buglalis/degree/img/fabrication_ready.jpg

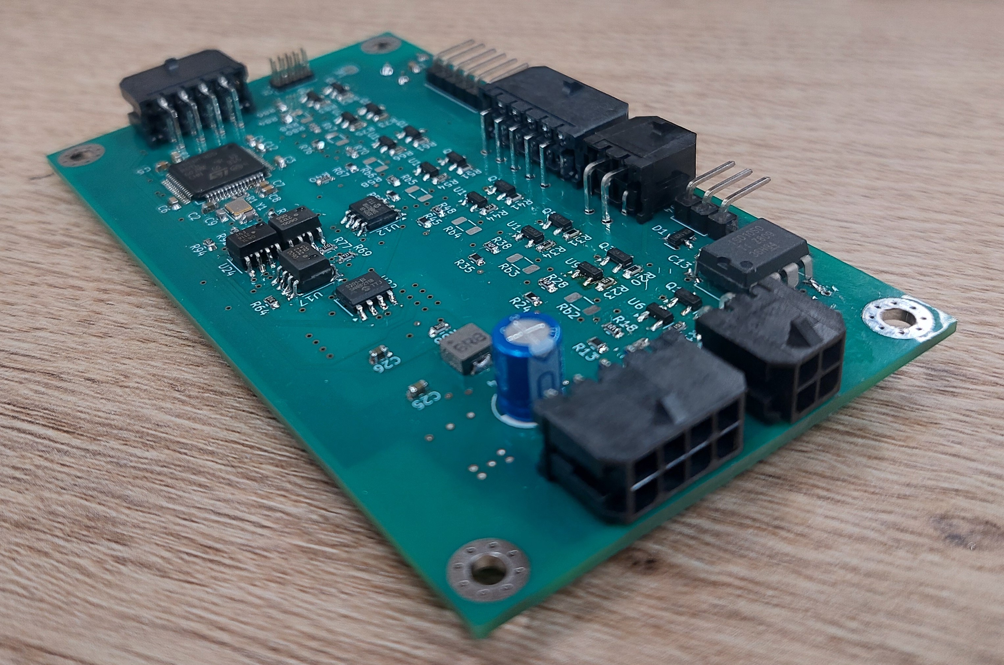
img/fabrication_ready.jpg
