buglalis/degree/img/ant_bms_1.jpg

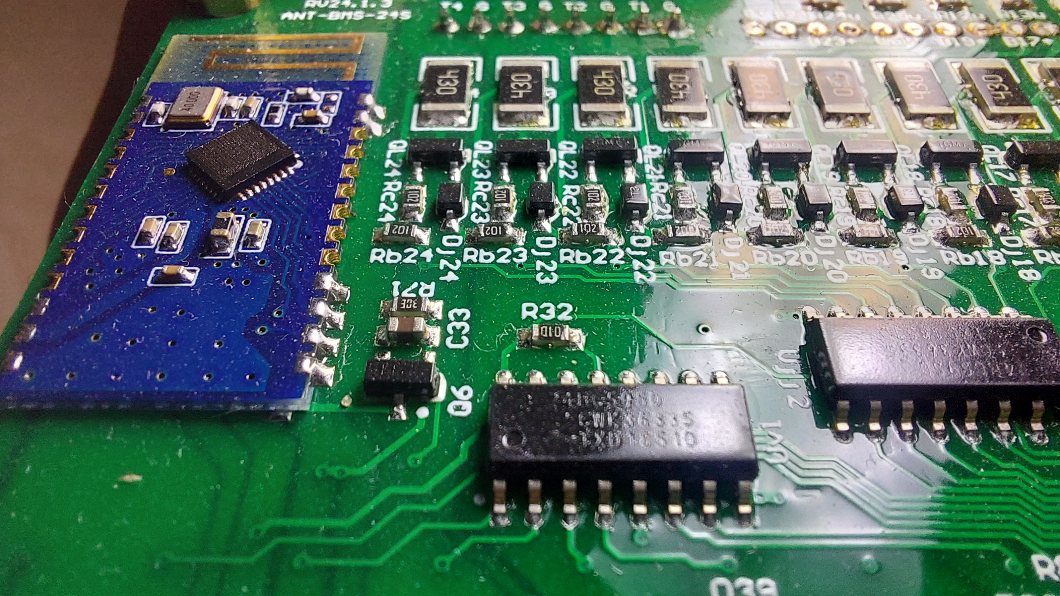
img/ant_bms_1.jpg
