buglalis/degree/notes/acronims.tex

\DeclareAcronym{bms}{
  short=BMS,
  long=Система контроля и управления аккумуляторной батареей (Battery Managment System),
}

\DeclareAcronym{soc}{
  short=SOC,
  long=State of Charge,
}

\DeclareAcronym{su}{
  short=СУ,
  long=cиловые установки,
}

\DeclareAcronym{la}{
  short=ЛА,
  long=летательный аппарат
}

\DeclareAcronym{ed}{
  short=ЭД,
  long=электродвигатель
}

\DeclareAcronym{bpla}{
  short=БПЛА,
  long=беспилотный летательный аппарат
}

\DeclareAcronym{trd}{
  short=ТРД,
  long=турбореактивный двигатель
}

% как использовать акронимы?
% 
%  \ac{name}
%  \acs{name} - короткое название
%  \acl{name} - длинное название
%
