buglalis/degree/notes/rewiew/modul.tex

\textbf{Монолитная BMS ---} разработаны для определенных конфигураций блоков. 
Например, \acs{bms} расчитана на 8-24s батарею.
Немодульные решения предполагается использовать там, 
где размер и конфигурация аккумуляторной батареи остаются постоянными. 
Они устраняют необходимость в дополнительной проводке.

\textbf{Модульная система управления ---} состоит из нескольких блоков, 
которые можно легко соединять или отключать для реализации различных конфигураций батарей. 
Это обеспечивает гибкость при создании батареи, масштабируемость, простоту обслуживания.
Однако подобные решения могут иметь большее кол-во проводки и усложнение элементов корпуса, 
что может отразится на цене и весе батареи.

Примером модульной системы является проект с отрытым исходным кодом --- Smart BMS (см. \figurename\ref{fig:smart_bms})
\begin{figure}[h]
	\centering
	\begin{minipage}{0.32\linewidth}
		
		\subcaption{Плата-slave(вид сбоку)}
	\end{minipage}
	\begin{minipage}{0.32\linewidth}
	    
	    \subcaption{Плата-slave(вид сверху)}
        \end{minipage} 	
	\begin{minipage}{0.32\linewidth}
	    
	    \subcaption{Плата-master}
    \end{minipage}
\caption{Составляющие Smart BMS}
\label{fig:smart_bms}
\end{figure}
