buglalis/degree/notes/review.tex

\section{Развитие электрических \acs{la}}
\input{notes/rewiew/la.tex}

\section{Литий-ионные батареи $-$ обзор}
\input{notes/rewiew/lion.tex}

\section{Методы баласировки}
\input{notes/rewiew/balance_sheet.tex}

\section{Способы компоновки батареи (модульность BMS)}
\input{notes/rewiew/modul.tex}

\section{Режимы работы системы \glqq батарея$-$нагрузка\grqq}
\input{notes/rewiew/mods.tex}

\section{Обзор методов активной балансировки}
\input{notes/rewiew/active_balacing.tex}

\section{Сравнение методов активной балансировки}
\input{notes/rewiew/comparison.tex}

\section{Решения сущевствующие на рынке}
\input{notes/rewiew/solutions.tex}

\section{Формализация задачи}
\input{notes/rewiew/form.tex}

% \section{Установка ограничений}
% \input{notes/rewiew/limits.tex}

% \section{Сравнение сущевствующих схем}

% \section{Поиск оптимальной конфигурации для решения конкретной задачи}
% \input{notes/rewiew/balancing_conclusion.tex}
