buglalis/degree/notes/body.tex

\section{Разработка}
\input{notes/body_notes/develop.tex}

\section{Производство}
\input{notes/body_notes/fabrication.tex}

\section{Испытания эксперементального изделия}
\section{Анализ результатов экспериментов}
