buglalis/degree/notes/comparison.tex

Для сравнения схем активной балансировки будем использовать следующие параметры
> 1) Стоимость
> 2) Габариты
> 3) Эффективность балансировки
> 4) Кол-во лап процессора на одну ячейку 
> 5) ЭМИ шум
