buglalis/degree/src/page_header.tex

\pagestyle{fancy}
\fancyhead[RE,LO]{\textsc{Физтех}}
\fancyhead[LE,RO]{\textsc{ФАЛТ}}
\fancyhead[CO,CE]{\leftmark}
