buglalis/degree/notes/body_notes/develop.tex

Как было сказано выше, для разработки была выбрана пассивная BMS.
В качестве микросхемы для определения порогового напряжения была выбрана TL-431. 
\subsubsection{Краткое описание микросхемы:}
Регулируемый источник опорного напряжения.
Используется для мониторинга напряжения на ячейке, сигнал выдаваемый схемой имеет нелинейную 
зависимость(см. \figurename  \ref{fig:tl431_curve_cathode_v_i}). 
На кривой видно, что при напряжении 2.5В и более на K-Ref, ток K-A максимален, 
источник опорного напряжения пропускает ток.

\begin{figure}[h]
	\centering
	\begin{minipage}{0.54\linewidth}
		
		\subcaption{Распиновка TL431A}
		\label{fig:tl431_pinout}
	\end{minipage}
	\begin{minipage}{0.45\linewidth}
        \centering
        
        \subcaption{Зависимость тока от напряжения на катоде}
        \label{fig:tl431_curve_cathode_v_i}
    \end{minipage}
\caption{TL431}
\label{fig:tl431_review}
\end{figure}

\subsubsection{Описание работы принципиальной схемы}
Балансировочная схема состоит из двух частей:
ключ с балансировояным резистром и триггер Шмитта, 
который настроен на разрядку ячейки в некотором диапазоне напряжений.
Ключом явлется полевой N-MOSFET транзистор $Q_2$, через него проходит ток балансировки. 
Значение тока балансировки настраивается номиналом балансировочного резистра $R_b$.
В триггер Шмитта входят все остальные элементы, а именно: резистры $R_1$ - $R_6$, 
биполярный pnp транзистор $Q_1$ и $TL431$.

Ниже представлена принципиальная балансировочная (см. \figurename  \ref{fig:principial})
\begin{figure}[h!]
    \centering
    
    \caption{Принципиальная схема балансровки}
    \label{fig:principial}
\end{figure}

Схема имеет выраженный гистерезис $-$ балансировка начинается при более высоком напряжении чем закачивается.

\subsubsection{Поэтапный алгоритм работы схемы}
Для описания алгоритма введём следующие величины: \\
$V_{\text{bat}}$ -- напряжение ячейки. \\
$(V_1, V_2)$ -- диапазон балансировки. \\
$V_{ref}$  -- опорное напряжение $TL431$ равное 2.5В
При достижении $V_2$ балансировка начинается, когда падает до $V_1$ балансировка выключается.

\begin{enumerate}
    \item \textbf{Состояние 0}: напряжение $V_{\text{bat}}$ значительно меньше $V_2$ (см. рис.~\ref{fig:algoritm_part_0}). \\
    Ток не идёт через $Q_1$, $Q_2$, $TL431$. \\
    Напряжение на съёмном плече делителя напряжения, обозначенного синей рамкой, меньше 2.5~В.

    \item \textbf{Состояние 1}: напряжение $V_{\text{bat}}$ увеличивается и подходит близко к $V_2$.
    $TL431$ начинает пропускать слабый ток, который в том числе проходит и через транзистор $Q_1$.
    Получаем лавинообразный процесс. Чем больше ток через $TL431$, тем больше ток через $Q_1$. 
    Тем выше напряжение на контакте REF $TL431$. И наконец, тем выше ток через $TL431$.

    \item \textbf{Состояние 2}: \\
    Ток базы на $Q_1$ становится достаточным для его открытия. Напряжение доходит до резистора $R_4$.
    Тем самым резисторы $R_3$, $R_4$, $R_5$ образуют новый делитель напряжения. 
    
\end{enumerate}

\begin{figure}[h!]
	\centering
	\begin{minipage}{0.5\linewidth}
		
		\subcaption{Напряжение ниже диапазона балансировки}
		\label{fig:algoritm_part_0}
	\end{minipage}
    \begin{minipage}{0.49\linewidth}
        \centering
        
        \subcaption{Инициация открытия $Q_1$}
        \label{fig:algoritm_part_1}
    \end{minipage}
	\begin{minipage}{0.49\linewidth}
        \centering
        
        \subcaption{ключ $Q_2$ открыт}
        \label{fig:algoritm_part_2}
    \end{minipage}
    \begin{minipage}{0.5\linewidth}
        \centering
        
        \subcaption{}
        \label{fig:algoritm_part_3}
    \end{minipage}
    \caption{состояния схемы}
    \label{fig:balance_algoritm}
\end{figure}

\subsubsection{Расчёт компонентов}
Резистор $R_6$ является подтягивающим, его номинал не влияет на остальную схему, 
номинал выбран стандартный -- 10k$\Omega$ \\
Номиналы резистров $R_3$, $R_4$, $R_5$ выбираются изходя из выбраного диапазона балансировки ($V_1 = 4.15$ В  $, V_2 = 4.21$ В).
Из пропорции для делителей напряжения получаем отношения для сопротивлений, 
которые необходимо брать порядка нескольких k$\Omega$, чтобы ток через делитель был незначительным.

\begin{figure}[h]
    \begin{equation*}
        \frac{V_2}{V_{ref}} = \frac{R_3 + R_5}{R_5} \\
    \end{equation*}
    \begin{equation*}
        \frac{V_1}{V_{ref}} = \frac{\frac{R_3 R_4}{R_3+R_4} + R_5}{R_5}  \\
    \end{equation*}
\end{figure}

Получаем  
\begin{figure}[!h]
    \begin{equation*}
        R_3 = \left(\frac{4.21}{2.5} - 1 \right) R_5 \\
    \end{equation*}
    \begin{equation*}
        R_4 = \frac{R_3 R_5  \left(\frac{4.17}{2.5} - 1\right)}{R_3 - \left(\frac{4.17}{2.5} - 1\right) R_5}
    \end{equation*}
    
\end{figure} 

Приняв номинал $R_5$ за 12k$\Omega$, получим $R_3 \approx$ 8.2k$\Omega$, $R_4 \approx$ 220k$\Omega$

\newpage
