buglalis/degree/notes/rewiew/active_balacing.tex

Для начала расмотрим два простейших метода: через электрический конденсатор или катушку индуктивности.
Под "простейшими" подразумевается, что конденсатор или катушка будет переносить энергию от одной ячейки к другой напрямую. 
При этом электрическая схема и алгоритм балансировки наиболее простой.

\subsection{Ёмкостные схемы}
\setlength{\headheight}{14pt}
    Самый примитивный способ переноса заряда между ячейками $-$ через конденсатор. (см. \figurename\ref{fig:capasitors_models})
Простейшая схема состоит из единственного конденсатра, который с помощью ключей соединяется с разными ячейками поочередно.
Метод не требует сложного управления. Энергия передаваемая от одной ячейке к другой эквивалентна разнице напряжений.
Важно только выдерживать допустимую частоту переключения, которая зависит от характерного времени цикла зарядки/разрядки. 
Метод имеет огромный недостаток, чем меньше разбаланс $-$ тем медленнее переносится энергия. 
Не смотря на довольно высокую точность порядка 1мВ, дисбаланс в 10 мВ устранялся в течении 19 часов (см. статью \cite{daowd2013single}).\\
На практике используется схема из несколькольких рядов конденсаторов, время балансировки около удовлетварительное.
Например, $n$ ячеек $n-1$ ёмкостей для 1-го ряда и $n-2$ для 2-го ряда, или только первый ряд.
Тут имеет место компромисс между стоимостью и временем выравнивания $-$ четырехкратное уменьшение времени выравнивания 
при увеличении емкости всего на 50\% (см. статью\cite{baughman2008double}), (см. \figurename\ref{fig:capacitors_res}).
Двухуровневая схема балансирует быстрее одноуровневой за счет уменьшения тока на ёмкостях 1-го ряда.
Стоимость реализации двухуровневого метода
несколько выше за счёт большего кол-ва конденсаторов и переключателей.

\begin{figure}[h]
	\centering
	\begin{minipage}{0.25\linewidth}
		
		\subcaption{Один ряд конденсаторов}
        \label{fig:capasitors_models_single}
	\end{minipage}
	\begin{minipage}{0.34\linewidth}
	    
	    \subcaption{Два ряда конденсаторов}
        \label{fig:capasitors_models_double}
    \end{minipage} \\	
    \caption{Схемы на конденсаторах}
    \label{fig:capasitors_models}
\end{figure} 

Рассмотрим схему с двумя рядами конденсаторов. 
Заряд, передаваемый от батареи к батарее проходит через ярусы конденсаторов. Чем больше рядов, тем меньше сопротивление для переноса заряда и тем больше путей переноса заряда.
Например расмотрим \figurename\ref{fig:capasitors_models_single}. 
Заряд от $B_3$ к $B_1$ не может поступать напрямую, в отличие от схемы с двумя рядами (см. \figurename\ref{fig:capasitors_models_double}).

\begin{figure}[h!]
	\centering
	\begin{minipage}{0.49\linewidth}
	    
	    \subcaption{Зависимость тока от частоты}
        \label{fig:capacitor}
    \end{minipage} 
    \begin{minipage}{0.5\linewidth}
	    
	    \subcaption{Сравнение скоростей балансировки}
        \label{fig:capacitors_res}
    \end{minipage} \\	
    \begin{minipage}{0.4\linewidth}
		
		\subcaption{График модели RC цепи}
        \label{fig:capasitor_graph}
	\end{minipage}
\end{figure} 

Нас интересует результирующий средний ток, который расчитывается на основе частоты переключения.
Такой ток и будет называться балансировочным. 
Даже если усредненный по времени ток через любой конденсатор равен нулю, ток
входит в конденсатор через одну батарею или один набор батарей
и выходит через другую. Таким образом, ток использует
конденсатор как путь между батареями(см. \cite{kimball2005analysis}, \cite{kimball2005modeling})

\begin{align*}
    I_C = C \frac{\Delta V}{\Delta t} = C \Bigl( V'_{C_A} -  V'_{C_B} \Bigr) \nu_{switch}
\end{align*} 

Где напряжения $V'_{C_A}, V'_{C_B}$ описывают граничные напряжения в графике зарядки/разрядки конденсатора,
на графике \figurename\ref{fig:capasitor_graph} процесс моделируется простой RC цепочкой.

\subsection{Схемы на индуктивностях}
    Метод подключения аналогичен ёмкостному. 
Такой подход реализует принцип хранения энергии в магнитном поле катушки.
Эффективность этого метода напрямую зависит от точности определения напряжений на ячейках.
Стоит отметить, что при повышении частоты в схему необходимо включить фильтрующие конденсаторы.
Метод требует более сложного алгоритма управления, имеет большую скорость балансировки чем ёмкостной метод.

\begin{figure}[h!]
    \centering
    
    \caption{Схема балансировки на одном дросселе}
    \label{fig:inductions_models}
\end{figure}

\cite{noh2021design}, \cite{vardhan2017modeling}

% {PowerPump}

\subsection{Схемы на трансформаторах}
Ключевые моменты{Быстро балансирует, высокий КПД(греется но не так сильно как остальные), 
компактность, дорого стоит, нужно подбирать сердечник под кол-во ячеек в параллели}
(см. статью \cite{abronzini2019high})

% forward, flyback
Теперь остановимся на преобразователях постоянного тока, 
В таких схемах используются те же конденсаторы, катушки и трансформаторы, 
однако управление такими схемами достаточно сложное, необходимо использовать высокие частоты,
часто появляется задача изучить переходные процессы между состояниями электрической схемы. 
\subsection{Импульсные DC/DC преобразователи}
Можно выделить 4 очень похожих друг на друга схемы: повышающий и (или) понижающий (Buck or/and Boost converter), 
и инвертирующий ({\'C}uk) конвертеры.
В данной работе будет рассмотрен только {\'C}uk конвертер. 
Остальные схемы будут схожи в управлении.

\subsubsection{Принцип работы балансировки по схеме Чука}
Расмотрим простейшую схему из 2 ячеек. 
На затвор $Q_1$ и $Q_2$ приходит ШИМ. С одинаковым коэффициентом заполнения и инвертированным друг относительно друга.
Передача энергии может идти в обе стороны. 
Направление и величина тока определяется коэффициентом заполнения и частоты ШИМ - $\alpha$(см. выкладки ниже).
Вывод произведен упрощённым методом для усреднённой модели.

\begin{align*}
\intertext{$Q_1$ открыт, $Q_2$ закрыт}
    U_1 &= L_1 \dv{i_{L_1}}{t} \\
    U_2 &= -L_2 \dv{i_{L_2}}{t} + V_C \\
\intertext{$Q_1$ закрыт, $Q_2$ открыт} 
    U_1 &= L_1 \dv{i_{L_1}}{t} + V_C \\
    U_2 &= -L_2 \dv{i_{L_2}}{t} 
\end{align*} 
\begin{gather*}
\intertext{Равенство нулю вольт-секундного интеграла на $L_1$ и $L_2$} 
    \frac{1}{T}\int_0^T V_L \mathrm{d}t =  \overline V_L \\
    U_1 \alpha \nu + (U_1 - V_C)(1 - \alpha) \nu = 0 \\
    -(U_2 + V_C) \alpha \nu + (-U_2)(1 - \alpha) \nu = 0
\end{gather*}
\begin{gather*}
\intertext{Выразим средний ток на катушках через равенство напряжений на конденсаторе $C$} 
    i_{L_1}(1 - \alpha) \nu_{sw} - i_{L_2}\alpha \nu_{sw} = 0 \\
    i_{L_1} = \frac{1}{2} \Biggl[\frac{U_1}{L_1} \alpha^2 + \frac{U_1 - V_C}{L_1}\left( 1 - \alpha\right)^2 \Biggr] \nu_{sw} \\
    i_{L_2} = \frac{1}{2} \Biggl[\frac{V_C - U_2}{L_2} \alpha^2 + \frac{-U_2}{L_2}\left( 1 - \alpha\right)^2 \Biggr] \nu_{sw}
\end{gather*} 
Таким образом на каждой из ячеек начинаются колебания как в $LC$ цепочках. 
За счёт ШИМа среднее значение токов смещается в верх для более заряженой ячейки и вниз для менее заряженой. (см. \figurename\ref{fig:cuk_transit}).
Подробнее про этот метод в статье \cite{moghaddam2019battery}, а также симуляция в Falstad \href{\cuksheme}{\color{blue}{"ссылка"}}.

\begin{figure}[h!]
    \centering
    
    \caption{Переходный процесс во время балансировки методом Чука}
    \label{fig:cuk_transit}
\end{figure}

\subsection{Полномостовой преобразователь}

\subsection{Рамповый преобразователь}

\subsection{Квази-резонансный преобразователь}
