buglalis/degree/notes/rewiew/lion.tex

% За последние десятилетия литий-ионные аккумуляторы превратились из дорогих и не распространённых 
% в стандартные источники питания, используемые в самых различных областях. 
% Стоит сразу отметить, что для литий-ионного аккумулятора характерна высокая пожароопасность, об этом будет сказано ниже. \\
% Несмотря на то технология литиевых источников тока была известна достаточно давно, 
% и в конце XX века литиевые батареи активно использовались в различных устройствах.
% Только в 1991 году Акира Ёсино изобрёл литий-ионный аккумулятор, который широко используется сегодня. 
% Данная технология позволила значительно увеличить плотность энергии. (см. статью\cite{admt_201700376} ). 

% Как бы хорошо не был «укрощен» литий, аккумулятор остаётся опасным устройством, 
% так как в его составе находятся сильный окислитель и восстановитель, разделённые тонким полимерным сепаратором. 
% При нарушении целостности сепаратора происходит каскадная реакция, сопровождаемая нагревом.
% Содержимое аккумулятора превращается в первокласную взрывчатую смесь топлива и окислителя. И эту субстанцию уже подожгли.
% Существует много встроенных мер обеспечения безопасности Li-ion аккумуляторов, которые работают автономно.
% Но литий-ионные аккумуляторы остаются достаточно чуствительными к небрежной эксплуатации. 
% Там, где применяется литий-ионный аккумулятор, нет места простейшим зарядным устройствам из мира «свинца» и «никель-кадмия». 
% Зарядное устройство обязано быть «умным». Процесс зарядки литий-ионного аккумулятора многостадийный, 
% предполагает строгое выдерживание параметров, должен быть вовремя завершен. Перекладывание ответственности на пользователя не допустимо.

% Основными проблемами эксплуатации можно назвать перезаряд и переразряд.
% Иначе можно сказать, что важно выдерживать оптимальный диапазон напряжений при работе с аккумулятором.
% Перенапряжение в ячейке приводит к электролизу компонентов электролита и дальнейшему выделению газов, 
% давление которых может нарушить герметичность аккумулятора, 
% это также приводит к пожару так как получившая смесь графита и лития самовоспламеняется на воздухе.
% При больших токах разряда(графит не успевает «впитывать» литий) 
% и при переразряде(графит теряет активную поверхность) образуется металлическая фаза лития, 
% которая в дальнейшем приводит к образованию дендритов(древовидные образования) нарушающих обшивку аккумулятора. 
% Опасна и перегрузка во время разряда. 
% Перегрев вызывает вскипание или термическое разложение электролита, 
% выделение кислорода из катодной активной массы, повреждение сепаратора. В результате -- короткое замыкание и взрыв. 
% Подобные результат будет при повреждении ячейки, только к окислителю добавится кислород из атмосферы.

% В последние десятилетия литий-ионные аккумуляторы прошли путь от дорогостоящей и малораспространённой технологии 
% до универсального источника питания, применяемого в самых разнообразных сферах.

% Стоит отметить, что одним из ключевых недостатков литий-ионных батарей является их высокая пожароопасность, 
% что подробно рассмотрено далее.

% Хотя принципы работы литиевых источников тока были известны уже давно, 
% лишь к концу XX века литиевые батареи начали активно использоваться в электронике. 
% Прорыв в этой области произошёл в 1991 году, когда Акира Ёсино разработал литий-ионный аккумулятор, 
% ставший основой для современных энергоносителей. 
% Внедрение этой технологии позволило существенно увеличить плотность хранения энергии (см. статью \cite{admt_201700376}).

% Несмотря на успешное решение многих технических проблем, литий-ионные аккумуляторы остаются потенциально опасными устройствами. 
% Это обусловлено тем, что в их конструкции содержатся мощные окислитель и восстановитель, разделённые тонким полимерным сепаратором. 
% Если его целостность нарушается, запускается каскадная реакция, сопровождающаяся интенсивным нагревом. 
% В результате содержимое аккумулятора превращается в высокоэнергетическую смесь топлива и окислителя, готовую к воспламенению.

% Для снижения рисков в конструкции Li-ion батарей предусмотрено множество автономных систем безопасности. 
% Однако, несмотря на эти меры предосторожности, аккумуляторы остаются весьма чувствительными к неправильной эксплуатации. 
% Они требуют использования специализированных зарядных устройств, 
% поскольку применение примитивных аналогов, разработанных для свинцово-кислотных или никель-кадмиевых батарей, 
% может привести к катастрофическим последствиям. Процесс зарядки литий-ионных элементов многостадийный и требует точного 
% соблюдения параметров, исключая возможность случайных ошибок со стороны пользователя.

% К числу основных эксплуатационных проблем можно отнести перезаряд и переразряд. 
% Оптимальный диапазон напряжений должен строго выдерживаться при работе с аккумулятором. 
% Перенапряжение внутри ячейки способно вызвать электролиз компонентов электролита с последующим выделением газов, 
% что может привести к разгерметизации батареи и возникновению пожара. Это обусловлено тем, что смесь лития и графита, 
% оказавшись в контакте с воздухом, самовоспламеняется.

% Высокие токи разряда или глубокий переразряд также представляют серьёзную угрозу. 
% В первом случае графитовая структура не успевает поглощать литий, 
% а во втором теряет активную поверхность, что способствует образованию металлической фазы лития. 
% Со временем это может привести к росту дендритов — иглообразных кристаллов, разрушающих оболочку аккумулятора.

% Не менее опасна перегрузка во время разряда. Перегрев приводит к закипанию или термическому разложению электролита, 
% выделению кислорода из катодного материала и разрушению сепаратора. 
% Всё это ведёт к короткому замыканию и возможному взрыву. 
% Если же повреждение ячейки сопровождается попаданием кислорода из окружающей среды, 
% вероятность возгорания возрастает многократно.

% Перегрев вызывает вскипание или термическое разложение электролита, 
% выделение кислорода из катодной активной массы, повреждение сепаратора. В результате -- короткое замыкание и взрыв. 
% Подобные результат будет при повреждении ячейки, только к окислителю добавится кислород из атмосферы.

В последние десятилетия литий-ионные аккумуляторы прошли путь от дорогостоящей и малораспространённой технологии 
до универсального источника питания, применяемого в самых разнообразных сферах. 
Стоит отметить, что одним из ключевых недостатков литий-ионных батарей является их высокая пожароопасность, 
об этом будет сказано ниже.

Хотя принципы работы литиевых источников тока были известны уже давно, 
лишь к концу XX века литиевые батареи начали повсеместно использоваться в электронике. 
Прорыв в этой области произошёл в 1991 году, когда Акира Ёсино разработал литий-ионный аккумулятор, 
ставший основой для современных энергоносителей. 
Внедрение этой технологии позволило существенно увеличить плотность хранения энергии (см. статью \cite{admt_201700376}).

Несмотря на наличие встроенных мер безопасности, литий-ионные аккумуляторы остаются потенциально опасными устройствами. 
Это обусловлено тем, что в их конструкции содержатся мощные окислитель и восстановитель, разделённые тонким полимерным сепаратором. 
Если его целостность нарушается, запускается каскадная реакция, сопровождающаяся интенсивным нагревом. 
В результате содержимое аккумулятора превращается в высокоэнергетическую смесь топлива и окислителя, готовую к воспламенению.

Для снижения рисков в конструкции Li-ion батарей предусмотрено множество автономных систем безопасности. 
Однако, несмотря на эти меры предосторожности, аккумуляторы остаются весьма чувствительными к неправильной эксплуатации. 
Они требуют использования специализированных зарядных устройств, 
тут нет места простейшим зарядным устройствам из мира автомобильных свинцовых аккумуляторов.
Процесс зарядки литий-ионных элементов многостадийный и требует точного 
соблюдения параметров, исключая возможность случайных ошибок со стороны пользователя.

Основными эксплуатационными проблемами аккумуляторов можно считать их перезаряд и переразряд. 
Иными словами, критически важно соблюдать оптимальный диапазон рабочих напряжений.

Если внутри ячейки возникает перенапряжение, 
это запускает процессы электролиза компонентов электролита, 
сопровождающиеся выделением газов. В результате возможна разгерметизация батареи и возгорание. 
Взаимодействие высвободившейся смеси графита и лития с воздухом ведёт к самопроизвольному воспламенению.

При высоких токах разряда (из-за неспособности графита быстро поглощать литий) 
или глубоком переразряде (когда графит теряет активную поверхность) происходит образование металлического лития. 
В дальнейшем это способствует появлению дендритов – своеобразных древовидных структур, которые проникают сквозь оболочку аккумулятора, нарушая её целостность.

Не менее серьёзной угрозой является перегрузка в процессе разряда. 
Перегрев приводит к закипанию или термическому разложению электролита,
выделению кислорода из катодного материала и разрушению сепаратора. 
Итог – короткое замыкание и возможный взрыв. 
Если повреждение сопровождается доступом кислорода из атмосферы, интенсивность реакции значительно возрастает.

Дополнительные сложности возникают при зарядке батареи, 
состоящей из нескольких последовательно соединённых блоков. 
Даже элементы из одной производственной партии неизбежно имеют разброс по ёмкости, 
что приводит к разной скорости их зарядки и ускоренному износу. 
Со временем дисбаланс блоков накапливается, вызывая перезаряд отдельных ячеек – а это, как уже упоминалось, крайне нежелательно.

% Для решения данной проблемы применяется балансировка – метод выдерживания одинакового напряжения 
% или уровня заряда (\ac{soc}) на всех блоках батареи.

Исходя из всех вышеперечисленных негативных факторов можем сделать вывод, 
что система управления батареей критически необходима как для увеличения
жизненного цикла так и для сохранения доступной емкости батареи. Она определяет
напряжение батареи, заряд батареи, температуру батареи, имеет защиту от перенапряжения и выполняет некоторые другие задачи.
