buglalis/degree/notes/rewiew/solutions.tex

\subsubsection{Tesla}
\input{notes/solutions/tesla.tex}

\subsubsection{FinDreams Group. Дочернее подразделение BYD}
\input{notes/solutions/byd_bms.tex}

\subsubsection{AntBMS}
\input{notes/solutions/ant_bms.tex}

\subsubsection{Зарядные комбайны IMAX}
\begin{comment}
    sfsfsfsdfsdfs 
\end{comment}
