buglalis/degree/notes/rewiew/passive_balacing.tex

Данный метод прост в реализации. На каждую ячейку приходится балансировочный резистор, 
на котором рассеивается лишняя энергия.
Схема запускает балансировку в нужном диапазоне напряжений.
(подробнее про пассивную балансировку в статье \cite{8898267})

% \begin{figure}[!h]
%     \centering
%     \includegraphics[width=0.4\linewidth]{img/chem_pass_tl431.png}
%     \caption{Простая пассивная БМС}
%     \label{fig:tl431}
% \end{figure}
