buglalis/degree/notes/rewiew/balancing_conclusion.tex

Теперь задача выявить наиболее подходящий метод балансировки.
В статье \cite{daowd2011passive} представлен обзор и сравнение различных способов 
балансировки на основе моделирования в MATLAB Simulink. 
Сравнение проводилось в соответствии с симуляцией балансировки, 
практической реализацией, применением, скоростью балансировки, сложностью, стоимостью, габаритами, 
эффективностью, характерными рабочими токами и напряжениями.
