buglalis/degree/notes/rewiew/limits.tex

В рамках данной работы предполагается использование батареи, состоящей из ячеек модели
INR-21700-P42A (\hyperref[app:INR21700]{Приложение A}) \\
Конфигурация батареи kSnP -- представляет собой k последовательных блоков, \\
каждый из которых включает n параллельных ячеек (где k составляет порядка 10, а n — от 20 до 30)
Конечная сборка с учетом тока балансировки, рекомендуемого производителем Li-ion батарей, должна иметь балансировочный ток от 0.5n до 1.5n ампер. 
Однако в случае пассивной балансировки ток балансировки будет ограничен мощностью балансировочных резистров.
