buglalis/degree/notes/solutions/ant_bms.tex

\begin{figure}[!h]
    \centering
    
    \caption{Модуль пассивной балансировки от компании AntBMS}
    \label{fig:antbms}
\end{figure}
