buglalis/degree/img/andbms.jpg

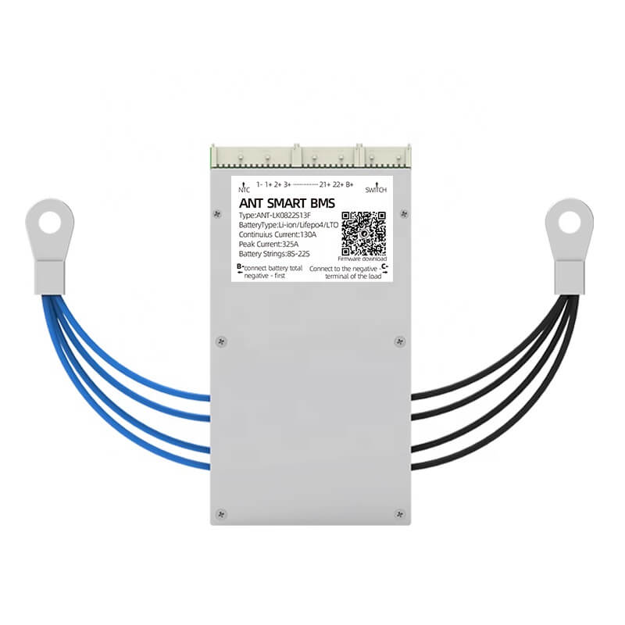
img/andbms.jpg
