buglalis/degree/img/ant_bms.jpg

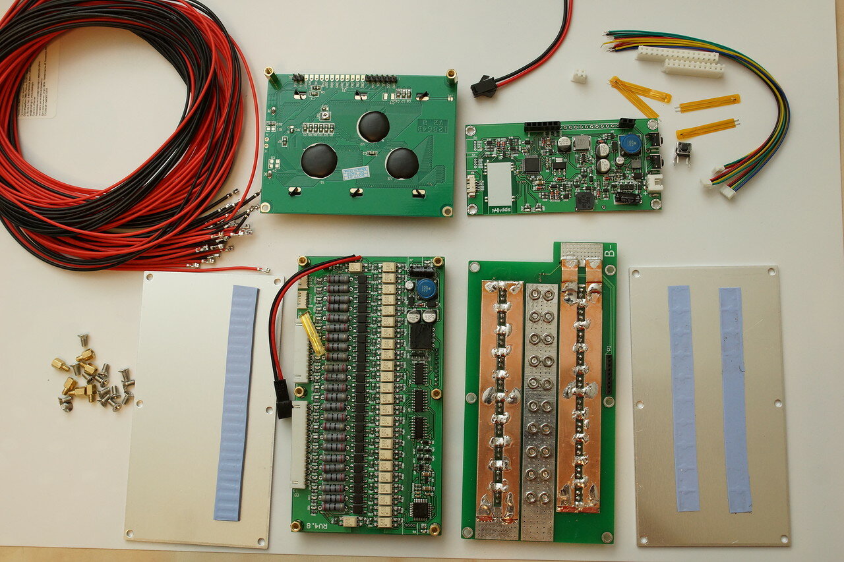
img/ant_bms.jpg
