buglalis/degree/img/battery_work_modes.png

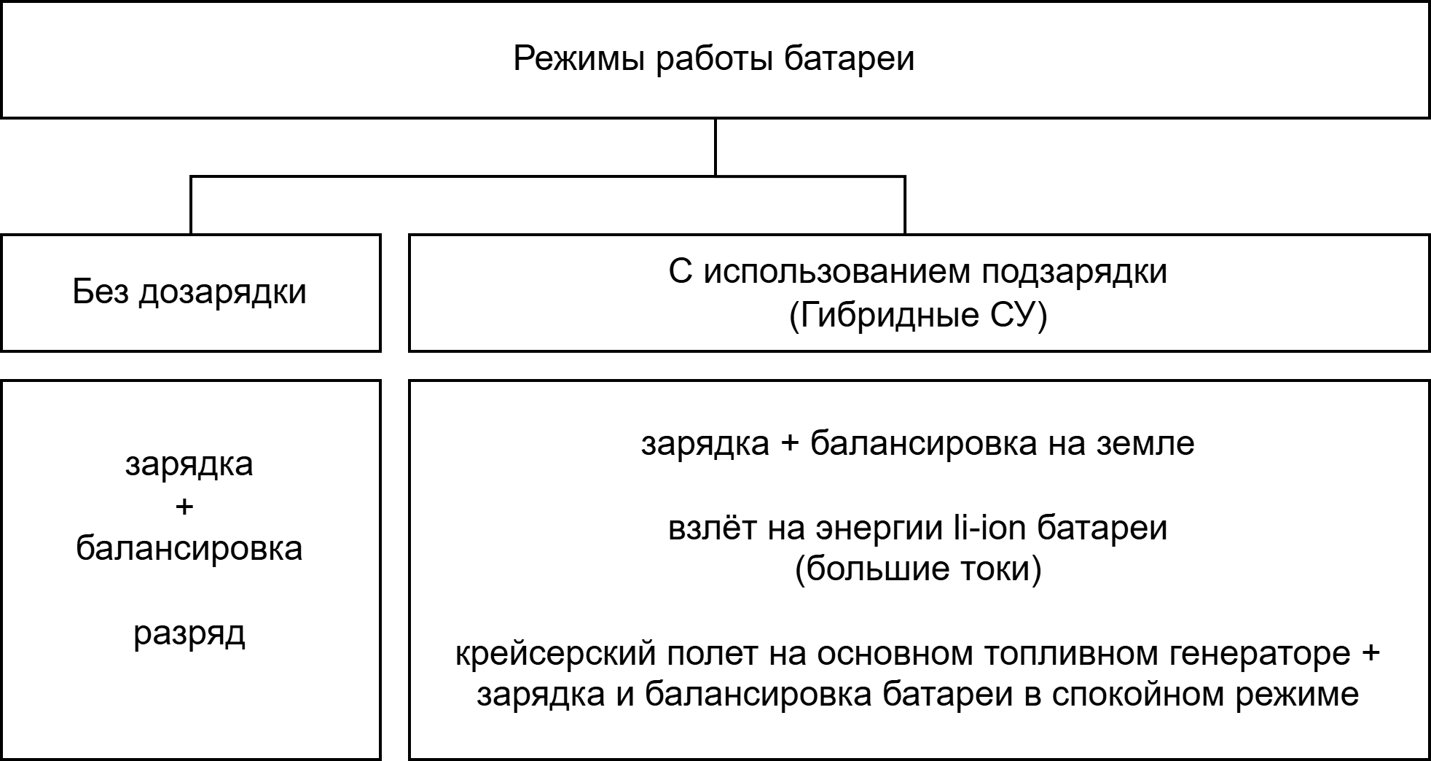
img/battery_work_modes.png
