buglalis/degree/img/capacitor_double_current_graph.png

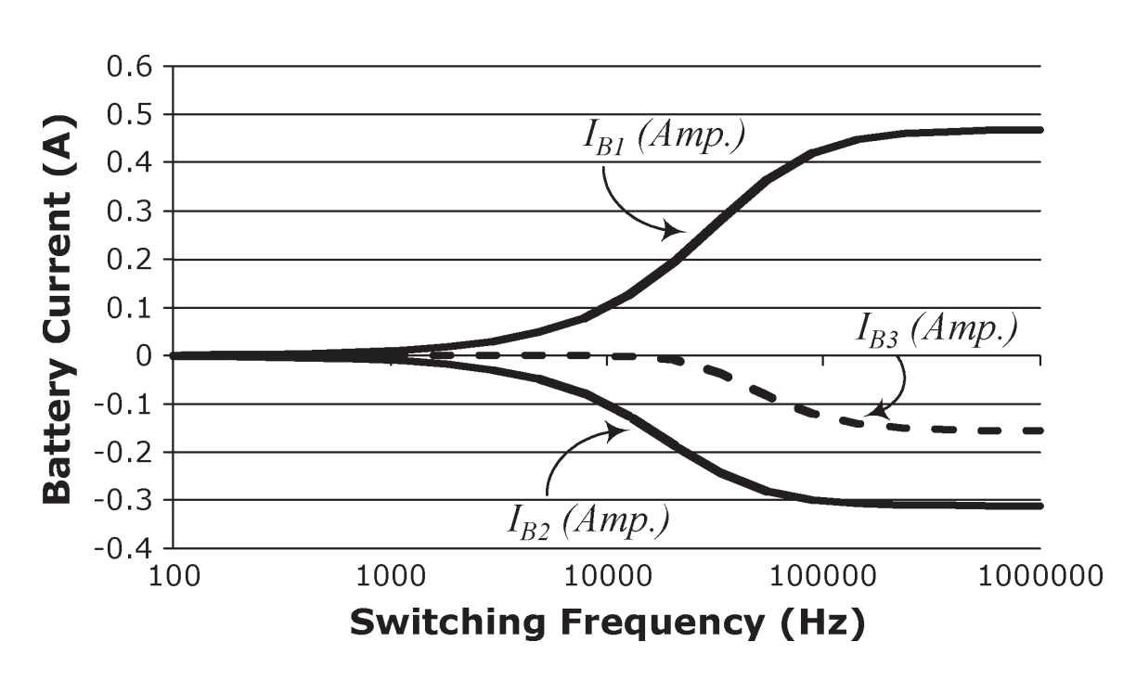
img/capacitor_double_current_graph.png
