buglalis/degree/img/capacitor_graph.png

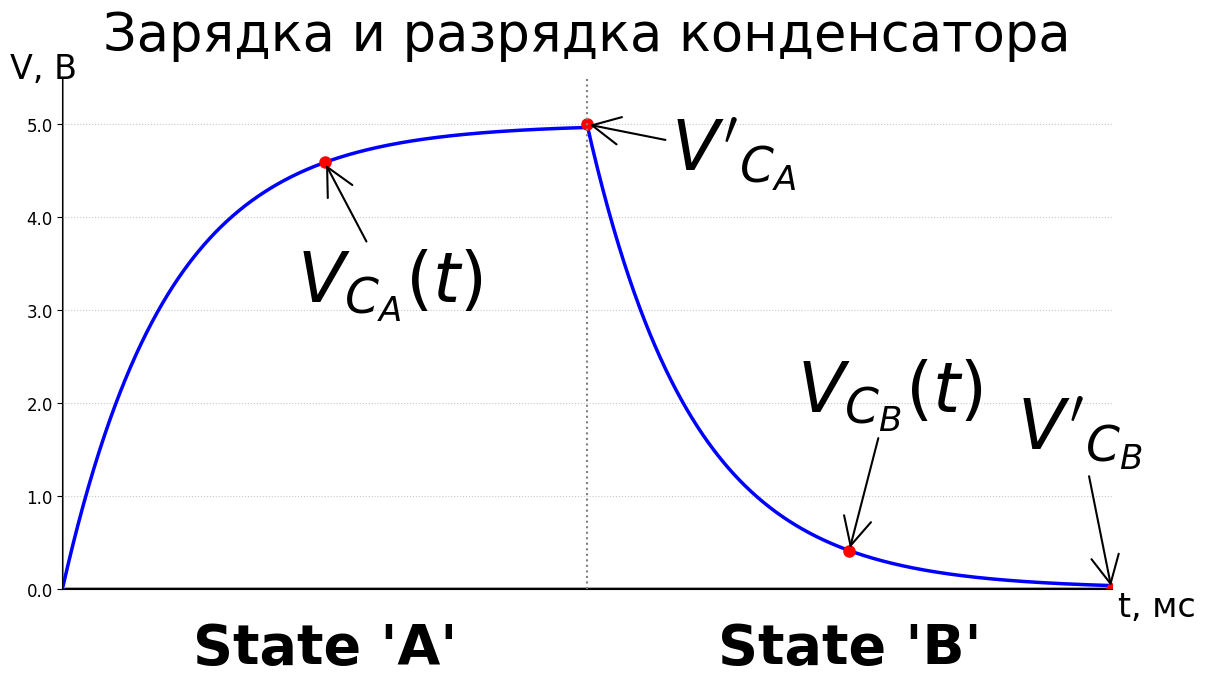
img/capacitor_graph.png
