buglalis/degree/img/chem_pass_tl431.png

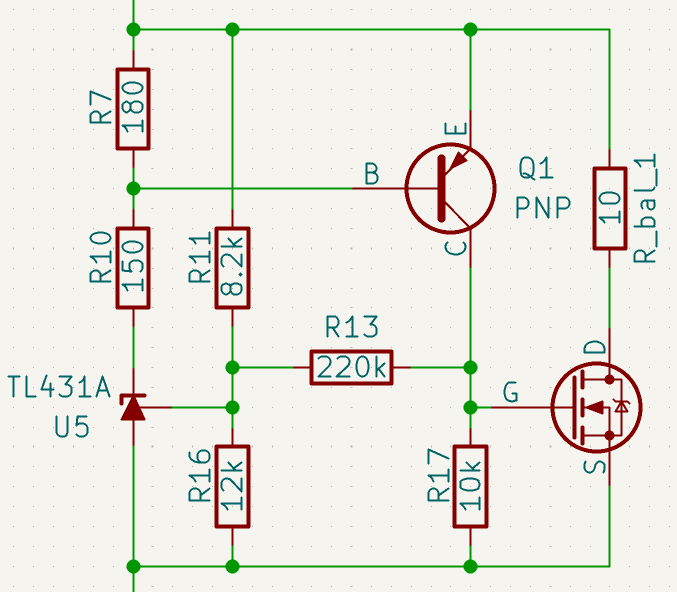
img/chem_pass_tl431.png
