buglalis/degree/img/classification.png

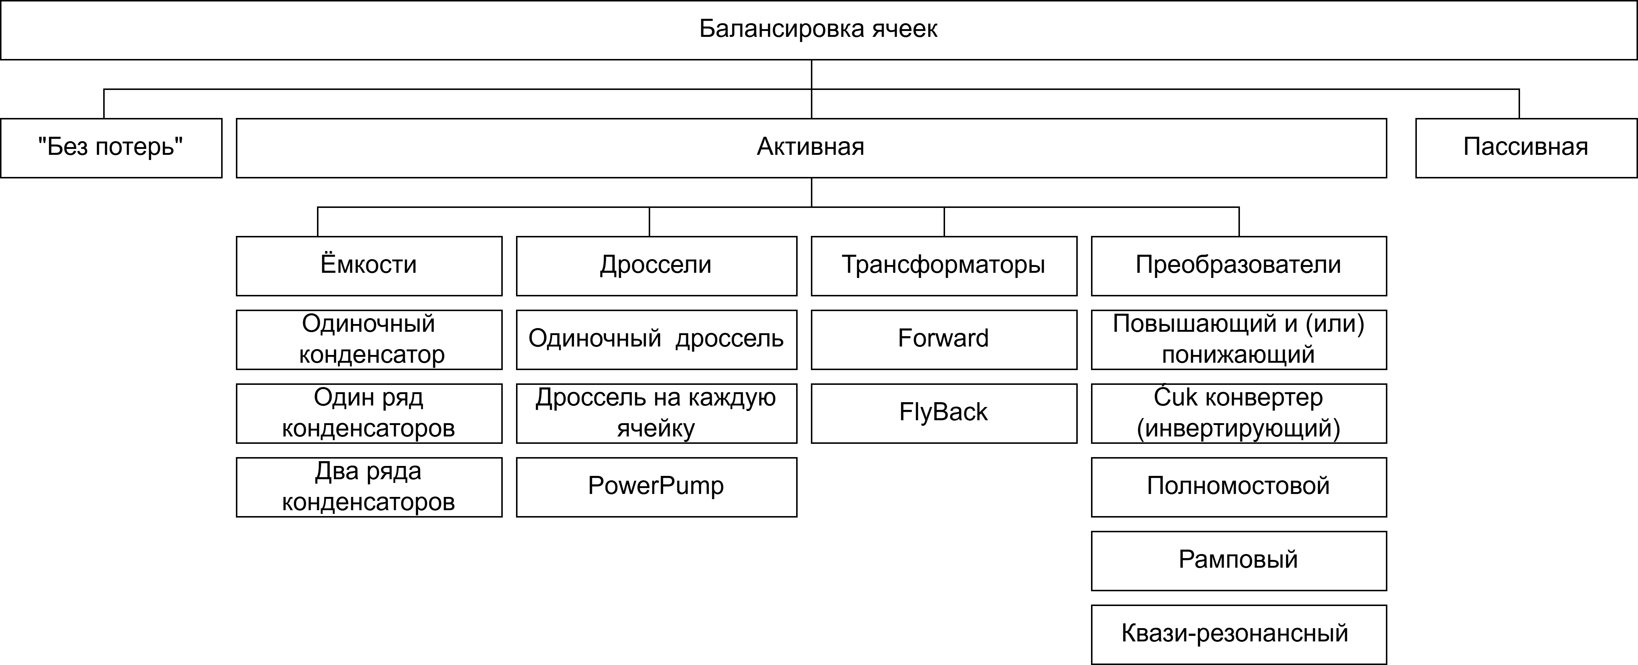
img/classification.png
