buglalis/degree/img/cuk_transit.png

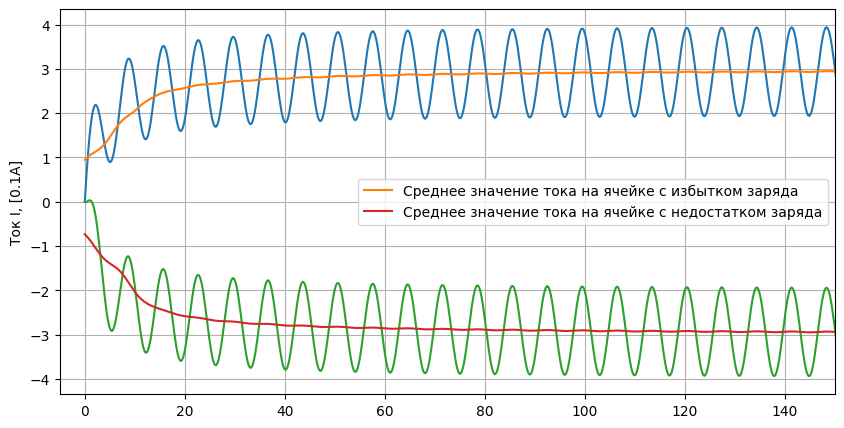
img/cuk_transit.png
