buglalis/degree/img/dev/6a07934e37db35c97c004ad1f6a1a541.jpg

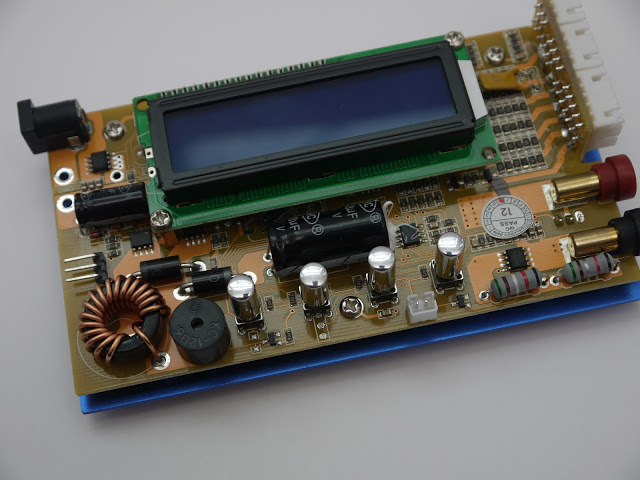
img/dev/6a07934e37db35c97c004ad1f6a1a541.jpg
