buglalis/degree/img/dev/9ff376ee6eb3e5e777621d95c8e0c6c2.jpg

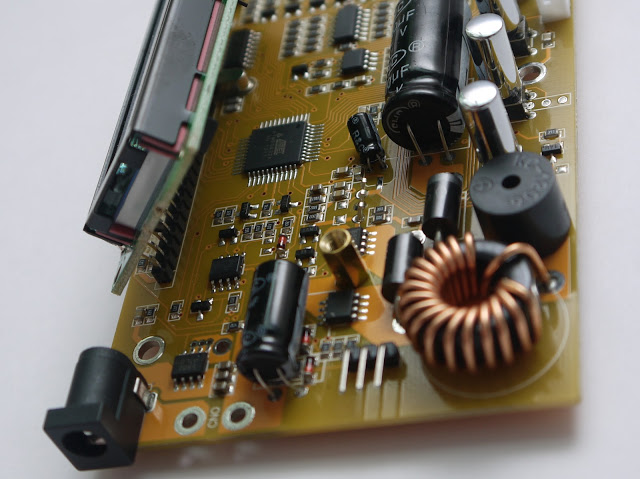
img/dev/9ff376ee6eb3e5e777621d95c8e0c6c2.jpg
