buglalis/degree/img/dev/GOST_intro.png

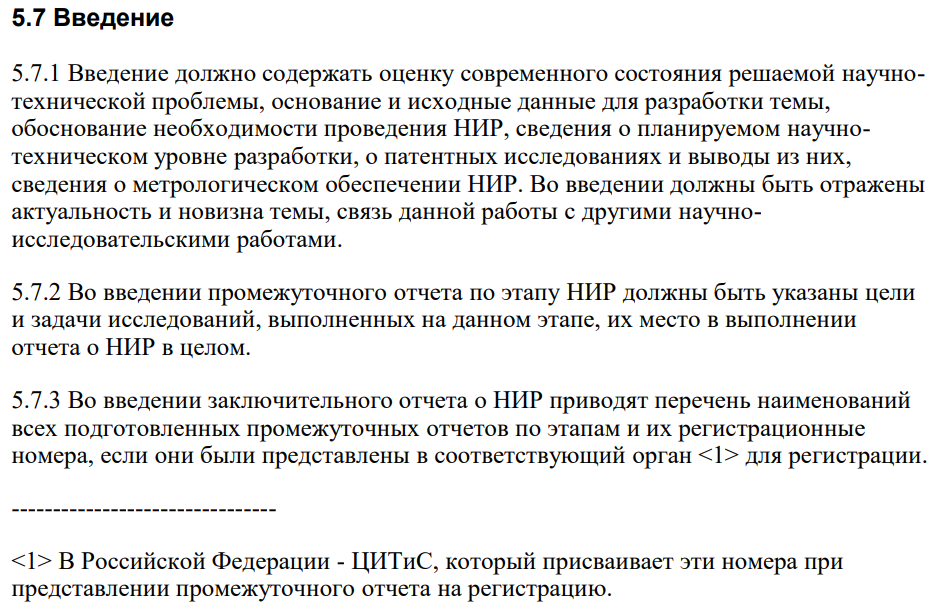
img/dev/GOST_intro.png
