buglalis/degree/img/dev/imax.png

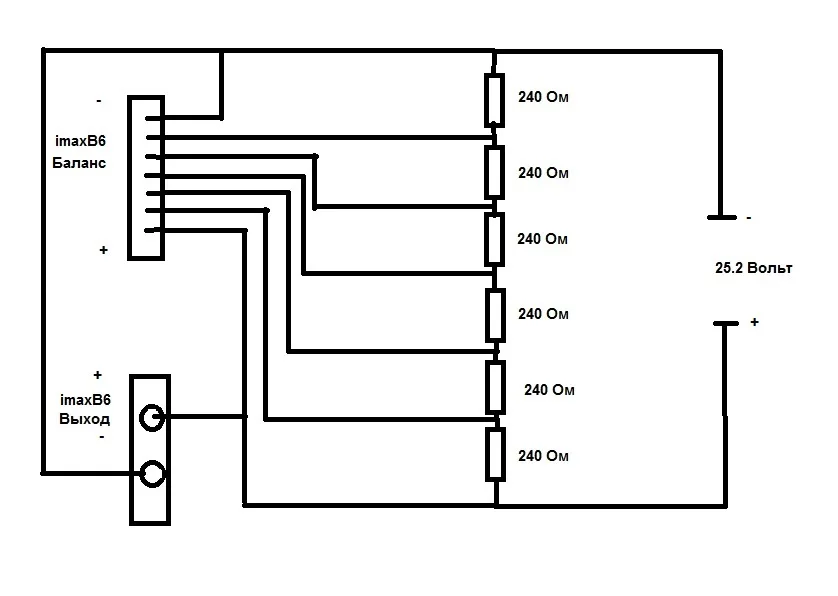
img/dev/imax.png
