buglalis/degree/img/diagrams/classification.png

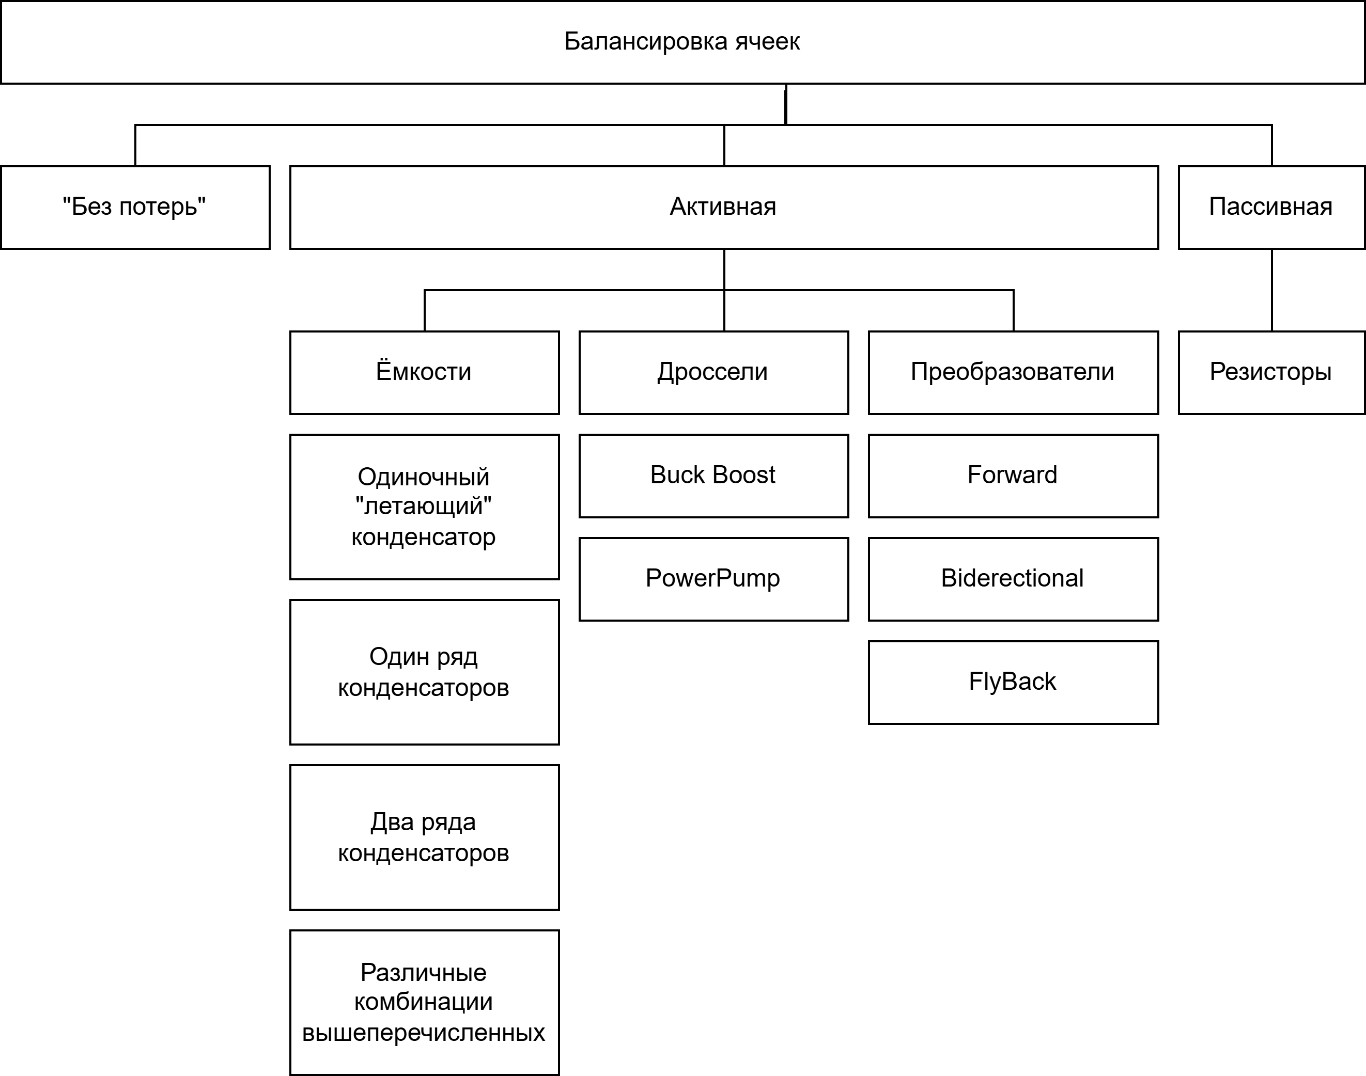
img/diagrams/classification.png
