buglalis/degree/img/fb_traccing.png

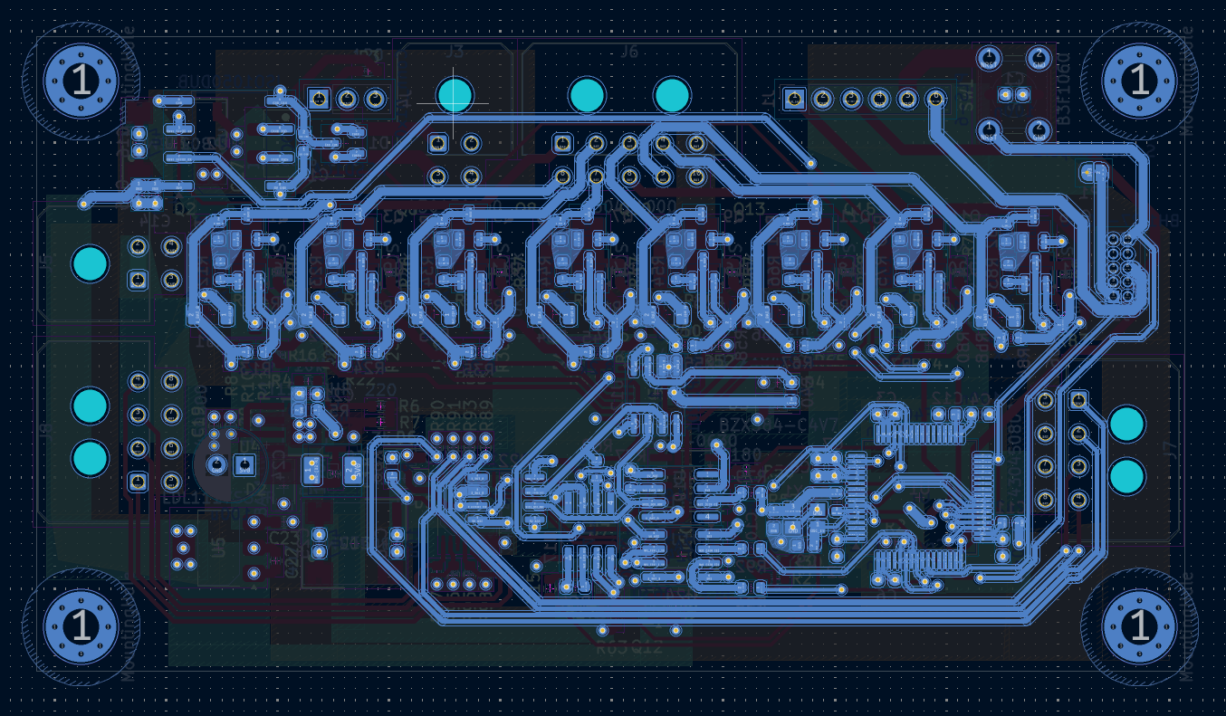
img/fb_traccing.png
