buglalis/degree/img/metods_img/md_capasitors_1.png

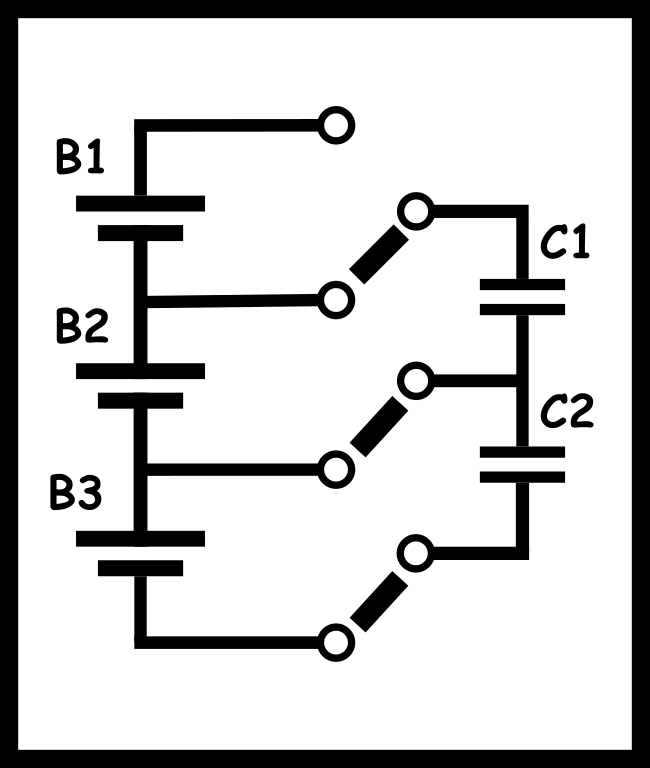
img/metods_img/md_capasitors_1.png
