buglalis/degree/img/metods_img/md_capasitors_2.png

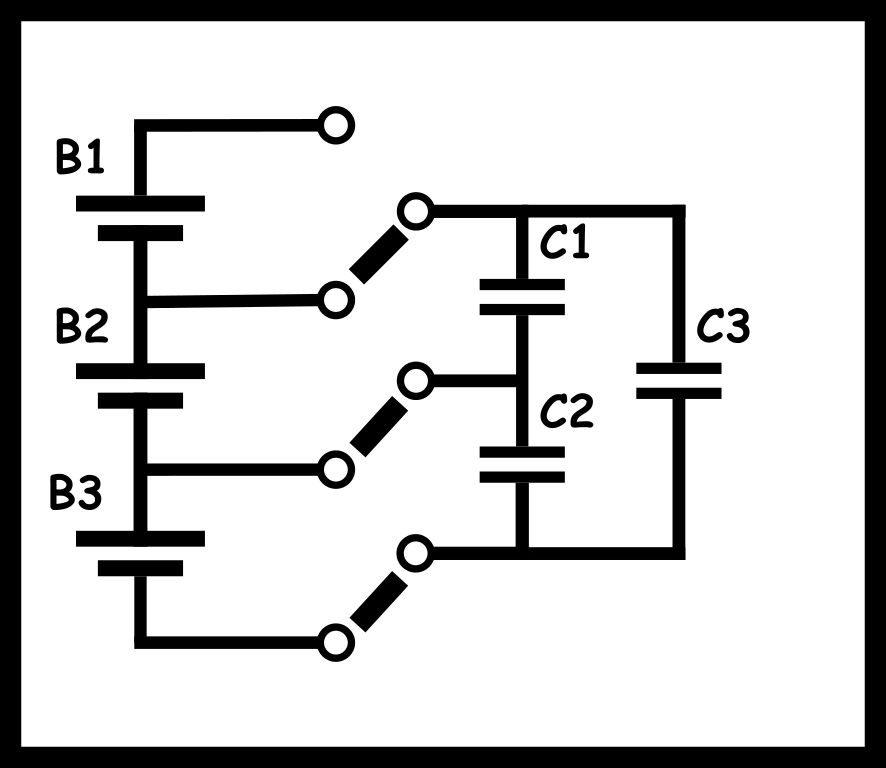
img/metods_img/md_capasitors_2.png
