buglalis/degree/img/metods_img/md_capasitors_3.png

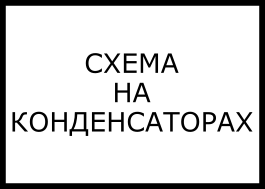
img/metods_img/md_capasitors_3.png
