buglalis/degree/img/no_loss_balancing.png

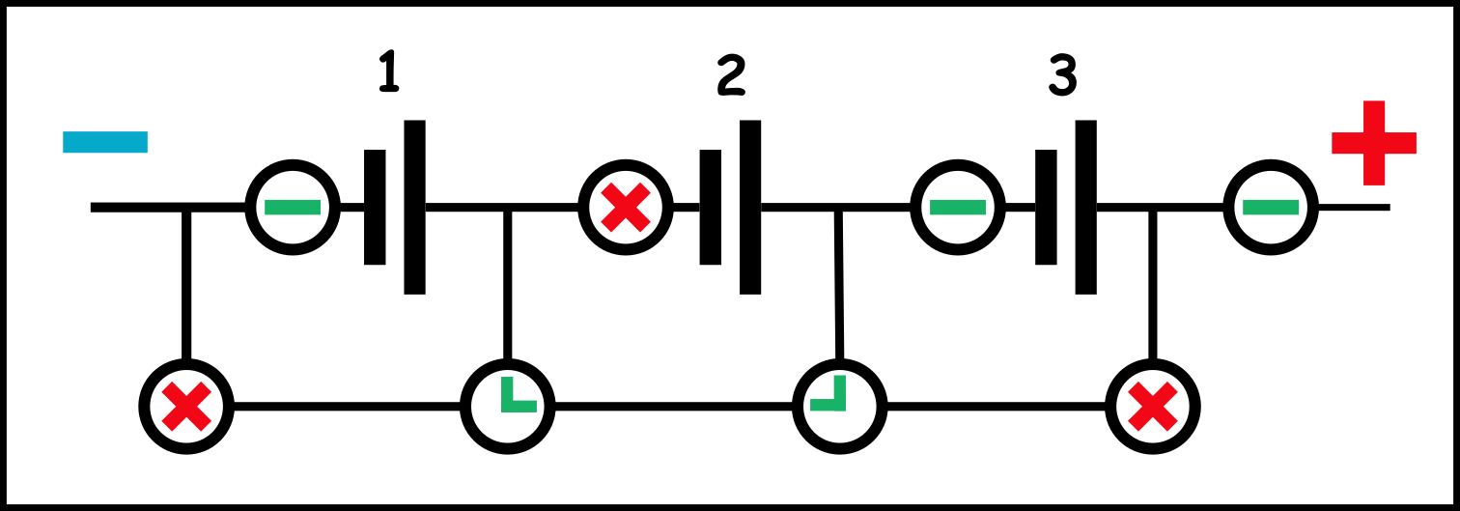
img/no_loss_balancing.png
