buglalis/degree/img/principial.jpg

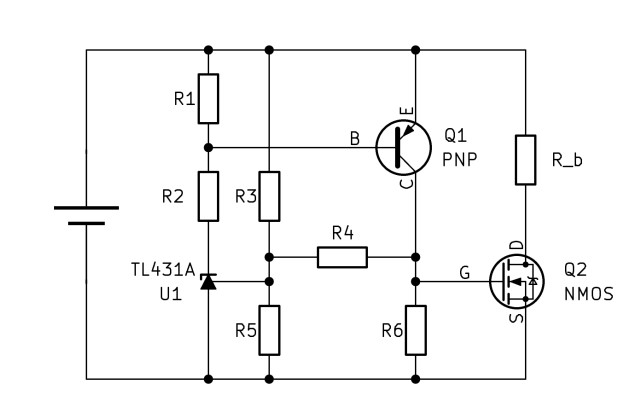
img/principial.jpg
