buglalis/degree/img/sheme/part_0.png

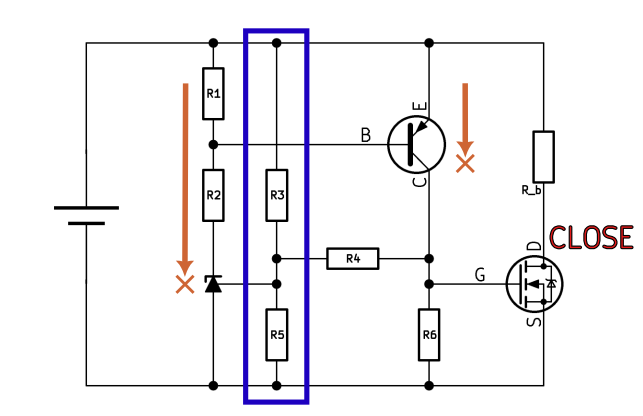
img/sheme/part_0.png
