buglalis/degree/img/sheme/part_1.png

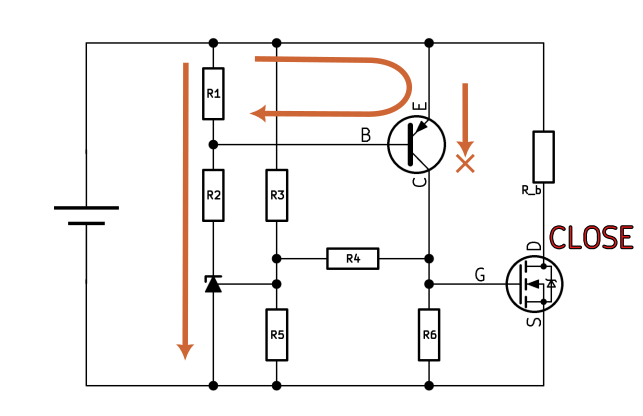
img/sheme/part_1.png
