buglalis/degree/img/sheme/part_2.png

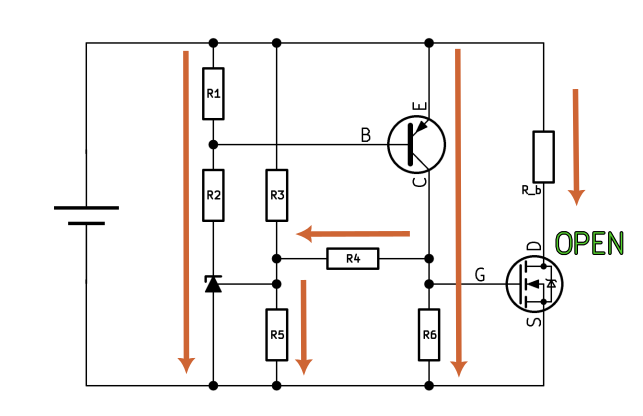
img/sheme/part_2.png
