buglalis/degree/img/sheme/part_3.png

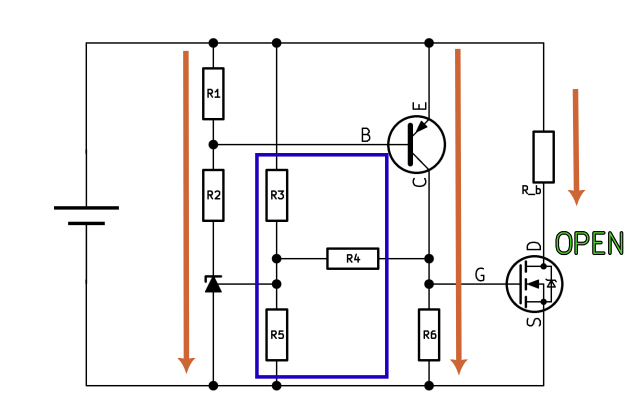
img/sheme/part_3.png
