buglalis/degree/img/smart_bms_cell_1.png

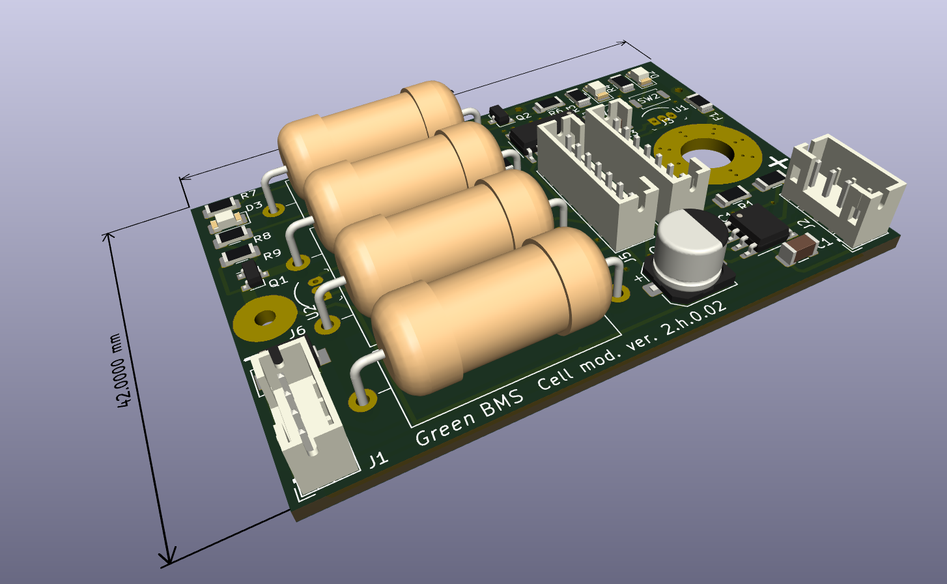
img/smart_bms_cell_1.png
