buglalis/degree/img/smart_bms_cell_2.png

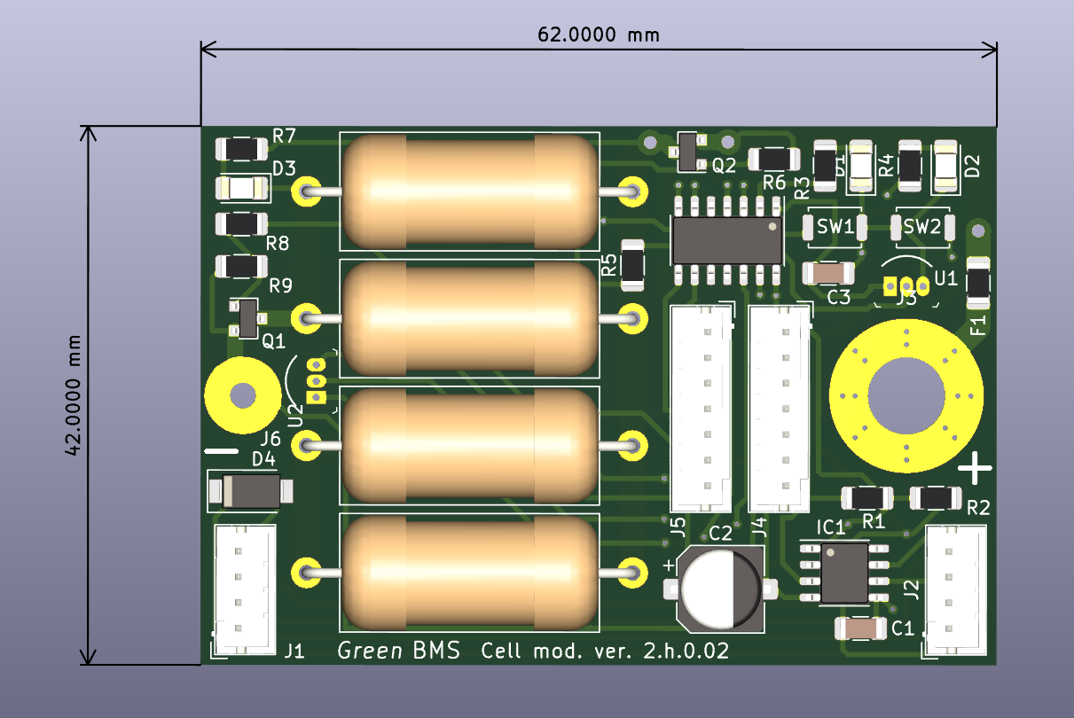
img/smart_bms_cell_2.png
