buglalis/degree/img/smart_bms_ctrl.png

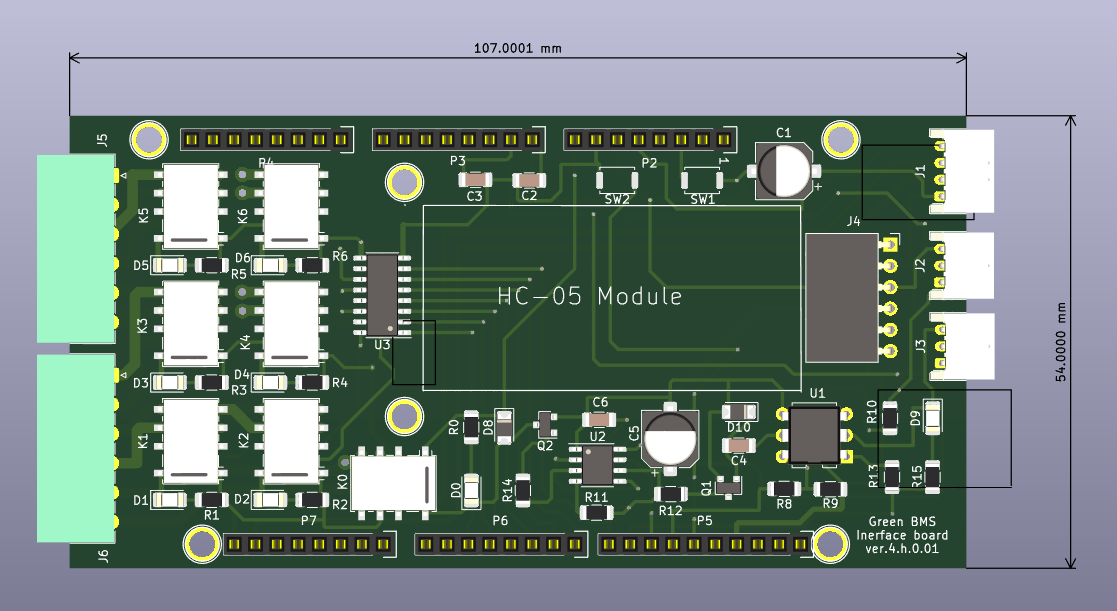
img/smart_bms_ctrl.png
