buglalis/degree/img/tesla_bms.jpg

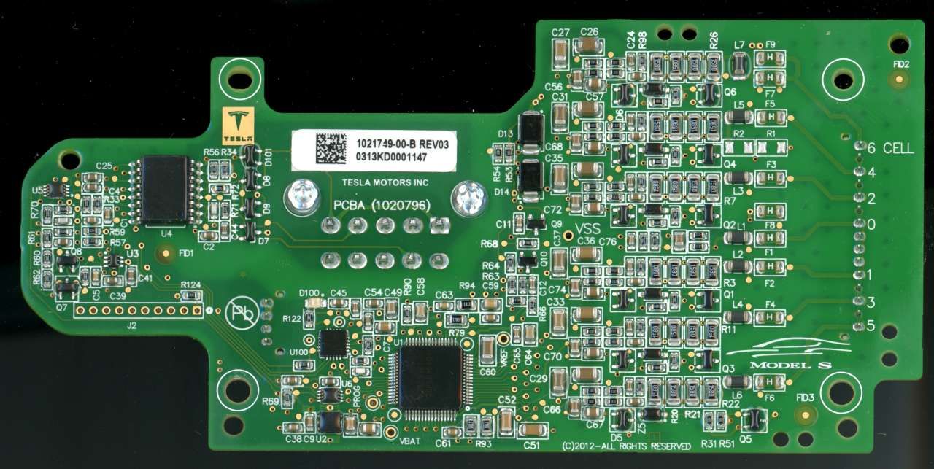
img/tesla_bms.jpg
