buglalis/degree/img/tl431_graph_cathod_v_i.png

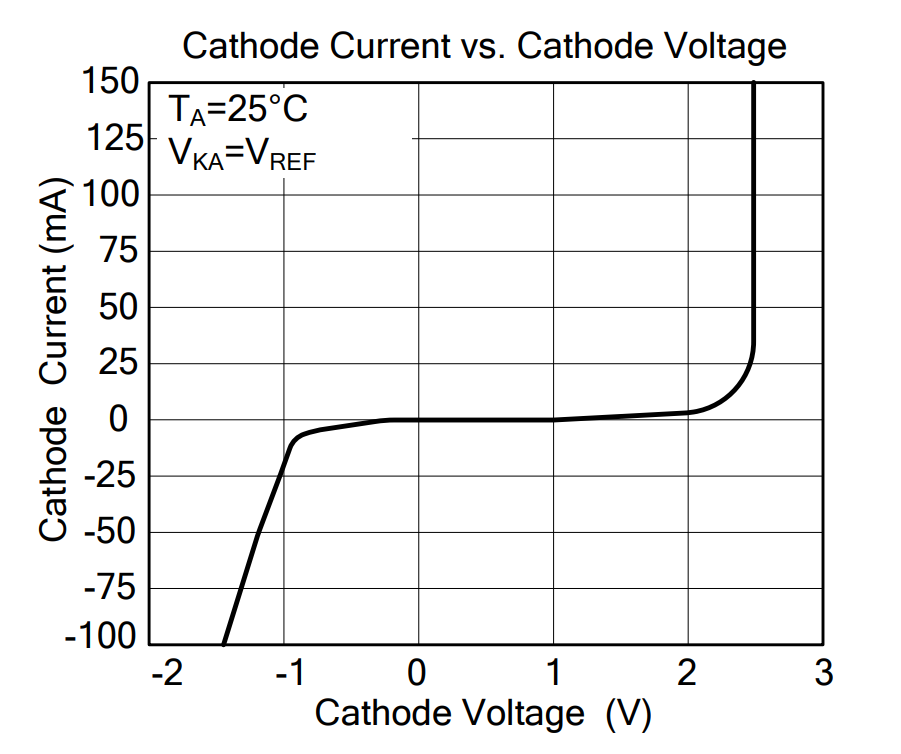
img/tl431_graph_cathod_v_i.png
