buglalis/degree/img/TL431_pinout.png

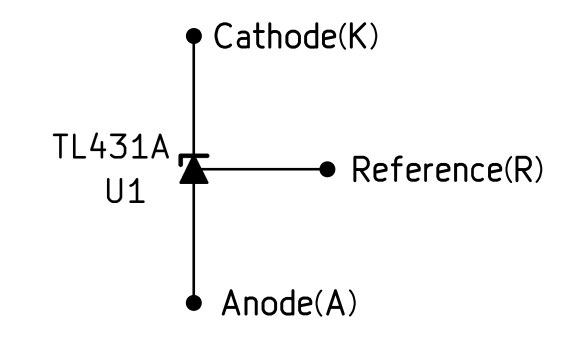
img/TL431_pinout.png
