buglalis/degree/KiCad/dev/STM/fone.jpg

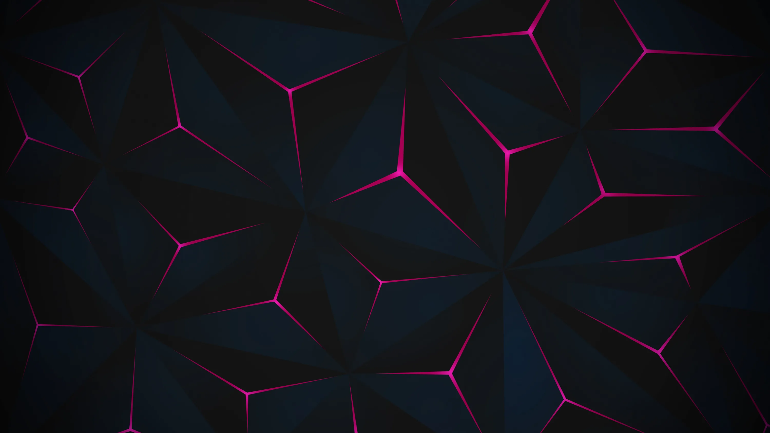
KiCad/dev/STM/fone.jpg
