buglalis/degree/KiCad/dev/STM/power supply scheme.png

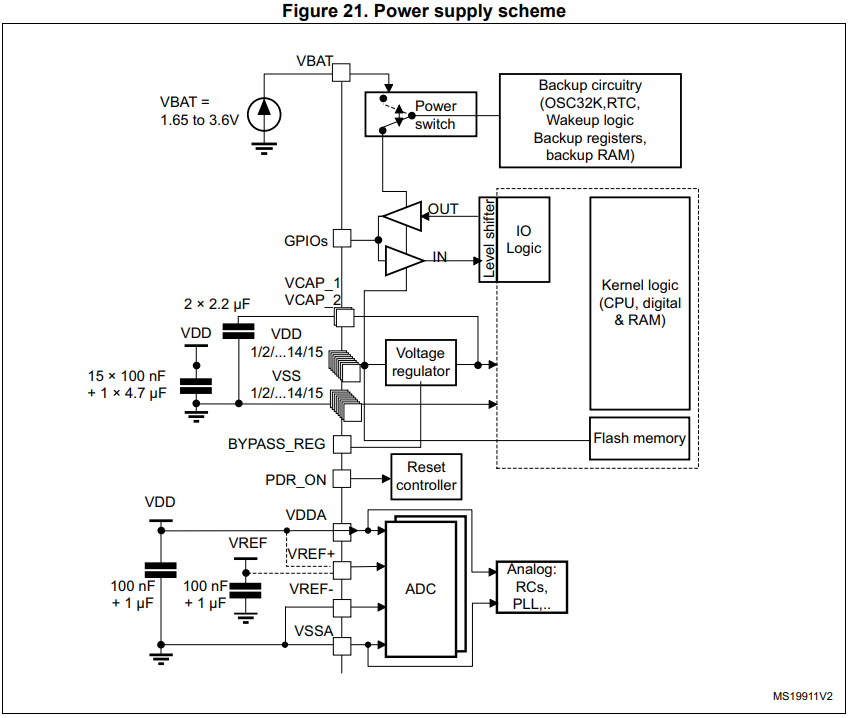
KiCad/dev/STM/power supply scheme.png
