buglalis/degree/KiCad/dev/балансировка/HCPL/Screenshot 2025-02-04 192348.png

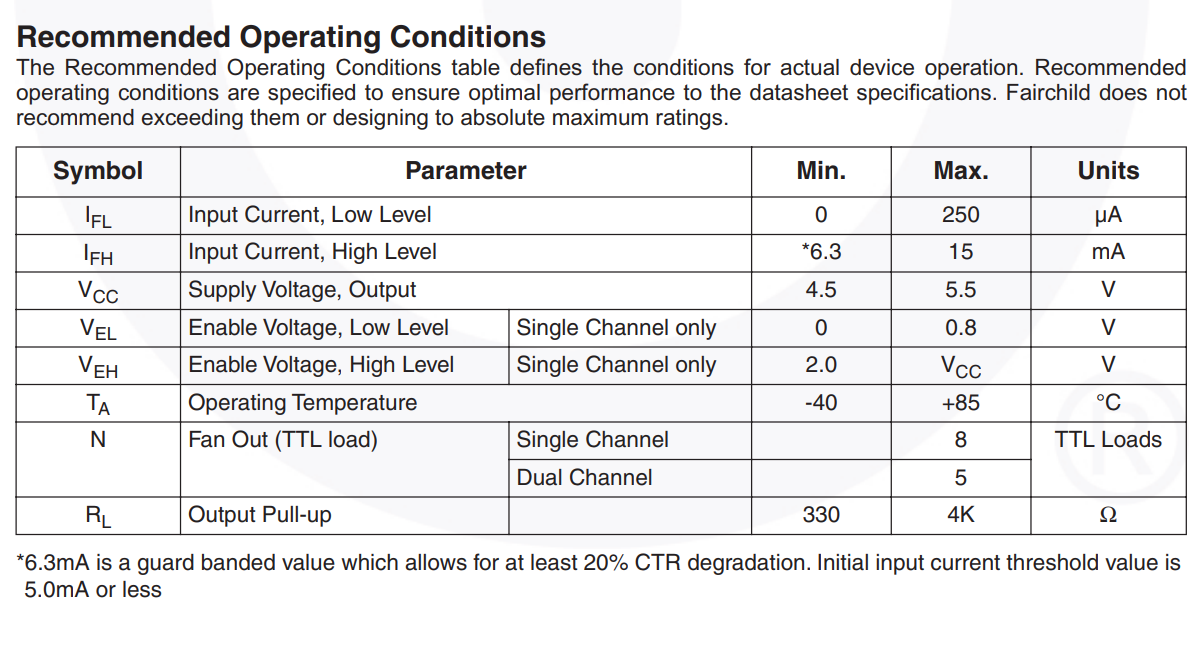
KiCad/dev/балансировка/HCPL/Screenshot 2025-02-04 192348.png
