buglalis/degree/KiCad/Examples/impeller18/BOM/BOM.xlsx

Sheet: Не плата
N | Название | Цена | Кол-во | Кол-во с запасом | Сумма | Ссылка | СУММА
1 | медный провод 20AWG 50м красный | 3350 |  | 5 | 16750 | https://www.li-force.ru/shop/view/20awg-50-05-100008-ul3135-lfw-20g-2 | 304086
2 | медный провод 20AWG 50м черный | 3350 |  | 5 | 16750 | https://www.li-force.ru/shop/view/20awg-50-05-100008-ul3135-lfw-20v
3 | Медный провод 20AWG 30м синий | 2010 |  | 4 | 8040 | https://www.li-force.ru/shop/view/20awg-30-05-100008-ul3135-lfw-20gr
4 | Медный провод 20AWG 30м серый | 2010 |  | 4 | 8040 | https://www.li-force.ru/shop/view/20awg-30-05-100008-ul3135-lfw-20o
5 | Медный провод 20AWG 50м зеленый | 3350 |  | 2 | 6700 | https://www.li-force.ru/shop/view/20awg-50-05-100008-ul3135-lfw-20y
6 | Разъем Micro-Fit 2x2 Ж | 11 | 5 | 20 | 220 | https://energoflot.ru/item/43025-0400
7 | Разъем Micro-Fit 2x3 Ж | 24 | 4 | 16 | 384 | https://energoflot.ru/item/43025-0600
8 | Разъем Micro-Fit 2x4 Ж | 26 | 1 | 4 | 104 | https://energoflot.ru/item/43025-0800
9 | Разъем Micro-Fit 2x5 Ж | 33 | 1 | 4 | 132 | https://energoflot.ru/item/43025-1000
10 | Разъем Micro-Fit 2x8 Ж | 56 | 2 | 8 | 448 | https://energoflot.ru/item/43025-1600
11 | Разъем Micro-Fit 2x9 Ж | 64 | 5 | 20 | 1280 | https://energoflot.ru/item/43025-1800
12 | Контакт-гнездо Micro-Fit | 4 |  | 1000 | 4000 | https://energoflot.ru/item/43030-0001
13 | LCD монитор | 103742 | 1 | 1 | 103742 | https://ipc2u.ru/catalog/idm-f21_pc/
14 | Кабель hdmi-micro hdmi | 930 | 1 | 3 | 2790 | https://www.chipdip.ru/product/pl1127
15 | Лампа AD-22DS сигнальная зеленая | 230 | 18 | 40 | 9200 | https://www.chipdip.ru/product0/8000945891
16 | Вентилятор Thermalright TL-C12015 | 800 |  | 3 | 2400 | https://www.onlinetrade.ru/catalogue/ventilyatory_dlya_korpusa-c1322/thermalright/ventilyator_dlya_korpusa_thermalright_tl_c12015-3436217.html
17 | Тумблер ON-OFF | 900 | 26 | 52 | 46800 | https://tek-el.ru/item/961613
18 | Клемма тип "О" 3.2мм | 9 |  | 250 | 2250 | https://www.chipdip.ru/product/1.25-3a
19 | Кнопка аварийной остановки | 1366 | 1 | 3 | 4098 | https://sklad-electrica.ru/boksy-schity-shkafy/aksessuary-dlja-sborki-schitov-i-boksov/knopki-apparatura/knopki-upravlenija/knopka-abb-ce4t-10r-11-avarijnogo-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
20 | Кнопка без фиксации зеленая OFF-(ON) | 680 | 1 | 2 | 1360 | https://www.chipdip.ru/product/mb100dy?from=visited_product
21 | Перем. резистор 10K | 355 | 2 | 6 | 2130 | https://www.promelec.ru/product/229257/
22 | Стойка для печатных плат, шестигр., латунь, М4, 22 мм | 24 | 4 | 16 | 384 | https://www.chipdip.ru/product/pchss4-20
23 | ЦИЛИНДРИЧЕСКИЙ ВИНТ М4 ИМБУС DIN 912 С ВНУТРЕННИМ ШЕСТИГРАННИКОМ | 9 | 4 | 16 | 144 | https://krep-shop.ru/katalog/bolty_i_vinty/din_912/?offer_id=284104
24 | ЦИЛИНДРИЧЕСКИЙ ВИНТ М4 ИМБУС DIN 912 С ВНУТРЕННИМ ШЕСТИГРАННИКОМ | 5 | 4 | 16 | 80 | https://krep-shop.ru/katalog/bolty_i_vinty/din_912/?offer_id=283433
25 | ЦИЛИНДРИЧЕСКИЙ ВИНТ М4 ИМБУС DIN 912 С ВНУТРЕННИМ ШЕСТИГРАННИКОМ | 5 | 4 | 16 | 80 | https://krep-shop.ru/katalog/bolty_i_vinty/din_912/4kh6_v_sh_nerzh_a2_din_912/
26 | Стойка для печатных плат латунная М2,5 высота 12 мм | 92 | 4 | 16 | 1472 | https://www.chipdip.ru/product0/8010398726
27 | ЦИЛИНДРИЧЕСКИЙ ВИНТ М2.5 ИМБУС DIN 912 С ВНУТРЕННИМ ШЕСТИГРАННИКОМ | 4 | 8 | 32 | 128 | https://krep-shop.ru/katalog/bolty_i_vinty/din_912/?offer_id=277533
28 | PETG пластик «Чёрный ворон» | 798 |  | 8 | 6384 | https://www.sopytka.ru/products/prutki-dlya-3d-printera/9056/7912/
29 | PETG пластик «Лёгкий бриз», полупрозрачный | 798 |  | 3 | 2394 | https://www.sopytka.ru/products/prutki-dlya-3d-printera/9061/7922/
30 | PETG пластик «Белая гвардия» | 798 |  | 4 | 3192 | https://www.sopytka.ru/products/prutki-dlya-3d-printera/9064/7928/
31 | PETG пластик «Мальдивы» | 798 |  | 1 | 798 | https://www.sopytka.ru/products/prutki-dlya-3d-printera/9073/8631/
32 | PETG пластик «Cпелый мандарин» | 798 |  | 1 | 798 | https://www.sopytka.ru/products/prutki-dlya-3d-printera/9060/7920/
33 | ПРИПОЙ ПОС63 ТР 2.0мм катушка 250г флюс 525-Т4 (CF10) | 1750 |  | 2 | 3500 | https://www.chipdip.ru/product0/8026295832
34 | Припой ASAHI 63/37 с флюсом CF-10 0.6 мм 250 г | 4410 |  | 2 | 8820 | https://www.chipdip.ru/product0/8006510826
35 | Термоусаживаемая трубка REXANT 5,0/2,5 мм красная | 114 |  |  | 0 | https://www.vseinstrumenti.ru/product/termousazhivaemaya-trubka-rexant-5-0-2-5-mm-krasnaya-rolik-2-44-m-29-0024-1683715/
36 | Термоусаживаемая трубка REXANT 8,0/4,0 мм красная | 121 |  |  | 0 | https://www.vseinstrumenti.ru/product/termousazhivaemaya-trubka-rexant-8-0-4-0-mm-krasnaya-rolik-2-44-m-29-0044-1683767/
37 | Многослойные печатные платы | 32000 |  | 1 | 32000 | https://www.rezonit.ru/pcb/mnogosloynye-platy-tipovye-sborki/
38 | Аккумуляторная батарейка 18350, 3,7 В, 1200 мАч | 1300 |  | 3 | 3900 | https://www.ozon.ru/product/keeppower-akkumulyatornaya-batareyka-18350-3-7-v-1200-mach-2-sht-1058570457/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
39 | Батарейки таблетки литиевые GP Lithium (CR2032) 3V | 630 |  | 1 | 630 | https://www.ozon.ru/product/batareyki-tabletki-litievye-gp-lithium-cr2032-3v-10-sht-258385389/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
40 | 32 Гб Карта памяти Micro SD | 441 |  | 4 | 1764 | https://www.ozon.ru/product/32-gb-karta-pamyati-kingston-canvas-select-plus-microsdhc-sd-adapter-sdcs2-32gb-uhs-i-u1-v10-a1-862377561/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
41 | Мышь |  |  |  | 0
42 | Клава |  |  |  | 0
43 | Картридж с желтой лентой (Пигин) |  |  |  | 0
44 |  |  |  |  | 0
45 |  |  |  |  | 0
46 |  |  |  |  | 0
47 |  |  |  |  | 0
48 |  |  |  |  | 0
49 |  |  |  |  | 0
50 |  |  |  |  | 0
51 |  |  |  |  | 0
52 |  |  |  |  | 0
53 |  |  |  |  | 0
54 |  |  |  |  | 0
55 |  |  |  |  | 0
56 |  |  |  |  | 0
57 |  |  |  |  | 0
58 |  |  |  |  | 0
59 |  |  |  |  | 0
60 |  |  |  |  | 0
61 |  |  |  |  | 0
62 |  |  |  |  | 0
63 |  |  |  |  | 0
64 |  |  |  |  | 0
65 |  |  |  |  | 0
66 |  |  |  |  | 0
67 |  |  |  |  | 0
68 |  |  |  |  | 0
69 |  |  |  |  | 0
70 |  |  |  |  | 0
71 |  |  |  |  | 0
72 |  |  |  |  | 0
73 |  |  |  |  | 0
74 |  |  |  |  | 0
75 |  |  |  |  | 0
76 |  |  |  |  | 0
77 |  |  |  |  | 0
78 |  |  |  |  | 0
79 |  |  |  |  | 0
80 |  |  |  |  | 0
81 |  |  |  |  | 0
82 |  |  |  |  | 0
83 |  |  |  |  | 0
84 |  |  |  |  | 0
85 |  |  |  |  | 0
86 |  |  |  |  | 0
87 |  |  |  |  | 0
88 |  |  |  |  | 0
89 |  |  |  |  | 0
90 |  |  |  |  | 0
91 |  |  |  |  | 0
92 |  |  |  |  | 0
93 |  |  |  |  | 0
94 |  |  |  |  | 0
95 |  |  |  |  | 0
96 |  |  |  |  | 0
97 |  |  |  |  | 0
98 |  |  |  |  | 0
99 |  |  |  |  | 0
100 |  |  |  |  | 0
101 |  |  |  |  | 0
102 |  |  |  |  | 0
103 |  |  |  |  | 0
104 |  |  |  |  | 0
105 |  |  |  |  | 0
106 |  |  |  |  | 0
107 |  |  |  |  | 0
108 |  |  |  |  | 0
109 |  |  |  |  | 0
110 |  |  |  |  | 0
111 |  |  |  |  | 0
112 |  |  |  |  | 0
113 |  |  |  |  | 0
114 |  |  |  |  | 0
115 |  |  |  |  | 0
116 |  |  |  |  | 0
117 |  |  |  |  | 0
118 |  |  |  |  | 0
119 |  |  |  |  | 0
120 |  |  |  |  | 0
121 |  |  |  |  | 0
122 |  |  |  |  | 0
123 |  |  |  |  | 0
124 |  |  |  |  | 0
125 |  |  |  |  | 0
126 |  |  |  |  | 0

Sheet: Плата
Reference | Value | Footprint | Qty | Человекопонятное название | Цена | Ссылка | Мин. кол-во | Кол-во | СУММА | СУММА
BT1 | DS1092-07-W6L | user_lib:DS1092-07-W6L | 1 | Держатель батареи CR2032 | 31 | https://www.promelec.ru/product/569951/ | 1 | 3 | 93 | 125393
BT2,BT3 | Battery_Cell | user_lib:bat_18350 | 2 |  |  |  |  | 6 | 0
C1,C2 | 2u2 | Capacitor_SMD:C_0603_1608Metric | 2 | Конденсатор керамический smd 2.2мкФ | 13 | https://www.chipdip.ru/product/grm188r61a225k | 10 | 10 | 130
C3,C29,C131 | 4u7 | Capacitor_SMD:C_0603_1608Metric | 3 | Керамический ЧИП-конденсатор 0603 X5R 4.7мкФ | 4 | https://www.promelec.ru/product/315964/ | 200 | 200 | 800
C4,C5,C6,C7,C8,C9,C10,C11,C12,C13,C14,C15,C16,C18,C20,C23,C28,C30,C52,C53,C54,C55,C61,C63,C66,C67,C70,C73,C76,C79,C80,C83,C86,C89,C92,C93,C96,C97,C100,C101,C104,C108,C111,C112,C113,C114,C117,C119,C121,C122,C123,C124,C126,C127,C130,C132 | 100n | Capacitor_SMD:C_0603_1608Metric | 56 | Керамический ЧИП-конденсатор 0603 X7R 0.1мкФ | 2 | https://www.promelec.ru/product/323633/ | 300 | 300 | 600
C17,C19,C27,C62,C64,C65,C68,C69,C77,C78,C81,C82,C91,C120,C129 | 1u | Capacitor_SMD:C_0603_1608Metric | 15 | Керамический ЧИП-конденсатор 0603 X7R 1мкФ | 1 | https://www.promelec.ru/product/334556/ | 200 | 200 | 200
C21,C25 | 8p | Capacitor_SMD:C_0603_1608Metric | 2 | Керамический ЧИП-конденсатор 0603 NP0 8пФ | 1 | https://www.promelec.ru/product/428876/ | 500 | 500 | 500
C22,C24 | 15p | Capacitor_SMD:C_0603_1608Metric | 2 | Конденсатор керамический smd 15пФ | 7 | https://www.chipdip.ru/product/grm1885c1h150j | 10 | 10 | 70
C26,C40,C41,C51 | 4700p | Capacitor_SMD:C_1206_3216Metric | 4 | Керамический ЧИП-конденсатор 1206 X7R 4700пФ | 3 | https://www.promelec.ru/product/127179/ | 200 | 200 | 600
C31,C32,C33,C34,C35,C37 | 10u | Capacitor_SMD:C_1210_3225Metric | 6 | Керамический ЧИП-конденсатор 1210 X7S 10мкФ | 27 | https://www.promelec.ru/product/343475/ | 19 | 19 | 513
C36,C47,C49,C105,C106 | 47u | Capacitor_THT:CP_Radial_D10.0mm_P5.00mm | 5 | конденсатор алюминиевый электролитический 47мкф 100в | 52 | https://www.promelec.ru/product/601218/ | 10 | 15 | 780
C38 | 68u | Capacitor_THT:CP_Radial_D10.0mm_P5.00mm | 1 | Конденсатор алюминиевый электролитический 68мкФ 63В | 5 | https://www.promelec.ru/product/125292/ | 2 | 3 | 15
C39,C50 | 10u | Capacitor_THT:CP_Radial_D10.0mm_P5.00mm | 2 | Конденсатор алюминиевый электролитический 10мкФ 250В | 51 | https://www.promelec.ru/product/381510/ | 10 | 10 | 510
C42,C43,C44,C45,C46,C48,C56,C59,C125,C128 | 4u7 | Capacitor_SMD:C_1210_3225Metric | 10 | Керамический ЧИП-конденсатор 1210 X7S 4.7мкФ | 29 | https://www.promelec.ru/product/384583/ | 17 | 30 | 870
C57,C58,C60,C74,C75,C87,C88,C90,C94,C95,C98,C99,C102,C103,C109,C110,C115,C116 | 10u | Capacitor_SMD:C_0603_1608Metric | 18 | Керамический ЧИП-конденсатор 0603 X5R 10мкФ | 4 | https://www.promelec.ru/product/430347/ | 200 | 200 | 800
C71,C72,C84,C85 | 22p | Capacitor_SMD:C_0603_1608Metric | 4 | Керамический ЧИП-конденсатор 0603 NP0 22пФ ±5% | 2 | https://www.promelec.ru/product/199351/ | 300 | 300 | 600
C107 | 100u | Capacitor_THT:CP_Radial_D8.0mm_P3.50mm | 1 | Конденсатор алюминиевый электролитический 100мкФ 50В | 33 | https://www.promelec.ru/product/367658/ | 16 | 16 | 528
C118 | 10n | Capacitor_SMD:C_0603_1608Metric | 1 | Керамический ЧИП-конденсатор 0603 | 2 | https://www.promelec.ru/product/327806/ | 500 | 500 | 1000
D1,D2,D3,D5,D6,D9,D11,D14,D15,D16,D17,D18,D19,D24,D25 | FYLS-0603BUGC | LED_SMD:LED_0603_1608Metric | 15 | Светодиод smd 1,6х0,8мм/зеленый/568нм/65мкд/прозрачный/130° | 5 | https://www.promelec.ru/product/324327/ | 3 | 45 | 225
D8,D10 | PESD1CAN | Package_TO_SOT_SMD:SOT-23 | 2 | Защитный диод от ESD для CAN шины | 87 | https://www.chipdip.ru/product/pesd1can.215 | 1 | 6 | 522
D12,D13,D20,D21,D22,D23 | FYLS-3528RGBC | user_lib:LED_RGB_promelec | 6 | Светодиод smd 3,5х2,8мм/красный/625нм/200мкд - зеленый/520нм/800мкд - синий/470нм/250мкд/прозрачный/120° | 8 | https://www.promelec.ru/product/337147/ | 2 | 18 | 144
F1,F2 | MF-LSMF300/24X-2 | user_lib:Fuse_2920_7451Metric | 2 | Самовосстанавливающийся предохранитель | 28 | https://www.promelec.ru/product/465739/ | 1 | 6 | 168
J1,J13 | PLS-6 | Connector_PinHeader_2.54mm:PinHeader_1x06_P2.54mm_Vertical | 2 |  |  |  |  | 6 | 0
J2 | BH1,27-10-G | user_lib:PinHeader_2x05_P1.27mm_Vertical_mod | 1 | Разъем штыревой 1x05 1.27x1.27 | 97 | https://energoflot.ru/item/C3503-10SGB000R+BH1%2C27-10-G | 1 | 3 | 291
J3,J5 | PLS-3 | Connector_PinHeader_2.54mm:PinHeader_1x03_P2.54mm_Vertical | 2 |  |  |  |  | 6 | 0
J4 | PLS-8 | Connector_PinHeader_2.54mm:PinHeader_1x08_P2.54mm_Vertical | 1 |  |  |  |  | 3 | 0
J6,J9,J11,J21 | 430450400 | user_lib:430454000 | 4 | Разъем типа провод-плата, 3 мм, 4 контакт(-ов) | 64 | https://www.promelec.ru/product/347522/ | 8 | 12 | 768
J7,J8 | PLS-2 | Connector_PinHeader_2.54mm:PinHeader_1x02_P2.54mm_Vertical | 2 |  |  |  |  | 6 | 0
J10,J12 | PLS-5 | Connector_PinHeader_2.54mm:PinHeader_1x05_P2.54mm_Vertical | 2 |  |  |  |  | 6 | 0
J14 | Raspberry Pi 4 | user_lib:RPi | 1 | Одноплатный компьютер | 12500 | https://sinardcom.ru/product/raspberry-pi4b-8gb-rpi | 1 | 3 | 37500
J15,J16,J17,J24,J25 | 430451800 | user_lib:430451800 | 5 | Соединитель провод-плата HDR 18 контакт(ов) 3мм угловой серия Micro-Fit | 175 | https://www.promelec.ru/product/474708/ | 3 | 15 | 2625
J18 | 430451000 | user_lib:430451000 | 1 | Прямоугольный разъем, Серия Micro-Fit 3.0 43045, 10 контакт(-ов) | 82 | https://www.promelec.ru/product/360135/ | 7 | 7 | 574
J19 | 430450800 | user_lib:430450800 | 1 | Разъем типа провод-плата, 3 мм, 8 контакт(-ов) | 74 | https://www.promelec.ru/product/362578/ | 7 | 7 | 518
J20,J22,J23,J27 | 430450600 | user_lib:430450600 | 4 | Разъем типа провод-плата, 3 мм, 6 контакт(-ов) | 68 | https://www.promelec.ru/product/355066/ | 8 | 12 | 816
J26,J28 | 430451600 | user_lib:430451600 | 2 | Прямоугольный разъем, Серия Micro-Fit 3.0 43045, 16 контакт(-ов) | 197 | https://www.promelec.ru/product/362588/ | 3 | 6 | 1182
J29 | TF-01 | sd:TF01A-NEW | 1 |  |  |  |  | 3 | 0
J30 | USB_B_Micro | user_lib:U-F-M5DD-W-2-SUS | 1 |  |  |  |  | 3 | 0
J31 | 430450415 | user_lib:430450415 | 1 | Разъем типа провод-плата, 3 мм, 4 контакт(-ов) | 87 | https://www.promelec.ru/product/474679/ | 6 | 6 | 522
K1,K2,K3 | 1393219-3 | user_lib:1393219-3 | 3 | Силовое реле | 280 | https://www.promelec.ru/product/320571/ | 2 | 9 | 2520
L1,L2 | B82721-K2222-U30 | user_lib:B82721-K2222-U30 | 2 | Дроссель подавления ЭМП | 380 | https://www.chipdip.ru/product/b82721-k2222-u30-2x1000 | 1 | 6 | 2280
L3,L4 | B82790C0513N201 | user_lib:B82790C0513N201 | 2 | Дроссель для подавления асимметричной интерференции | 86 | https://www.promelec.ru/product/73838/ | 6 | 6 | 516
L5 | 27n | Capacitor_SMD:C_0603_1608Metric | 1 | Индуктивность SMD | 20 | https://www.chipdip.ru/product/lqw18an27ng | 5 | 5 | 100
Q1,Q2,Q4,Q5,Q6,Q7,Q8,Q9,Q10,Q11,Q12,Q13,Q14,Q15,Q16,Q17,Q18,Q19,Q20,Q21,Q22,Q23,Q24,Q25,Q26,Q27,Q28,Q29,Q30,Q31,Q32,Q33,Q34,Q35,Q36,Q37,Q38,Q39,Q40,Q41,Q42,Q43,Q44,Q45,Q46,Q47,Q48,Q49,Q50,Q51,Q52,Q53,Q54,Q55,Q56,Q57,Q58,Q59,Q60 | BSS138 | Package_TO_SOT_SMD:SOT-23 | 59 | Транзистор полевой N-канальный | 14 | https://www.promelec.ru/product/303635/ | 38 | 177 | 2478
Q3 | AO3401A | Package_TO_SOT_SMD:SOT-23 | 1 | Транзистор полевой P-канальный | 5 | https://www.promelec.ru/product/517727/ | 2 | 3 | 15
R1,R2,R3,R4,R5,R12,R13,R15,R16,R22,R24,R37,R41,R53,R54,R60,R62,R63,R64,R70,R72,R73,R74,R80,R82,R83,R84,R90,R92,R93,R94,R100,R102,R103,R104,R110,R112,R113,R114,R120,R122,R123,R124,R130,R132,R133,R134,R137,R138,R143,R147,R148,R152,R153,R157,R158,R162,R163,R168,R169,R173,R174,R178,R179,R181,R184,R188,R189,R191,R194,R198,R199,R203,R204,R206,R207,R209,R211,R213,R215,R217,R219,R221,R223,R225,R227,R229,R231,R233,R235,R237,R239,R241,R243,R245,R247,R254,R256,R258,R262,R263,R265,R268,R272,R273,R274,R282,R283,R285,R287,R288,R289,R291,R292,R293,R295,R296,R299,R301,R303,R305,R307,R309,R311,R313,R316,R317,R318,R319,R320,R321,R332,R333,R334,R335 | 10k | Resistor_SMD:R_0603_1608Metric | 135 | Толстопленочный ЧИП-резистор 0603 10кОм | 1 | https://www.promelec.ru/product/344748/ | 1000 | 1000 | 1000
R6,R7,R11,R14 | PWR_REG | Resistor_SMD:R_0603_1608Metric | 4 |  |  |  |  | 12 | 0
R8,R38,R42,R55,R56,R65,R66,R75,R76,R85,R86,R95,R96,R105,R106,R115,R116,R125,R126,R135,R136,R139,R140,R144,R149,R154,R159,R164,R165,R170,R175,R180,R185,R190,R195,R200,R205,R250,R281,R294,R297,R338 | 360 | Resistor_SMD:R_0603_1608Metric | 42 | Толстопленочный ЧИП-резистор 0603 360Ом | 1 | https://www.promelec.ru/product/46471/ | 100 | 126 | 126
R9,R43,R44,R45,R46,R47,R48,R208,R210,R212,R214,R216,R218,R220,R222,R224,R226,R228,R230,R232,R234,R236,R238,R240,R242,R244,R246,R248,R314,R315,R322,R323,R324,R325,R326,R327,R328,R329,R330,R331,R336 | 220 | Resistor_SMD:R_0603_1608Metric | 41 | Толстопленочный ЧИП-резистор 0603 220Ом | 1 | https://www.promelec.ru/product/46446/ | 100 | 123 | 123
R10,R27,R28,R249,R276,R337 | 470 | Resistor_SMD:R_0603_1608Metric | 6 | Толстопленочный ЧИП-резистор 0603 470Ом | 1 | https://www.promelec.ru/product/109567/ | 100 | 100 | 100
R17,R23 | 100 | Resistor_SMD:R_0603_1608Metric | 2 | Толстопленочный ЧИП-резистор 0603 100Ом | 1 | https://www.promelec.ru/product/57782/ | 100 | 100 | 100
R18,R19,R25,R26 | 130 | Resistor_SMD:R_2512_6332Metric | 4 | Толстопленочный ЧИП-резистор 2512 130Ом | 4 | https://www.promelec.ru/product/57521/ | 200 | 200 | 800
R20 | 0m62 | Resistor_SMD:R_2512_6332Metric | 1 | Толстопленочный ЧИП-резистор 2512 0.62Ом | 1 | https://www.promelec.ru/product/23443/ | 100 | 100 | 100
R21 | 1k | Resistor_SMD:R_0603_1608Metric | 1 | Толстопленочный ЧИП-резистор 0603 1кОм | 1 | https://www.promelec.ru/product/22771/ | 100 | 100 | 100
R29,R35,R39 | 120 | Resistor_SMD:R_0603_1608Metric | 3 | Толстопленочный ЧИП-резистор 0603 120Ом | 1 | https://www.promelec.ru/product/23378/ | 100 | 100 | 100
R30,R298,R300,R302,R304,R306,R308,R310,R312 | 390 | Resistor_SMD:R_0603_1608Metric | 9 | Толстопленочный ЧИП-резистор 0603 390Ом | 1 | https://www.promelec.ru/product/15311/ | 100 | 100 | 100
R31,R32,R33,R34,R49,R50,R57,R58,R67,R68,R77,R78,R87,R88,R97,R98,R107,R108,R117,R118,R127,R128,R141,R145,R150,R155,R160,R166,R171,R176,R182,R186,R192,R196,R201,R251,R253,R259,R264,R269,R271,R277,R279 | 1M | Resistor_SMD:R_0603_1608Metric | 43 | Толстопленочный ЧИП-резистор 0603 1МОм | 1 | https://www.promelec.ru/product/22010/ | 100 | 129 | 129
R36,R40 | 0 | Resistor_SMD:R_0603_1608Metric | 2 | Толстопленочный ЧИП-резистор 0603 0Ом | 1 | https://www.promelec.ru/product/22798/ | 100 | 100 | 100
R51,R52,R59,R61,R69,R71,R79,R81,R89,R91,R99,R101,R109,R111,R119,R121,R129,R131,R142,R146,R151,R156,R161,R167,R172,R177,R183,R187,R193,R197,R202 | 360k | Resistor_SMD:R_0603_1608Metric | 31 | Толстопленочный ЧИП-резистор 0603 360кОм | 1 | https://www.promelec.ru/product/23650/ | 100 | 100 | 100
R252,R255,R260,R266,R270,R275,R278,R280 | 200k | Resistor_SMD:R_0603_1608Metric | 8 | Толстопленочный ЧИП-резистор 0603 200кОм | 1 | https://www.promelec.ru/product/57740/ | 100 | 100 | 100
R257,R261,R267,R284,R286,R290 | 180 | Resistor_SMD:R_0603_1608Metric | 6 | Толстопленочный ЧИП-резистор 0603 180Ом | 1 | https://www.promelec.ru/product/108141/ | 100 | 100 | 100
SW1,SW4,SW5,SW6,SW7 | B3F1060 | Button_Switch_THT:SW_PUSH_6mm_H5mm | 5 | Кнопка тактильная 6х6 h=7мм | 15 | https://www.promelec.ru/product/430220/ | 1 | 15 | 225
SW2,SW3,SW8,SW9 | MSS-12D16 | user_lib:MSS-12D16 | 4 |  |  |  |  | 12 | 0
TP1,TP2,TP3,TP4,TP5,TP6,TP7,TP8,TP9,TP10,TP11,TP12,TP13,TP14,TP15,TP16,TP17,TP18,TP19,TP20,TP21,TP22,TP23,TP24,TP25,TP26,TP27,TP28,TP29,TP30,TP31,TP32,TP33,TP34,TP35,TP36,TP37,TP38,TP39,TP40,TP41,TP42,TP43,TP44,TP45 | TestPoint | TestPoint:TestPoint_THTPad_D1.5mm_Drill0.7mm | 45 |  |  |  |  | 135 | 0
U1 | STM32F427ZGTx | Package_QFP:LQFP-144_20x20mm_P0.5mm | 1 | Микроконтроллер STM 32 | 726 | https://www.promelec.ru/product/241424/ | 1 | 3 | 2178
U2 | LDL1117S33R | Package_TO_SOT_SMD:SOT-223-3_TabPin2 | 1 | Линейный стабилизатор с низким падением напряжения положительной полярности | 21 | https://www.promelec.ru/product/429209/ | 24 | 24 | 504
U3 | VDRI25W05 | user_lib:VDRI25 | 1 | DC-DC преобразователи напряжения мощностью 25 Вт | 3947 | https://voltbricks.nt-rt.ru/price/product/1132916 | 1 | 3 | 11841
U4 | VDRI15W12 | user_lib:VDRI25 | 1 | DC-DC преобразователи напряжения мощностью 15 Вт | 3045 | https://voltbricks.nt-rt.ru/price/product/1132885 | 1 | 3 | 9135
U5,U7 | HY2213-BB3A | Package_TO_SOT_SMD:SOT-23-6 | 2 | Контроллер-балансировщик Литий-ионной/Литий-полимерной батареи | 15 | https://www.promelec.ru/product/567920/ | 34 | 34 | 510
U6 | bq2057WSN | Package_SO:SOIC-8_3.9x4.9mm_P1.27mm | 1 | Драйвер батарейного питания | 1230 | https://www.chipdip.ru/product0/8002949902 | 1 | 3 | 3690
U8 | LD1084V | user_lib:TO-220-3_Vertical_radiator | 1 | Регулятор с низким падением напряжения, с регулировкой выхода, 5А | 330 | https://www.chipdip.ru/product/ld1084v | 1 | 3 | 990
U9 | MCP3001-I/SN | Package_SO:SOIC-8_3.9x4.9mm_P1.27mm | 1 | 10-ти разрядный АЦП | 285 | https://www.energoflot.ru/item/MCP3001-ISN | 1 | 3 | 855
U10,U11,U14,U15 | ISO1050DUB | user_lib:ISO1050DUB | 4 | CAN приемопередатчиком с гальванической развязкой | 148 | https://energoflot.ru/item/ISO1050DUBR | 1 | 12 | 1776
U12,U16 | MCP2515-I/SO | Package_SO:SOIC-18W_7.5x11.6mm_P1.27mm | 2 | CAN контроллер с SPI интерфейсом | 293 | https://www.mircomponents.ru/search?s=MCP2515-I%2FSO | 1 | 6 | 1758
U13,U17,U24,U25,U28,U56,U63 | B0505MT-1WR4 | user_lib:B0505MT-1WR4 | 7 | DC/DC преобразователь, 1Вт, вход 4.5-5.5В, выход 5В/200мА | 230 | https://www.chipdip.ru/product/b0505mt-1wr4 | 1 | 21 | 4830
U18,U19,U20,U21,U26,U27,U69,U70 | TLP291-4 | Package_SO:SOIC-16_4.55x10.3mm_P1.27mm | 8 | Оптопара с транзисторным выходом 4-х канальная | 76 | https://www.promelec.ru/product/247137/ | 7 | 24 | 1824
U22,U23,U29,U30,U31,U32,U33 | TLP291 | user_lib:TLP291 | 7 | Оптопара с транзисторным выходом | 17 | https://www.promelec.ru/product/247129/ | 31 | 31 | 527
U34,U35,U36,U37,U38,U39,U40,U41,U42,U43,U44,U45,U46,U47,U48,U49,U50,U51,U52,U53,U54 | G3VM61VY2 | user_lib:G3VM-61VY2TR | 21 | Реле твердотельное | 112 | https://www.promelec.ru/product/423382/ | 5 | 63 | 7056
U55 | SCWN06A-12 | user_lib:SCWN06A-12 | 1 | DC/DC преобразователь, 6Вт, вход 9-18В, выход 12В/500мА | 1020 | https://www.chipdip.ru/product/scwn06a-12 | 1 | 3 | 3060
U57,U61,U64,U73 | HCPL-0600 | Package_SO:SO-8_3.9x4.9mm_P1.27mm | 4 | Быстродействующая оптопара | 133 | https://energoflot.ru/item/HCPL-0600-500E | 1 | 12 | 1596
U58 | MCP3008 | Package_SO:SOIC-16_3.9x9.9mm_P1.27mm | 1 | Аналого-цифровые преобразователи (АЦП) 10-bit | 318 | https://energoflot.ru/item/MCP3008T-ISL | 1 | 3 | 954
U59,U65,U68 | HCPL-0630 | Package_SO:SOIC-8_3.9x4.9mm_P1.27mm | 3 | Быстродействующая оптопара | 229 | https://energoflot.ru/item/HCPL-0630-500E | 1 | 9 | 2061
U60,U62,U66 | IP4220 | Package_TO_SOT_SMD:SOT-23-6 | 3 | Защитная ИС | 11 | https://www.chipdip.ru/product/ip4220cz6 | 1 | 9 | 99
U67 | ADS1120-PW | Package_SO:TSSOP-16_4.4x5mm_P0.65mm | 1 | АЦП конвертер 16-ти разрядный маломощный малошумящий | 624 | https://energoflot.ru/item/ADS1120IPWR | 1 | 3 | 1872
U71 | W25Q128FVSIG | user_lib:SOIC-8_5.23x5.23mm_P1.27mm | 1 | Флэш-память | 127 | https://www.promelec.ru/product/342088/ | 2 | 3 | 381
U72 | USBLC6-2SC6 | Package_TO_SOT_SMD:SOT-23-6 | 1 | Защита интерфейса USB от электростатических разрядов | 13 | https://www.promelec.ru/product/128262/ | 1 | 3 | 39
U74 | LDL1117S50R | Package_TO_SOT_SMD:SOT-223-3_TabPin2 | 1 | Линейный стабилизатор с низким падением напряжения положительной полярности | 37 | https://www.promelec.ru/product/429208/ | 14 | 14 | 518
U75 | SMU02M-12 | user_lib:SMU02M-12 | 1 | Преобразователь DC/DC, на печатную плату, 2 Вт | 458 | https://www.promelec.ru/product/371234/ | 2 | 3 | 1374
Y1,Y3,Y4 | X322516MLB4SI | Crystal:Crystal_SMD_3225-4Pin_3.2x2.5mm | 3 | Резонатор кварцевый smd | 5 | https://energoflot.ru/item/X322516MLB4SI | 1 | 9 | 45
Y2 | KSE-7K32768KDY2400A3 | user_lib:KSE-7K32768KDY2400A3 | 1 | SMD-резонатор | 36 | https://www.chipdip.ru/product0/8022143960 | 1 | 3 | 108
D4,D7 | ss54 | Diode_SMD:D_SMC | 2 | Диод Шоттки 40V 5А | 6 | https://www.promelec.ru/product/535278/ | 1 | 6 | 36
 |  |  |  |  |  |  |  | 0 | 0

Sheet: Итог
Не плата | Плата | Сумма | Лимит | Разница
304086 | 125393 | 429479 | 450000 | -20521
