buglalis/degree/img/capacitors_results.png

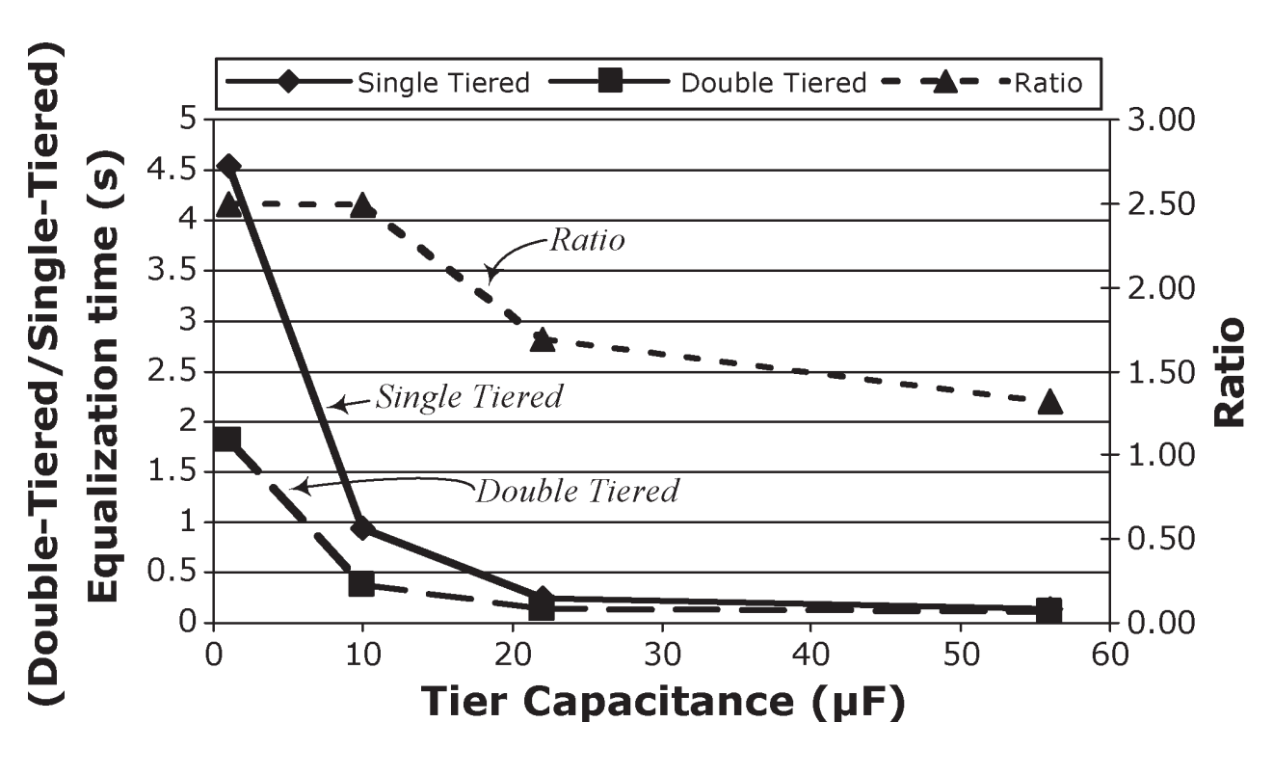
img/capacitors_results.png
