buglalis/degree/KiCad/BMS/BMS.pdf

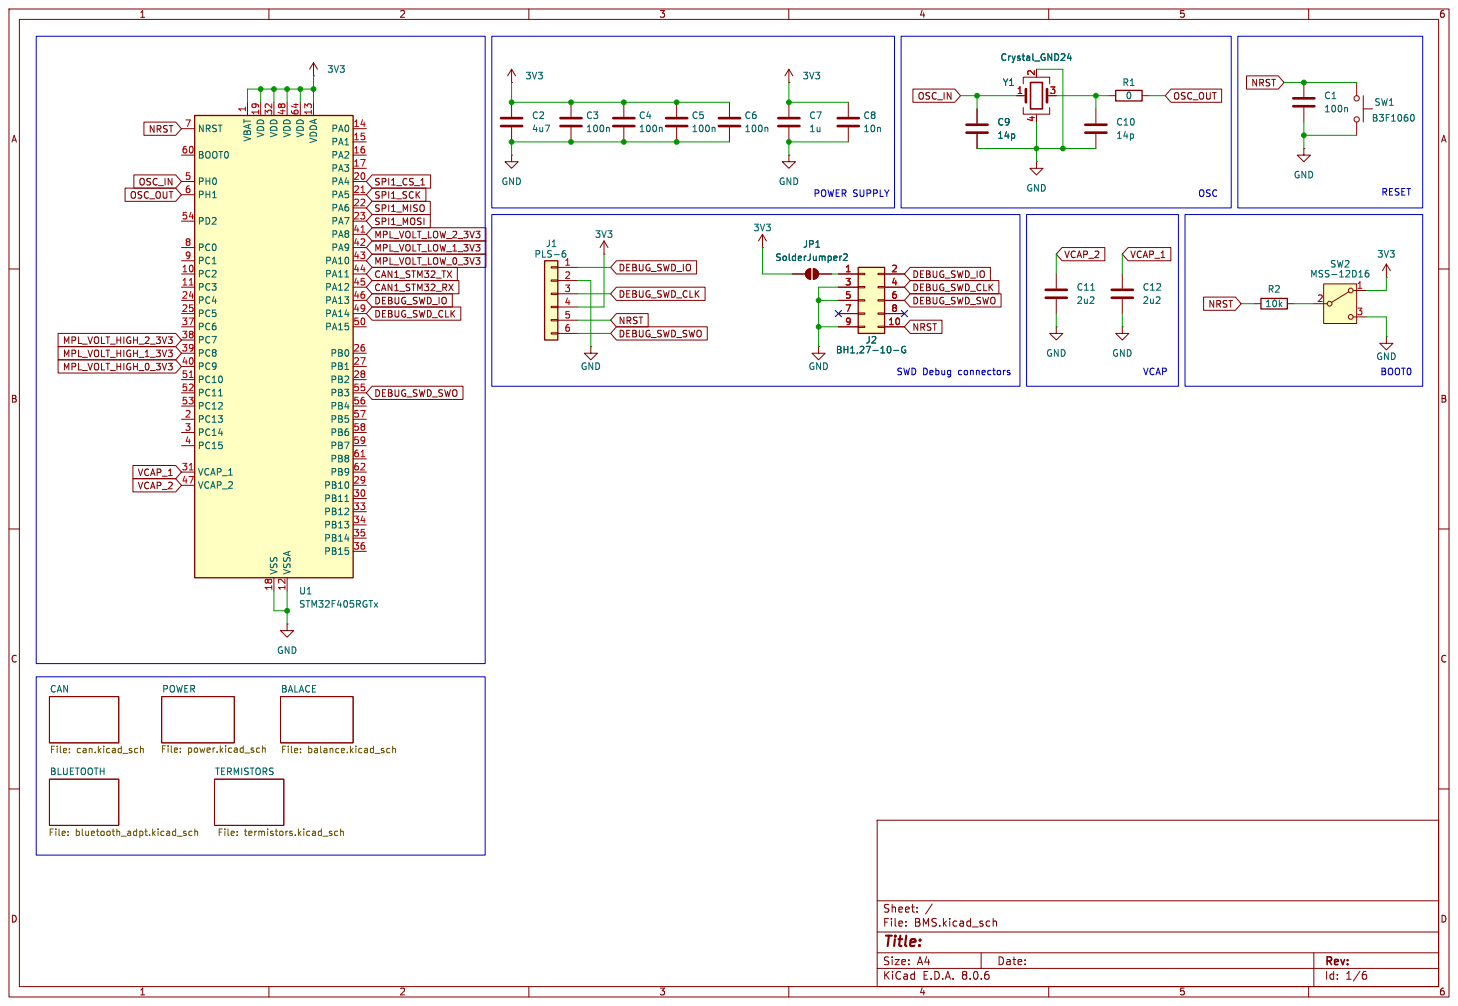
[picture p36: page 1]

1 PC2 10 PC3 11 VSSA 12 VDDA 13 PA0 14 PA1 15 PA2 16 PA3 17 VSS 18 VDD 19 PC13 2 PA4 20 PA5 21 PA6 22 PA7 23 PC4 24 PC5 25 PB0 26 PB1 27 PB2 28 PB10 29 PC14 3 PB11 30 VCAP_1 31 VDD 32 PB12 33 PB13 34 PB14 35 PB15 36 PC6 37 PC7 38 PC8 39 PC15 4 PC9 40 PA8 41 PA9 42 PA10 43 PA11 44 PA12 45 PA13 46 VCAP_2 47 VDD 48 PA14 49 PH0 5 PA15 50 PC10 51 PC11 52 PC12 53 PD2 54 PB3 55 PB4 56 PB5 57 PB6 58 PB7 59 PH1 6 BOOT0 60 PB8 61 PB9 62 VDD 64 NRST 7 PC0 8 PC1 9 U1STM32F405RGTx

Id: 1/6 Title: File: BMS.kicad_sch Sheet: / BLUETOOTH

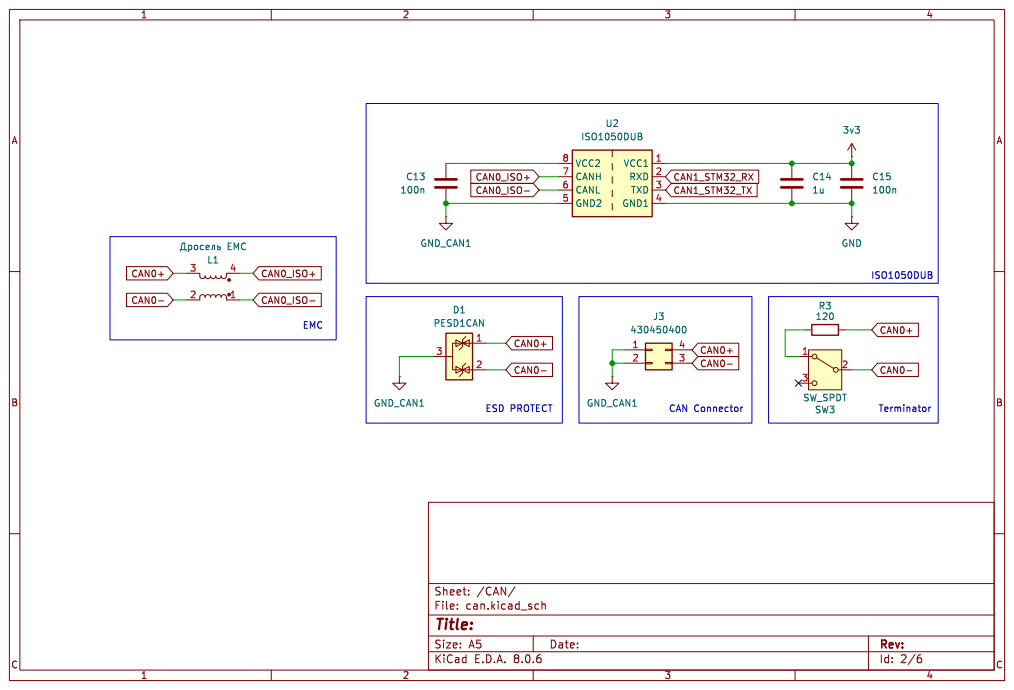
[picture p37: page 2]

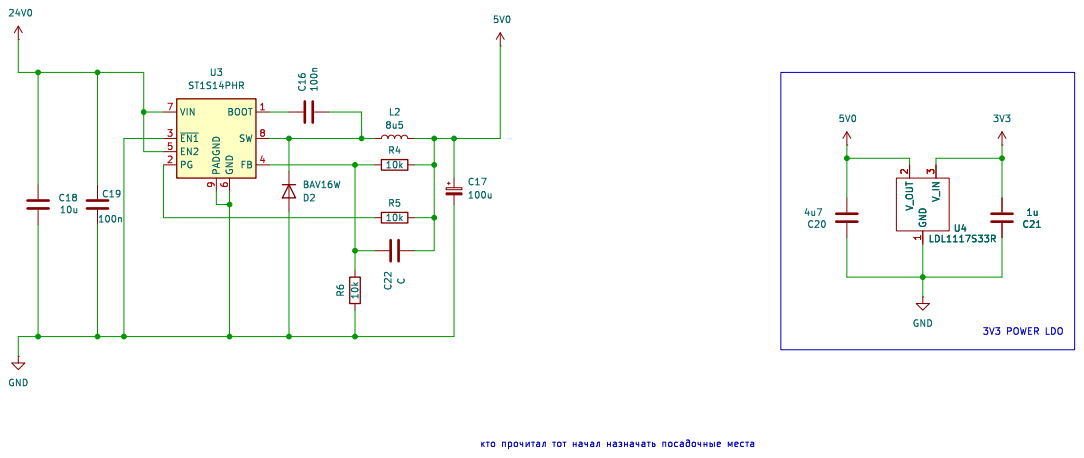
[picture p38: page 3]

Id: 3/6 Title: File: power.kicad_sch Sheet: /POWER/ R5

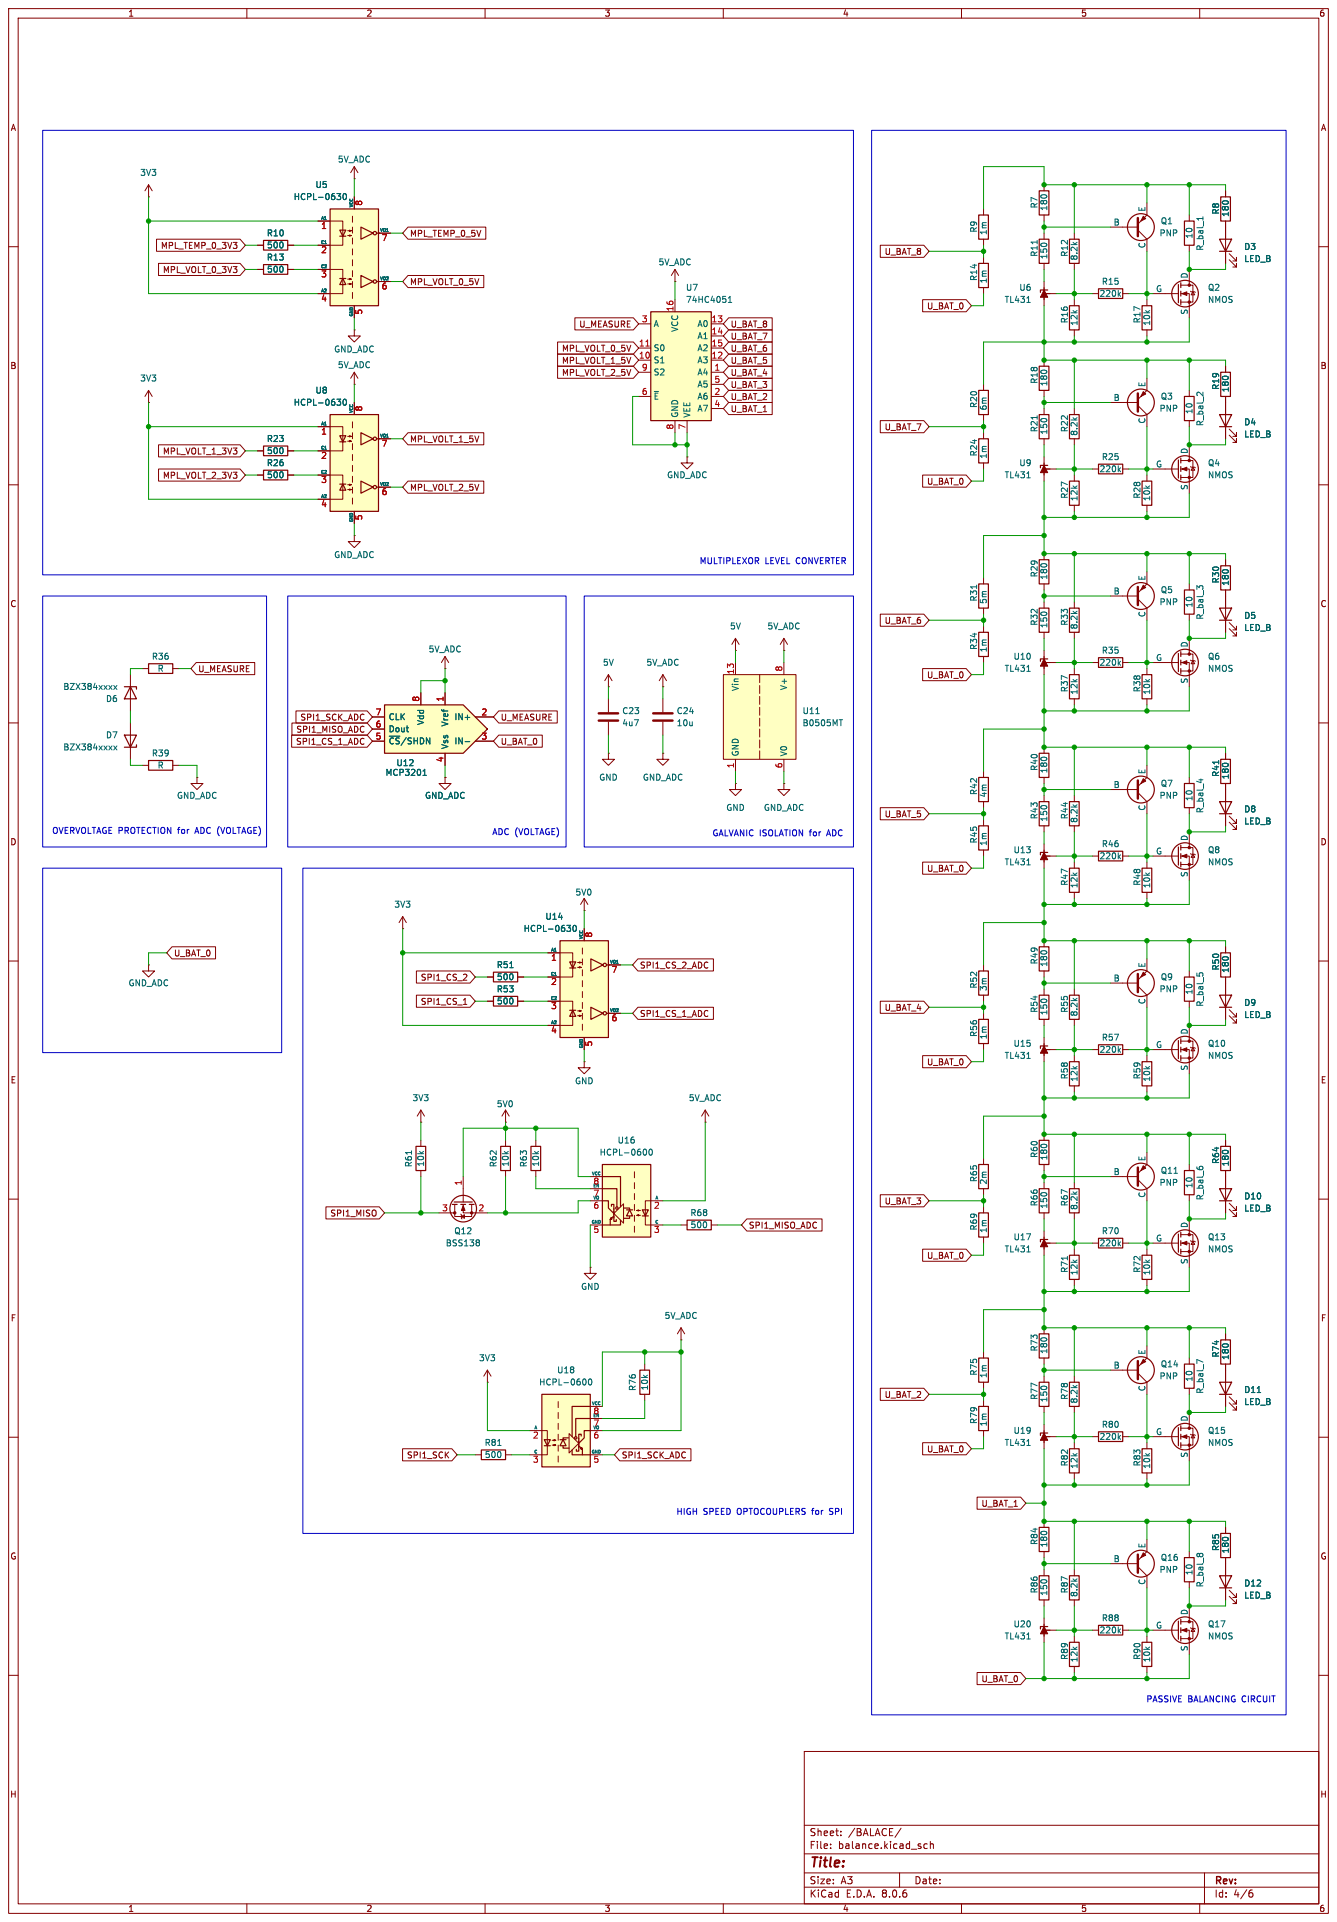
[picture p39: page 4]

Id: 4/6 Title: File: balance.kicad_sch Sheet: /BALACE/

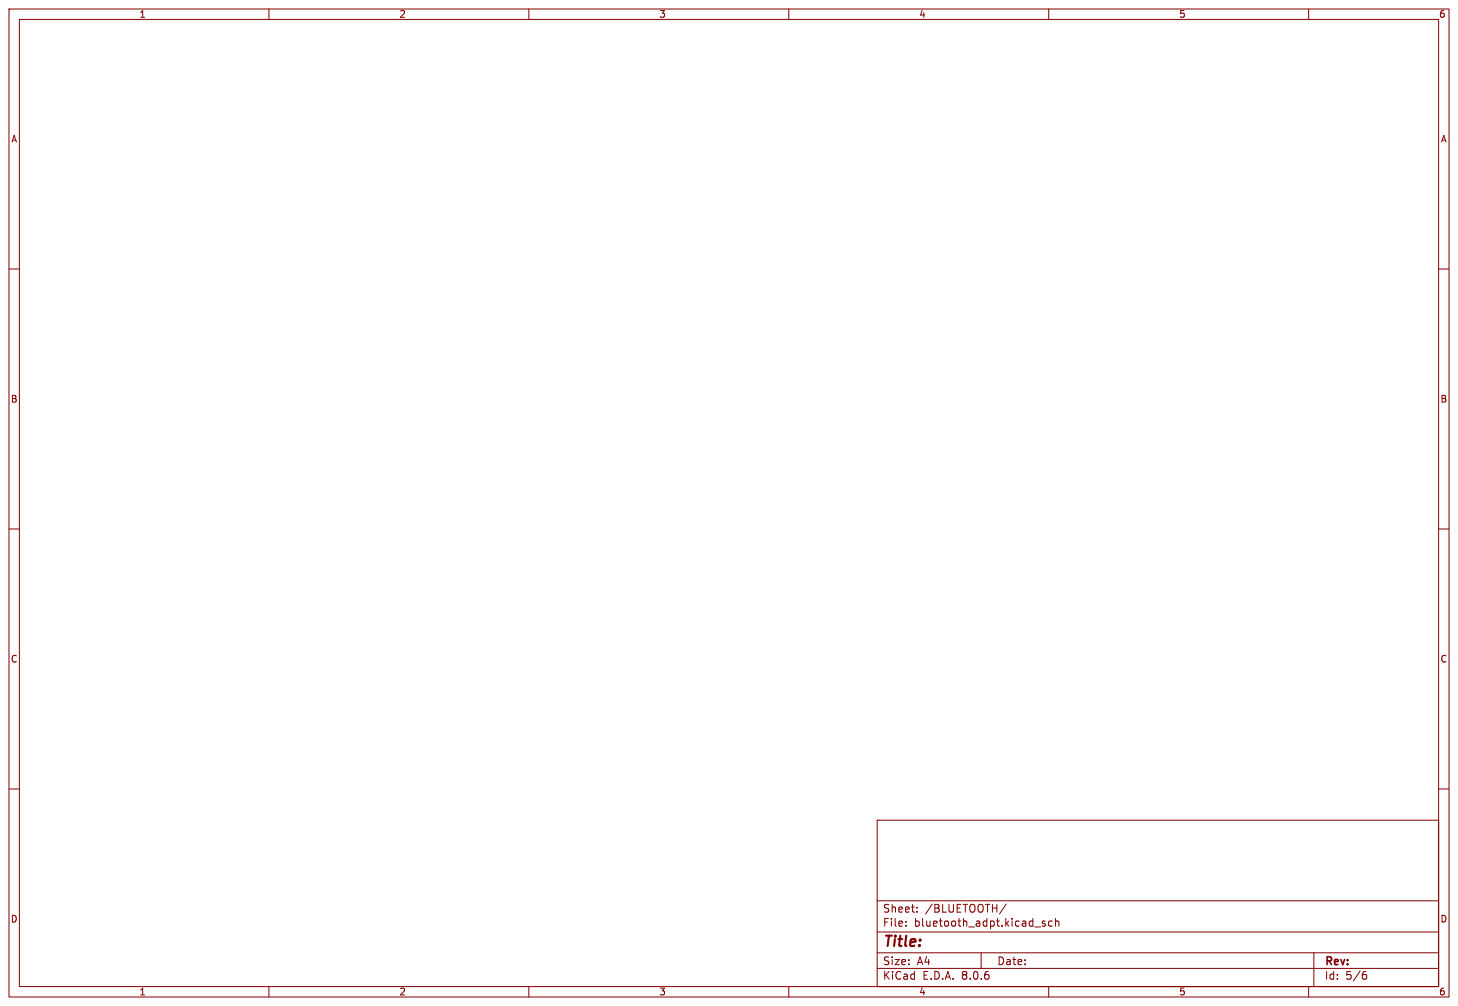
[picture p40: page 5]

Id: 5/6 Title: File: bluetooth_adpt.kicad_sch Sheet: /BLUETOOTH/

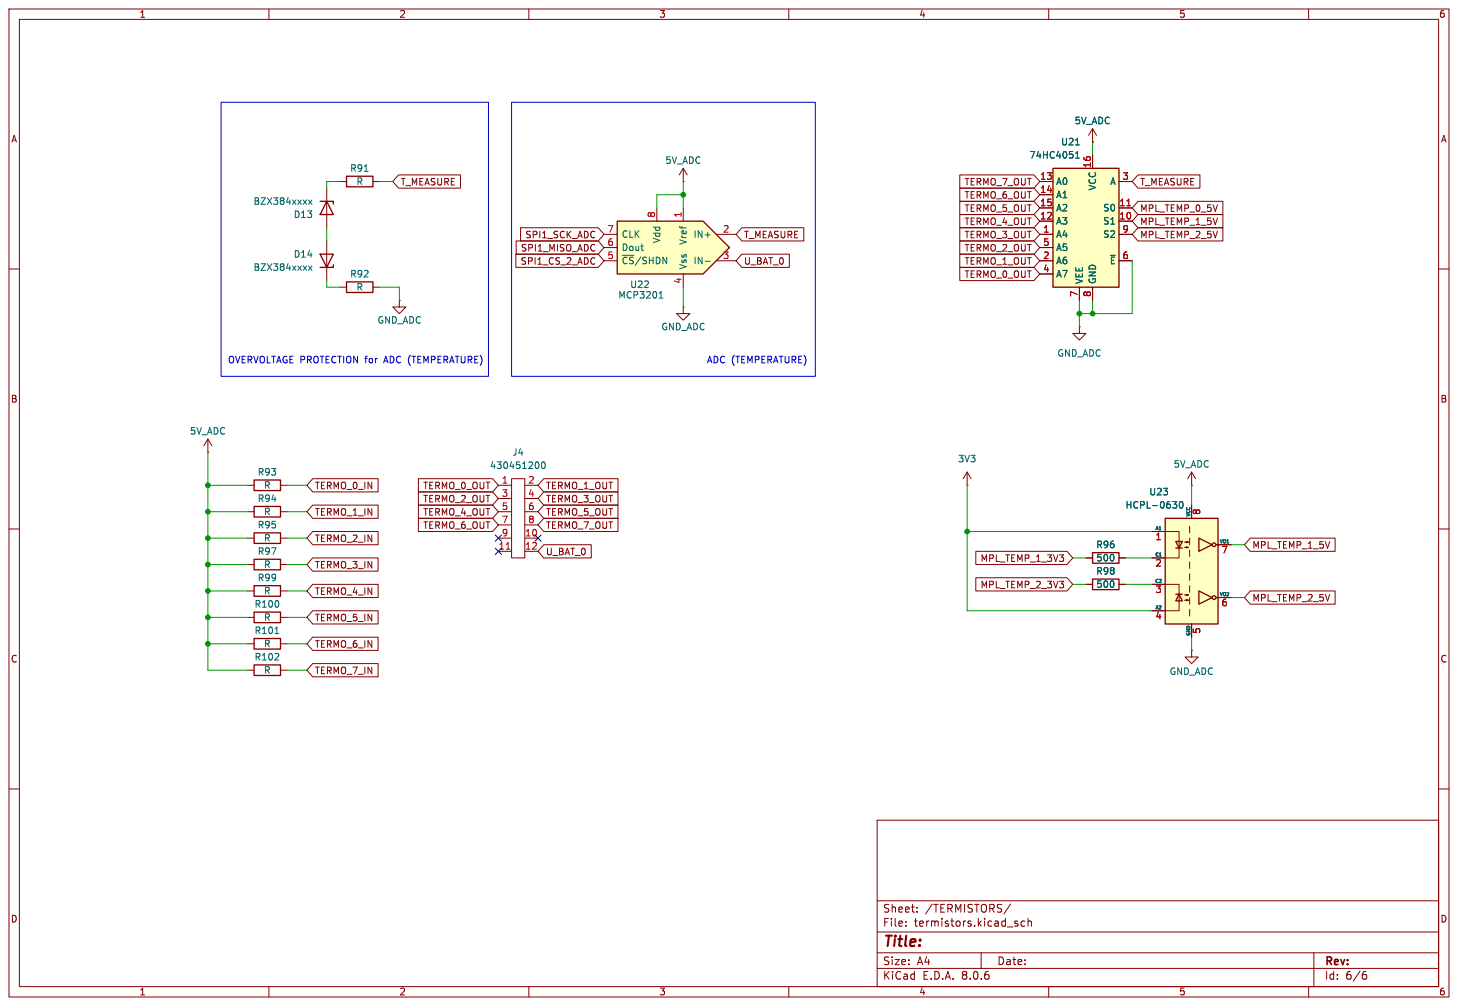
[picture p41: page 6]
