buglalis/degree/KiCad/BMS/BMS.kicad_pcb

## KiCad design KiCad/BMS/BMS.kicad_pcb (2025-05-21)

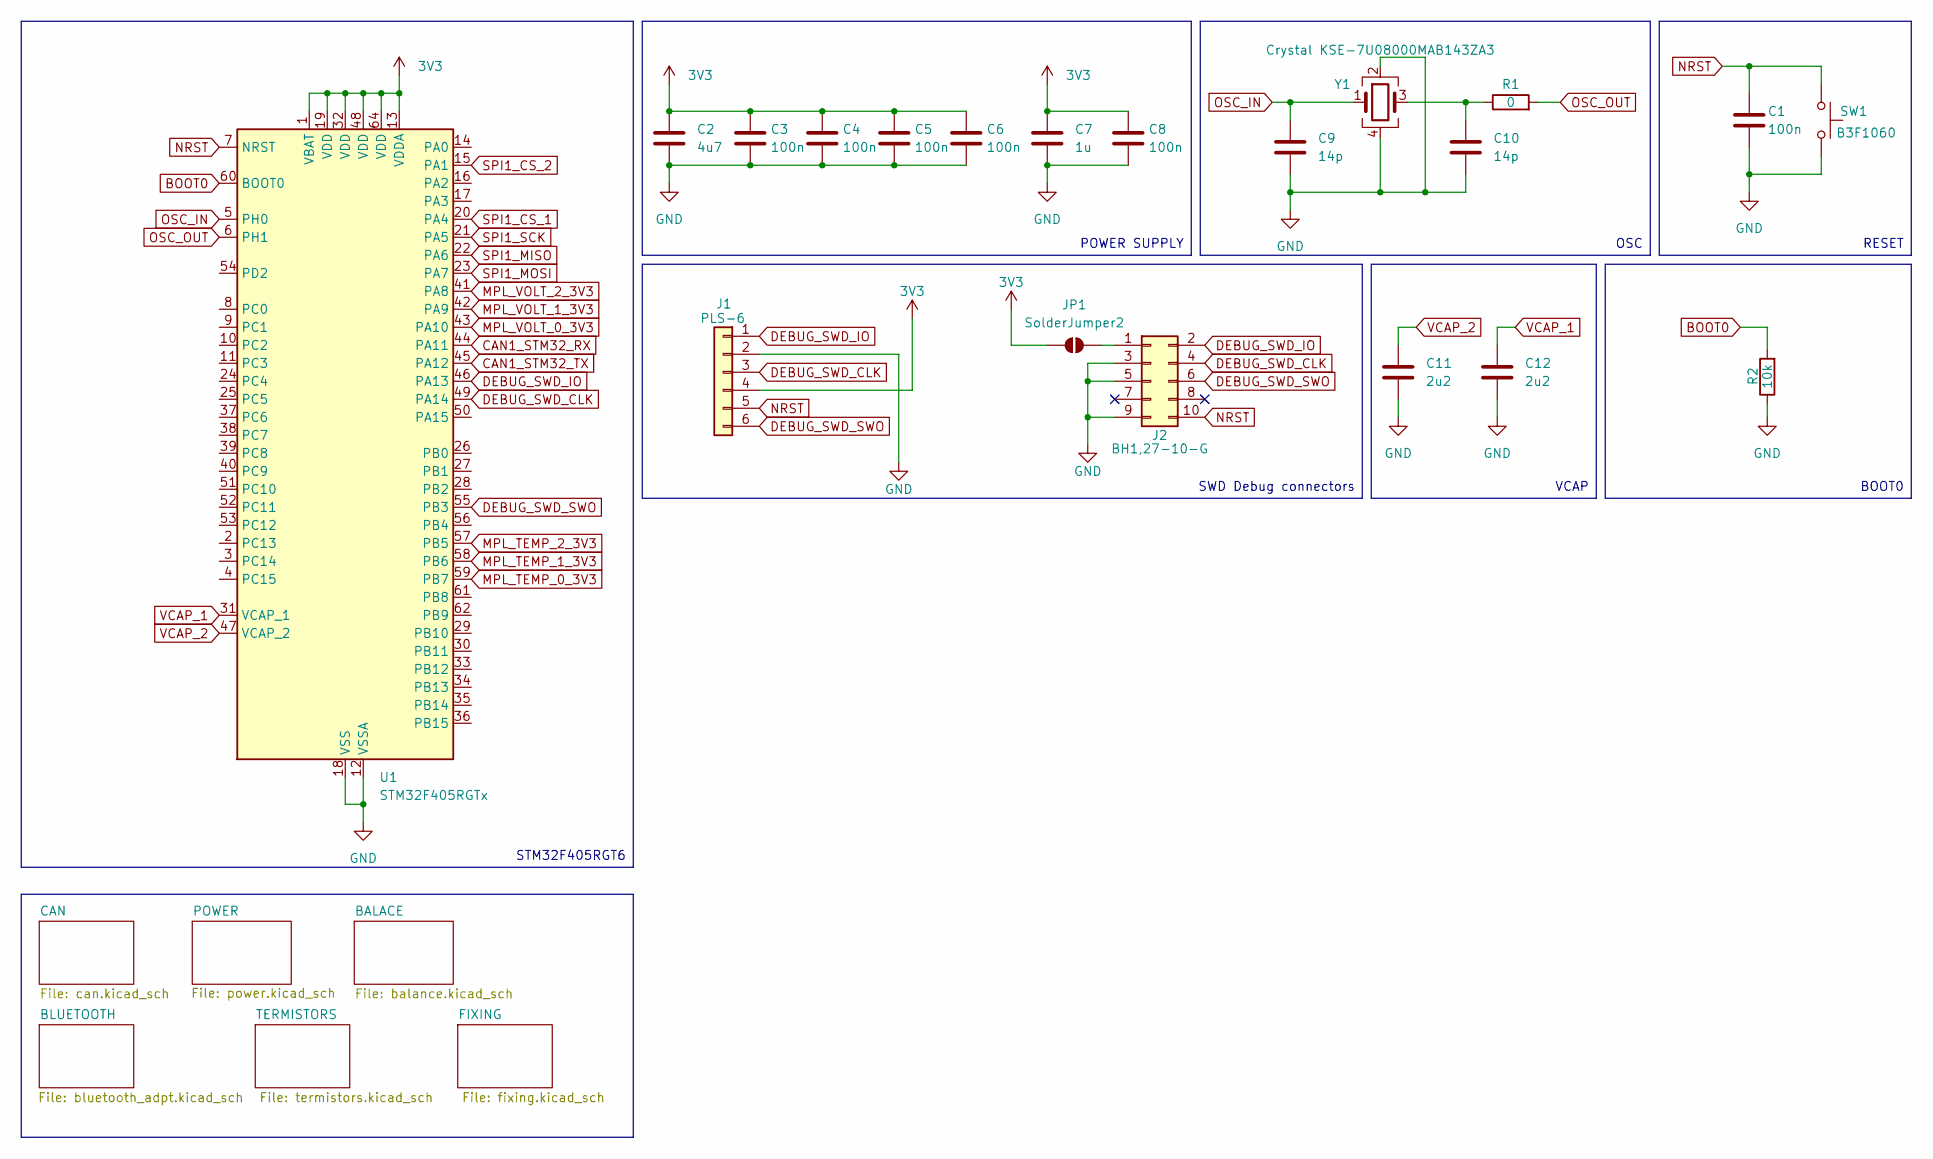
[picture p42: schematic BMS.kicad_sch]

Parts:
C1, C3, C4, C5, C6, C8: 100n; C_0603_1608Metric
C2: 4u7; C_0603_1608Metric
C7: 1u; C_0603_1608Metric
C9, C10: 14p; C_0603_1608Metric
C11, C12: 2u2; C_0603_1608Metric
J1: PLS-6; PinHeader_1x06_P2.54mm_Vertical
J2: BH1,27-10-G; PinHeader_2x05_P1.27mm_Vertical
JP1: SolderJumper2; SolderJumper-2_P1.3mm_Open_RoundedPad1.0x1.5mm
R1: 0; R_0603_1608Metric
R2: 10k; R_0603_1608Metric
SW1: B3F1060; SW_PUSH_6mm_H5mm
U1: STM32F405RGTx; LQFP-64_10x10mm_P0.5mm
Y1: Crystal KSE-7U08000MAB143ZA3; Crystal_SMD_SeikoEpson_TSX3225-4Pin_3.2x2.5mm

Connections:
3V3: C2.1, C3.1, C4.1, C5.1, C6.1, C7.1, C8.1, J1.4, JP1.1 (A), U1.1 (VBAT), U1.13 (VDDA), U1.19 (VDD), U1.32 (VDD), U1.48 (VDD), U1.64 (VDD); also elsewhere on the board
BOOT0: R2.2, U1.60 (BOOT0)
CAN1_STM32_RX: U1.44 (PA11); also elsewhere on the board
CAN1_STM32_TX: U1.45 (PA12); also elsewhere on the board
DEBUG_SWD_CLK: J1.3, J2.4, U1.49 (PA14)
DEBUG_SWD_IO: J1.1, J2.2, U1.46 (PA13)
DEBUG_SWD_SWO: J1.6, J2.6, U1.55 (PB3)
GND: C1.1, C2.2, C3.2, C4.2, C5.2, C6.2, C7.2, C8.2, C9.1, C10.2, C11.2, C12.2, J1.2, J2.3, J2.5, J2.9, R2.1, SW1.2, U1.12 (VSSA), U1.18 (VSS), U1.63 (VSS), Y1.2, Y1.4; also elsewhere on the board
MPL_TEMP_0_3V3: U1.59 (PB7); also elsewhere on the board
MPL_TEMP_1_3V3: U1.58 (PB6); also elsewhere on the board
MPL_TEMP_2_3V3: U1.57 (PB5); also elsewhere on the board
MPL_VOLT_0_3V3: U1.43 (PA10); also elsewhere on the board
MPL_VOLT_1_3V3: U1.42 (PA9); also elsewhere on the board
MPL_VOLT_2_3V3: U1.41 (PA8); also elsewhere on the board
NRST: C1.2, J1.5, J2.10, SW1.1, U1.7 (NRST)
unnamed: C10.1, R1.1, Y1.3
unnamed: J2.1, JP1.2 (B)
OSC_IN: C9.2, U1.5 (PH0), Y1.1
OSC_OUT: R1.2, U1.6 (PH1)
SPI1_CS_1: U1.20 (PA4); also elsewhere on the board
SPI1_CS_2: U1.15 (PA1); also elsewhere on the board
SPI1_MISO: U1.22 (PA6); also elsewhere on the board
SPI1_MOSI: U1.23 (PA7)
SPI1_SCK: U1.21 (PA5); also elsewhere on the board
VCAP_1: C12.1, U1.31 (VCAP_1)
VCAP_2: C11.1, U1.47 (VCAP_2)

Notes on the sheet:
RESET
SWD Debug connectors
OSC
POWER SUPPLY
VCAP
STM32F405RGT6
BOOT0

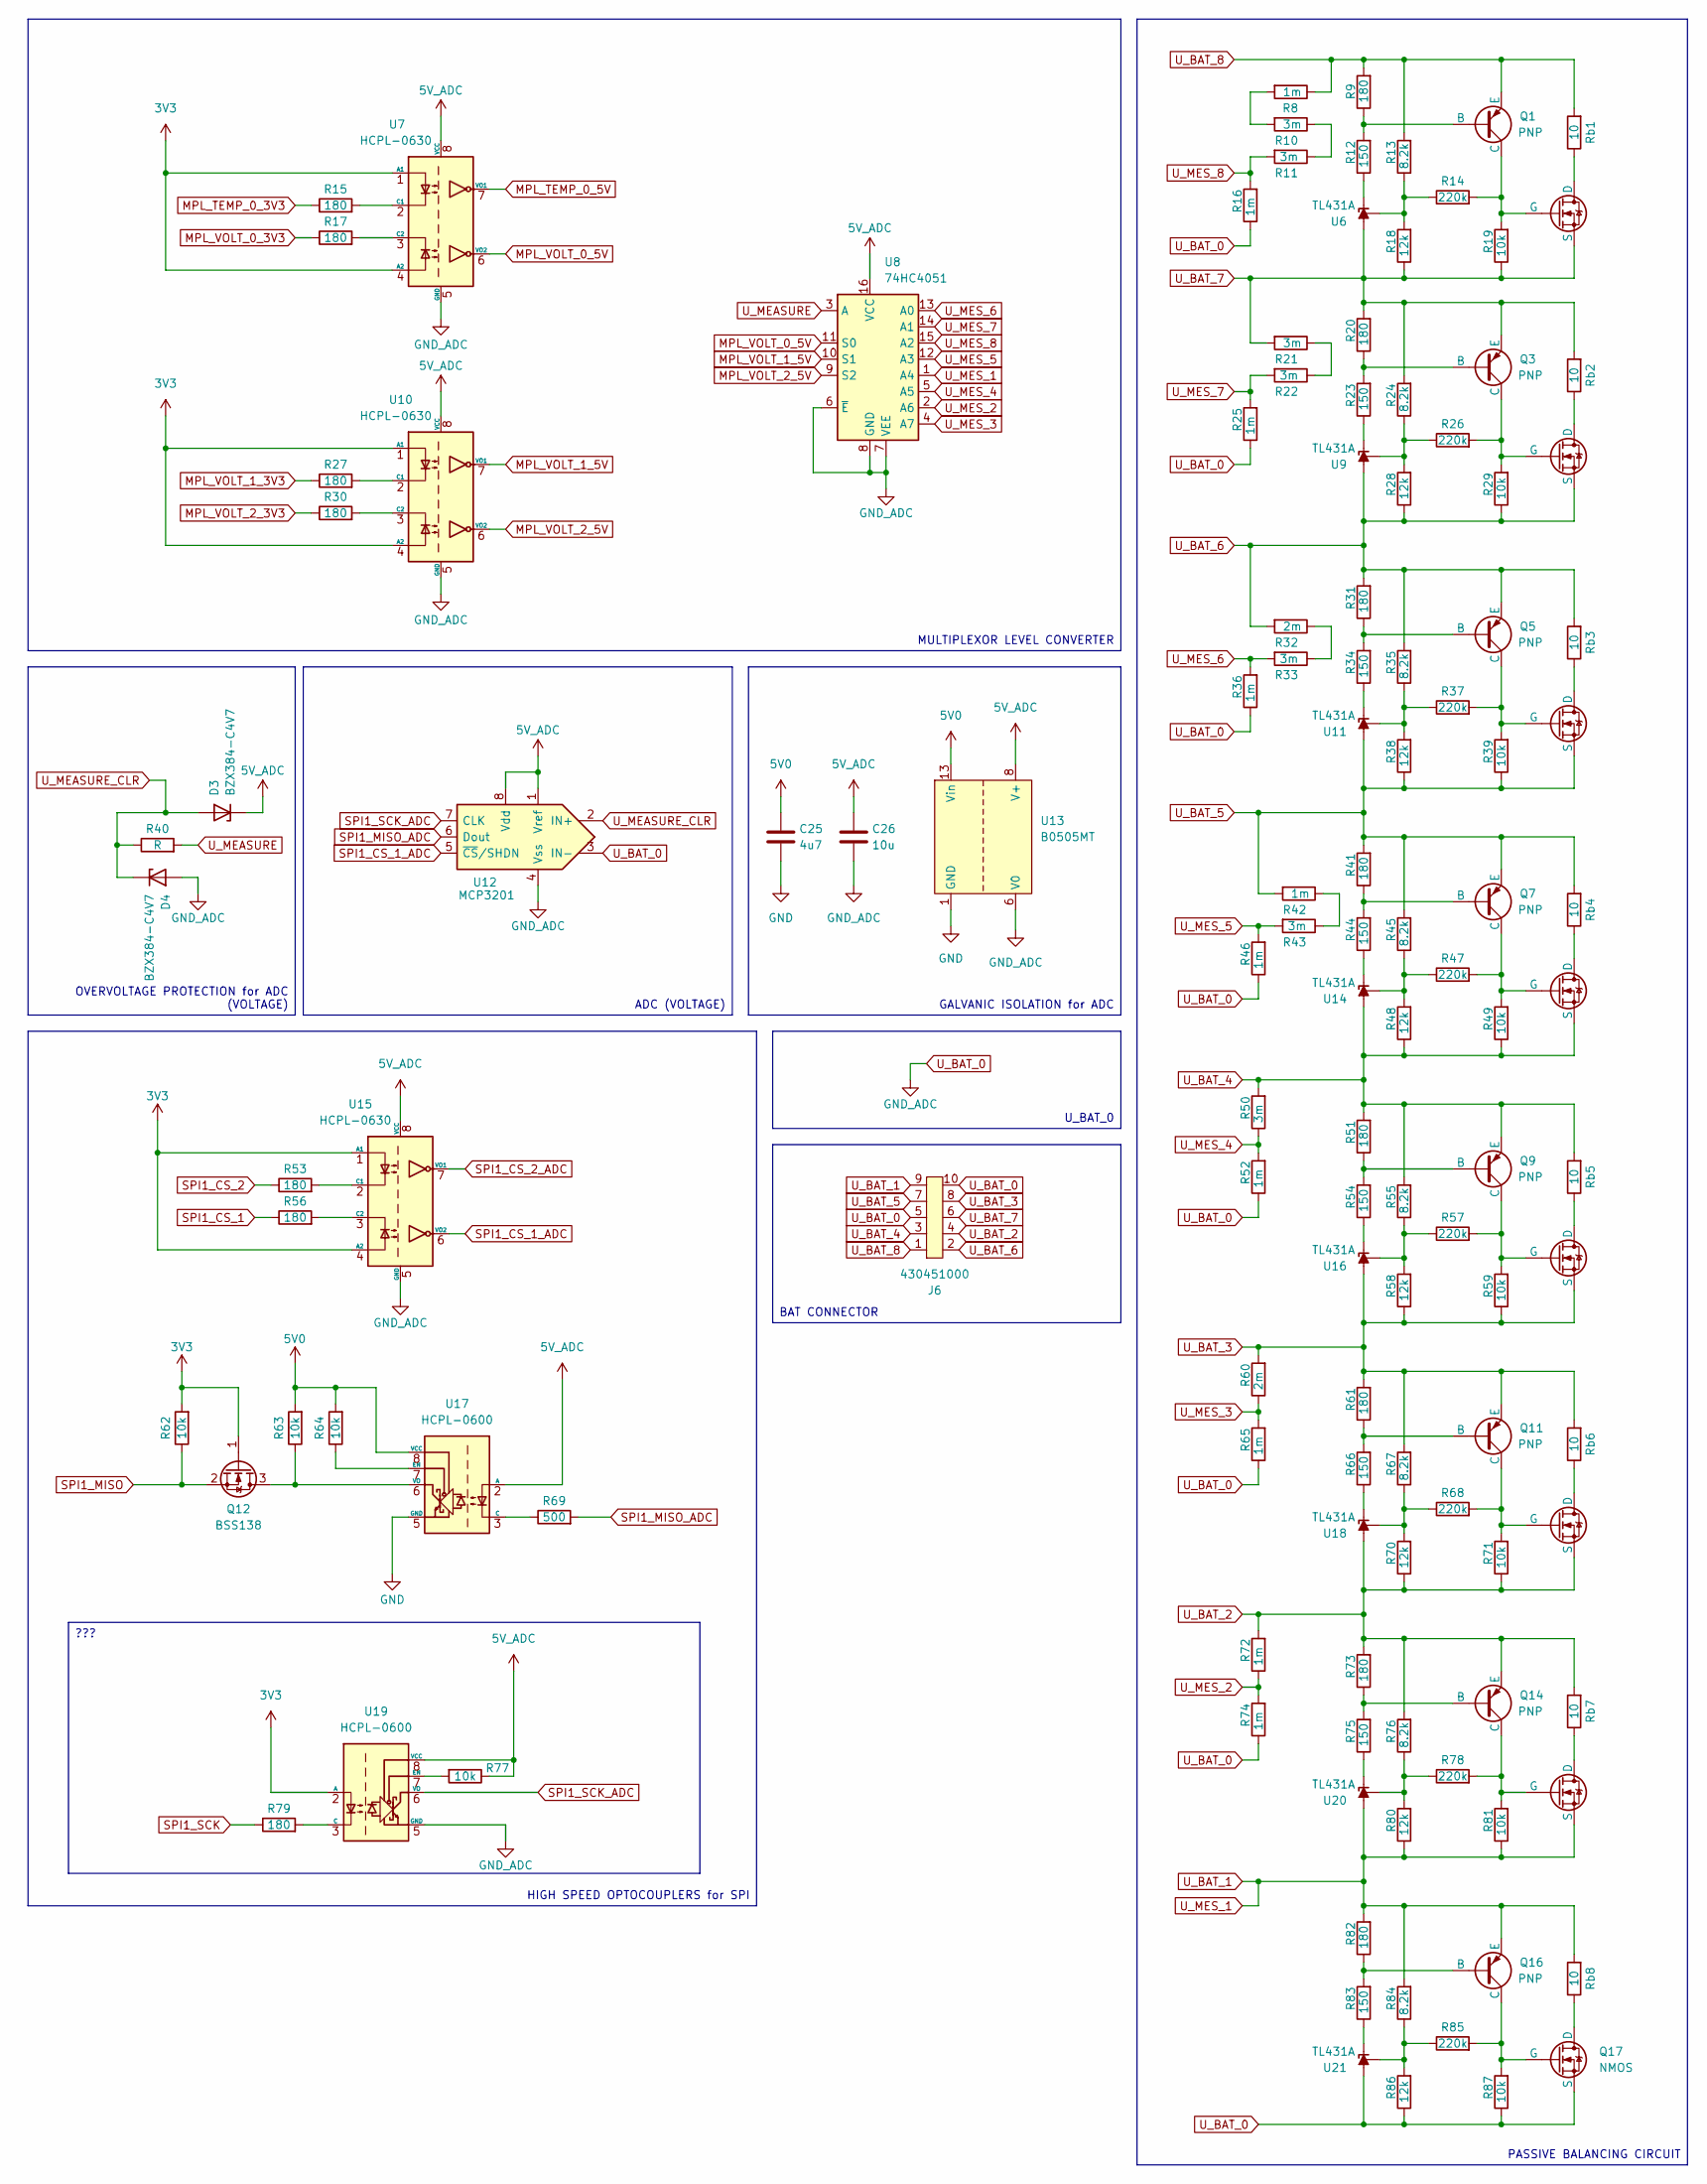
[picture p43: schematic balance.kicad_sch]

Parts:
C25: 4u7; C_0603_1608Metric
C26: 10u; C_0603_1608Metric
D3, D4: BZX384-C4V7; D_SOD-323_HandSoldering
J6: 430451000; Molex_Micro-Fit_3.0_43045-1000_2x05_P3.00mm_Horizontal
Q1, Q3, Q5, Q7, Q9, Q11, Q14, Q16: PNP; SOT-23-3
Q2, Q4, Q6, Q8, Q10, Q13, Q15, Q17: NMOS; TO-252-2
Q12: BSS138; SOT-23
R8, R16, R25, R36, R42, R46, R52, R65, R72, R74: 1m; R_0603_1608Metric
R9, R15, R17, R20, R27, R30, R31, R41, R51, R53, R56, R61, R73, R79, R82: 180; R_0603_1608Metric
R10, R11, R21, R22, R33, R43, R50: 3m; R_0603_1608Metric
R12, R23, R34, R44, R54, R66, R75, R83: 150; R_0603_1608Metric
R13, R24, R35, R45, R55, R67, R76, R84: 8.2k; R_0603_1608Metric
R14, R26, R37, R47, R57, R68, R78, R85: 220k; R_0603_1608Metric
R18, R28, R38, R48, R58, R70, R80, R86: 12k; R_0603_1608Metric
R19, R29, R39, R49, R59, R62, R63, R64, R71, R77, R81, R87: 10k; R_0603_1608Metric
R32, R60: 2m; R_0603_1608Metric
R40: R; R_0603_1608Metric
R69: 500; R_0603_1608Metric
Rb1, Rb2, Rb3, Rb4, Rb5, Rb6, Rb7, Rb8: 10; R_1206_3216Metric
U6, U9, U11, U14, U16, U18, U20, U21: TL431A; SOT-23
U7, U10, U15: HCPL-0630; SOIC-8_3.9x4.9mm_P1.27mm
U8: 74HC4051; TSSOP-16_4.4x5mm_P0.65mm
U12: MCP3201; SO-8_3.9x4.9mm_P1.27mm
U13: B0505MT
U17, U19: HCPL-0600; SOIC-8_3.9x4.9mm_P1.27mm

Connections:
3V3: Q12.1 (G), R62.2, U7.1 (A1), U7.4 (A2), U10.1 (A1), U10.4 (A2), U15.1 (A1), U15.4 (A2), U19.2 (A); also elsewhere on the board
5V0: C25.1, R63.2, R64.2, U13.13 (Vin), U13.14 (Vin), U17.8 (VCC); also elsewhere on the board
5V_ADC: C26.1, D3.1 (K), R77.1, U7.8 (VCC), U8.16 (VCC), U10.8 (VCC), U12.1 (Vref), U12.8 (Vdd), U13.8 (V+), U15.8 (VCC), U17.2 (A), U19.8 (VCC); also elsewhere on the board
GND: C25.2, U13.1 (GND), U13.2 (GND), U17.5 (GND); also elsewhere on the board
MPL_TEMP_0_3V3: R15.1; also elsewhere on the board
MPL_TEMP_0_5V: U7.7 (VO1); also elsewhere on the board
MPL_VOLT_0_3V3: R17.1; also elsewhere on the board
MPL_VOLT_0_5V: U7.6 (VO2), U8.11 (S0)
MPL_VOLT_1_3V3: R27.1; also elsewhere on the board
MPL_VOLT_1_5V: U8.10 (S1), U10.7 (VO1)
MPL_VOLT_2_3V3: R30.1; also elsewhere on the board
MPL_VOLT_2_5V: U8.9 (S2), U10.6 (VO2)
unnamed: Q1.2 (B), R9.1, R12.2
unnamed: Q1.1 (C), Q2.2 (G), R14.2, R19.2
unnamed: Q2.1 (D), Rb1.1
unnamed: Q3.2 (B), R20.1, R23.2
unnamed: Q3.1 (C), Q4.2 (G), R26.2, R29.2
unnamed: Q4.1 (D), Rb2.1
unnamed: Q5.2 (B), R31.1, R34.2
unnamed: Q5.1 (C), Q6.2 (G), R37.2, R39.2
unnamed: Q6.1 (D), Rb3.1
unnamed: Q7.2 (B), R41.1, R44.2
unnamed: Q7.1 (C), Q8.2 (G), R47.2, R49.2
unnamed: Q8.1 (D), Rb4.1
unnamed: Q9.2 (B), R51.1, R54.2
unnamed: Q10.1 (D), Rb5.1
unnamed: Q9.1 (C), Q10.2 (G), R57.2, R59.2
unnamed: Q11.2 (B), R61.1, R66.2
unnamed: Q11.1 (C), Q13.2 (G), R68.2, R71.2
unnamed: Q12.3 (D), R63.1, U17.6 (VO)
unnamed: Q13.1 (D), Rb6.1
unnamed: Q14.2 (B), R73.1, R75.2
unnamed: Q14.1 (C), Q15.2 (G), R78.2, R81.2
unnamed: Q15.1 (D), Rb7.1
unnamed: Q16.2 (B), R82.1, R83.2
unnamed: Q16.1 (C), Q17.2 (G), R85.2, R87.2
unnamed: Q17.1 (D), Rb8.1
unnamed: R10.1, R11.1
unnamed: R8.2, R10.2
unnamed: R21.1, R22.1
unnamed: R32.1, R33.1
unnamed: R42.1, R43.1
unnamed: R12.1, U6.2 (K)
unnamed: R13.1, R14.1, R18.2, U6.1 (REF)
unnamed: R15.2, U7.2 (C1)
unnamed: R17.2, U7.3 (C2)
unnamed: R23.1, U9.2 (K)
unnamed: R24.1, R26.1, R28.2, U9.1 (REF)
unnamed: R27.2, U10.2 (C1)
unnamed: R30.2, U10.3 (C2)
unnamed: R34.1, U11.2 (K)
unnamed: R35.1, R37.1, R38.2, U11.1 (REF)
unnamed: R44.1, U14.2 (K)
unnamed: R45.1, R47.1, R48.2, U14.1 (REF)
unnamed: R53.2, U15.2 (C1)
unnamed: R56.2, U15.3 (C2)
unnamed: R54.1, U16.2 (K)
unnamed: R55.1, R57.1, R58.2, U16.1 (REF)
unnamed: R69.1, U17.3 (C)
unnamed: R64.1, U17.7 (EN)
unnamed: R66.1, U18.2 (K)
unnamed: R67.1, R68.1, R70.2, U18.1 (REF)
unnamed: R79.2, U19.3 (C)
unnamed: R77.2, U19.7 (EN)
unnamed: R75.1, U20.2 (K)
unnamed: R76.1, R78.1, R80.2, U20.1 (REF)
unnamed: R83.1, U21.2 (K)
unnamed: R84.1, R85.1, R86.2, U21.1 (REF)
SPI1_CS_1: R56.1; also elsewhere on the board
SPI1_CS_1_ADC: U12.5 (~CS/SHDN), U15.6 (VO2)
SPI1_CS_2: R53.1; also elsewhere on the board
SPI1_CS_2_ADC: U15.7 (VO1); also elsewhere on the board
SPI1_MISO: Q12.2 (S), R62.1; also elsewhere on the board
SPI1_MISO_ADC: R69.2, U12.6 (Dout); also elsewhere on the board
SPI1_SCK: R79.1; also elsewhere on the board
SPI1_SCK_ADC: U12.7 (CLK), U19.6 (VO); also elsewhere on the board
U_BAT_0: C26.2, D4.2 (A), J6.5, J6.10, Q17.3 (S), R16.1, R25.1, R36.1, R46.1, R52.1, R65.1, R74.1, R86.1, R87.1, U7.5 (GND), U8.6 (~E), U8.7 (VEE), U8.8 (GND), U10.5 (GND), U12.3 (IN-), U12.4 (Vss), U13.6 (V0), U13.7 (V0), U15.5 (GND), U19.5 (GND), U21.3 (A); also elsewhere on the board
U_BAT_1: J6.9, Q15.3 (S), Q16.3 (E), R80.1, R81.1, R82.2, R84.2, Rb8.2, U8.1 (A4), U20.3 (A)
U_BAT_2: J6.4, Q13.3 (S), Q14.3 (E), R70.1, R71.1, R72.2, R73.2, R76.2, Rb7.2, U18.3 (A)
U_BAT_3: J6.8, Q10.3 (S), Q11.3 (E), R58.1, R59.1, R60.2, R61.2, R67.2, Rb6.2, U16.3 (A)
U_BAT_4: J6.3, Q8.3 (S), Q9.3 (E), R48.1, R49.1, R50.2, R51.2, R55.2, Rb5.2, U14.3 (A)
U_BAT_5: J6.7, Q6.3 (S), Q7.3 (E), R38.1, R39.1, R41.2, R42.2, R45.2, Rb4.2, U11.3 (A)
U_BAT_6: J6.2, Q4.3 (S), Q5.3 (E), R28.1, R29.1, R31.2, R32.2, R35.2, Rb3.2, U9.3 (A)
U_BAT_7: J6.6, Q2.3 (S), Q3.3 (E), R18.1, R19.1, R20.2, R21.2, R24.2, Rb2.2, U6.3 (A)
U_BAT_8: J6.1, Q1.3 (E), R8.1, R9.2, R13.2, Rb1.2
U_MEASURE: R40.2, U8.3 (A)
U_MEASURE_CLR: D3.2 (A), D4.1 (K), R40.1, U12.2 (IN+)
U_MES_2: R72.1, R74.2, U8.2 (A6)
U_MES_3: R60.1, R65.2, U8.4 (A7)
U_MES_4: R50.1, R52.2, U8.5 (A5)
U_MES_5: R43.2, R46.2, U8.12 (A3)
U_MES_6: R33.2, R36.2, U8.13 (A0)
U_MES_7: R22.2, R25.2, U8.14 (A1)
U_MES_8: R11.2, R16.2, U8.15 (A2)

Notes on the sheet:
???
MULTIPLEXOR LEVEL CONVERTER
U_BAT_0
PASSIVE BALANCING CIRCUIT
ADC (VOLTAGE)
HIGH SPEED OPTOCOUPLERS for SPI
GALVANIC ISOLATION for ADC
BAT CONNECTOR
OVERVOLTAGE PROTECTION for ADC (VOLTAGE)

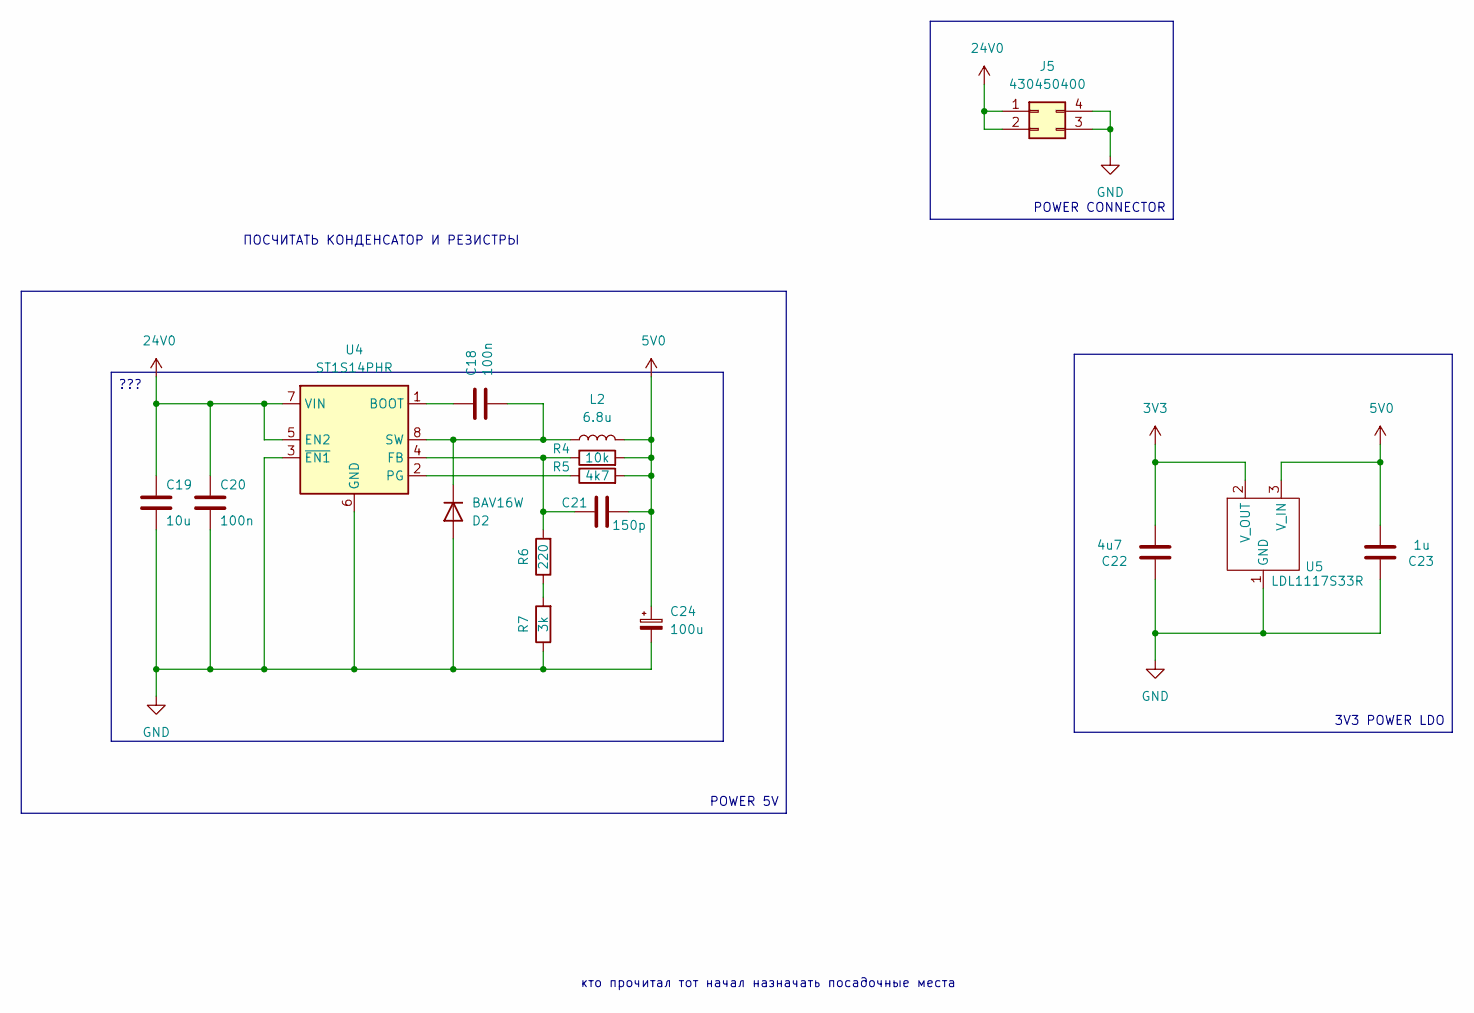
[picture p44: schematic power.kicad_sch]

Parts:
C18, C20: 100n; C_0603_1608Metric
C19: 10u; C_0603_1608Metric
C21: 150p; C_0603_1608Metric
C22: 4u7; C_0603_1608Metric
C23: 1u; C_0603_1608Metric
C24: 100u; CP_Radial_D6.3mm_P2.50mm
D2: BAV16W; D_SOD-123
J5: 430450400; Molex_Micro-Fit_3.0_43045-0400_2x02_P3.00mm_Horizontal
L2: 6.8u; CDCSAB0420-6R8M
R4: 10k; R_0603_1608Metric
R5: 4k7; R_0603_1608Metric
R6: 220; R_0603_1608Metric
R7: 3k; R_0603_1608Metric
U4: ST1S14PHR; TI_SO-PowerPAD-8
U5: LDL1117S33R; SOT-223-3_TabPin2

Connections:
3V3: C22.2, U5.2 (V_OUT); also elsewhere on the board
5V0: C21.2, C23.2, C24.1, L2.2, R4.2, R5.2, U5.3 (V_IN); also elsewhere on the board
24V0: C19.1, C20.1, J5.1, J5.2, U4.5 (EN2), U4.7 (VIN)
GND: C19.2, C20.2, C22.1, C23.1, C24.2, D2.2 (A), J5.3, J5.4, R7.1, U4.3 (~EN1), U4.6 (GND), U4.9 (PADGND), U5.1 (GND); also elsewhere on the board
unnamed: C18.2, D2.1 (K), L2.1, U4.8 (SW)
unnamed: R6.1, R7.2
unnamed: C18.1, U4.1 (BOOT)
unnamed: C21.1, R4.1, R6.2, U4.4 (FB)
unnamed: R5.1, U4.2 (PG)

Notes on the sheet:
кто прочитал тот начал назначать посадочные места
ПОСЧИТАТЬ КОНДЕНСАТОР И РЕЗИСТРЫ
POWER 5V
POWER CONNECTOR
3V3 POWER LDO
???

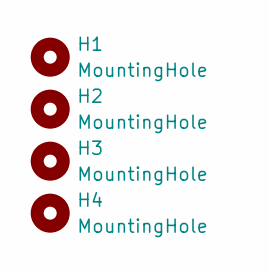
[picture p45: schematic fixing.kicad_sch]

Parts:
H1, H2, H3, H4: MountingHole; MountingHole_3.2mm_M3_Pad_Via

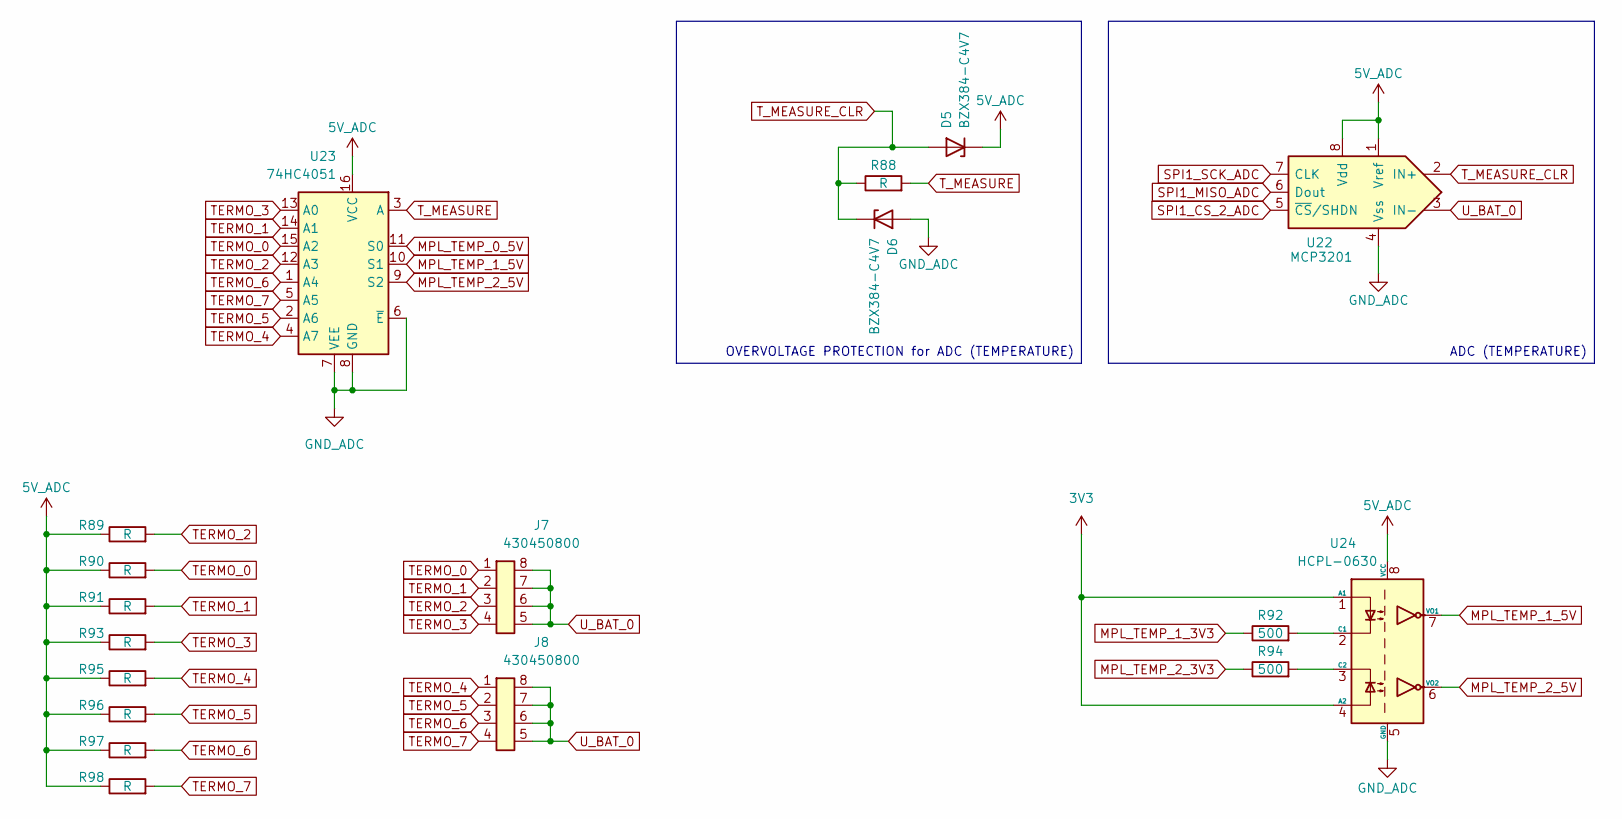
[picture p46: schematic termistors.kicad_sch]

Parts:
D5, D6: BZX384-C4V7; D_SOD-323_HandSoldering
J7, J8: 430450800; Molex_Micro-Fit_3.0_43045-0800_2x04_P3.00mm_Horizontal
R88, R89, R90, R91, R93, R95, R96, R97, R98: R; R_0603_1608Metric
R92, R94: 500; R_0603_1608Metric
U22: MCP3201; SO-8_3.9x4.9mm_P1.27mm
U23: 74HC4051; TSSOP-16_4.4x5mm_P0.65mm
U24: HCPL-0630; SOIC-8_3.9x4.9mm_P1.27mm

Connections:
3V3: U24.1 (A1), U24.4 (A2); also elsewhere on the board
5V_ADC: D5.1 (K), R89.1, R90.1, R91.1, R93.1, R95.1, R96.1, R97.1, R98.1, U22.1 (Vref), U22.8 (Vdd), U23.16 (VCC), U24.8 (VCC); also elsewhere on the board
MPL_TEMP_0_5V: U23.11 (S0); also elsewhere on the board
MPL_TEMP_1_3V3: R92.1; also elsewhere on the board
MPL_TEMP_1_5V: U23.10 (S1), U24.7 (VO1)
MPL_TEMP_2_3V3: R94.1; also elsewhere on the board
MPL_TEMP_2_5V: U23.9 (S2), U24.6 (VO2)
unnamed: R92.2, U24.2 (C1)
unnamed: R94.2, U24.3 (C2)
SPI1_CS_2_ADC: U22.5 (~CS/SHDN); also elsewhere on the board
SPI1_MISO_ADC: U22.6 (Dout); also elsewhere on the board
SPI1_SCK_ADC: U22.7 (CLK); also elsewhere on the board
TERMO_0: J7.1, R90.2, U23.15 (A2)
TERMO_1: J7.2, R91.2, U23.14 (A1)
TERMO_2: J7.3, R89.2, U23.12 (A3)
TERMO_3: J7.4, R93.2, U23.13 (A0)
TERMO_4: J8.1, R95.2, U23.4 (A7)
TERMO_5: J8.2, R96.2, U23.2 (A6)
TERMO_6: J8.3, R97.2, U23.1 (A4)
TERMO_7: J8.4, R98.2, U23.5 (A5)
T_MEASURE: R88.2, U23.3 (A)
T_MEASURE_CLR: D5.2 (A), D6.1 (K), R88.1, U22.2 (IN+)
U_BAT_0: D6.2 (A), J7.5, J7.6, J7.7, J7.8, J8.5, J8.6, J8.7, J8.8, U22.3 (IN-), U22.4 (Vss), U23.6 (~E), U23.7 (VEE), U23.8 (GND), U24.5 (GND); also elsewhere on the board

Notes on the sheet:
OVERVOLTAGE PROTECTION for ADC (TEMPERATURE)
ADC (TEMPERATURE)

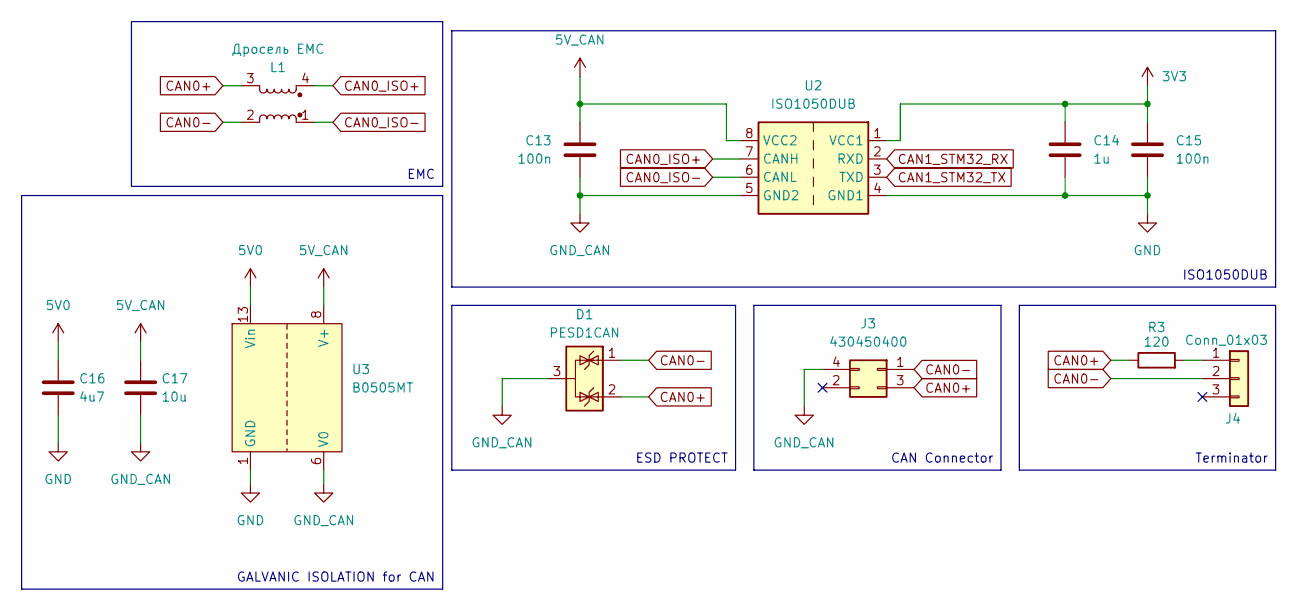
[picture p47: schematic can.kicad_sch]

Parts:
C13, C15: 100n; C_0603_1608Metric
C14: 1u; C_0603_1608Metric
C16: 4u7; C_0603_1608Metric
C17: 10u; C_0603_1608Metric
D1: PESD1CAN; SOT-23-3
J3: 430450400; Molex_Micro-Fit_3.0_43045-0400_2x02_P3.00mm_Horizontal
J4: Conn_01x03; PinHeader_1x03_P2.54mm_Vertical
L1: Дросель EMC; B82790C0513N201
R3: 120; R_0603_1608Metric
U2: ISO1050DUB; SOP-8_6.62x9.15mm_P2.54mm
U3: B0505MT

Connections:
3V3: C14.1, C15.1, U2.1 (VCC1); also elsewhere on the board
5V0: C16.1, U3.13 (Vin), U3.14 (Vin); also elsewhere on the board
5V_CAN: C13.1, C17.1, U2.8 (VCC2), U3.8 (V+)
CAN0+: D1.2 (K), J3.3, L1.3, R3.1
CAN0-: D1.1 (K), J3.1, J4.2, L1.2
CAN0_ISO+: L1.4, U2.7 (CANH)
CAN0_ISO-: L1.1, U2.6 (CANL)
CAN1_STM32_RX: U2.2 (RXD); also elsewhere on the board
CAN1_STM32_TX: U2.3 (TXD); also elsewhere on the board
GND: C14.2, C15.2, C16.2, U2.4 (GND1), U3.1 (GND), U3.2 (GND); also elsewhere on the board
GND_CAN: C13.2, C17.2, D1.3 (A), J3.4, U2.5 (GND2), U3.6 (V0), U3.7 (V0)
unnamed: J4.1, R3.2

Notes on the sheet:
Terminator
GALVANIC ISOLATION for CAN
EMC
CAN Connector
ESD PROTECT
ISO1050DUB

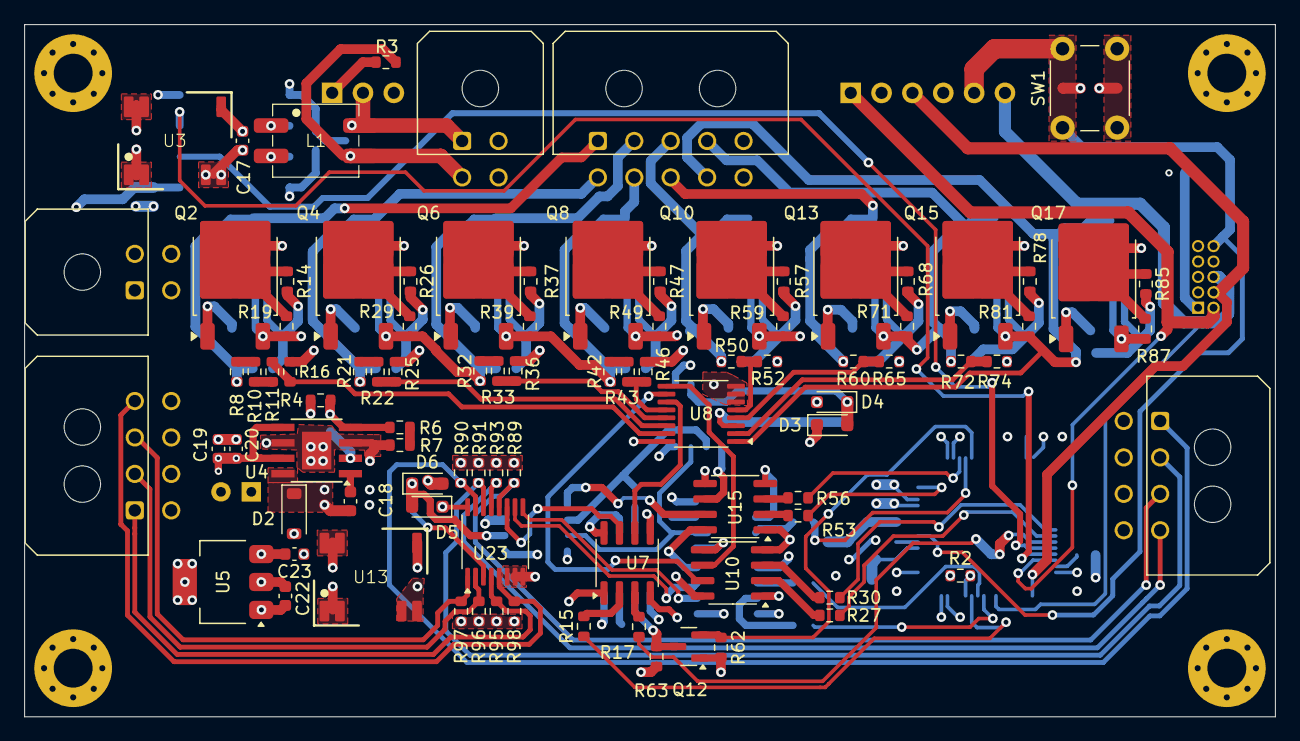
[picture p48: board BMS.kicad_pcb from above]

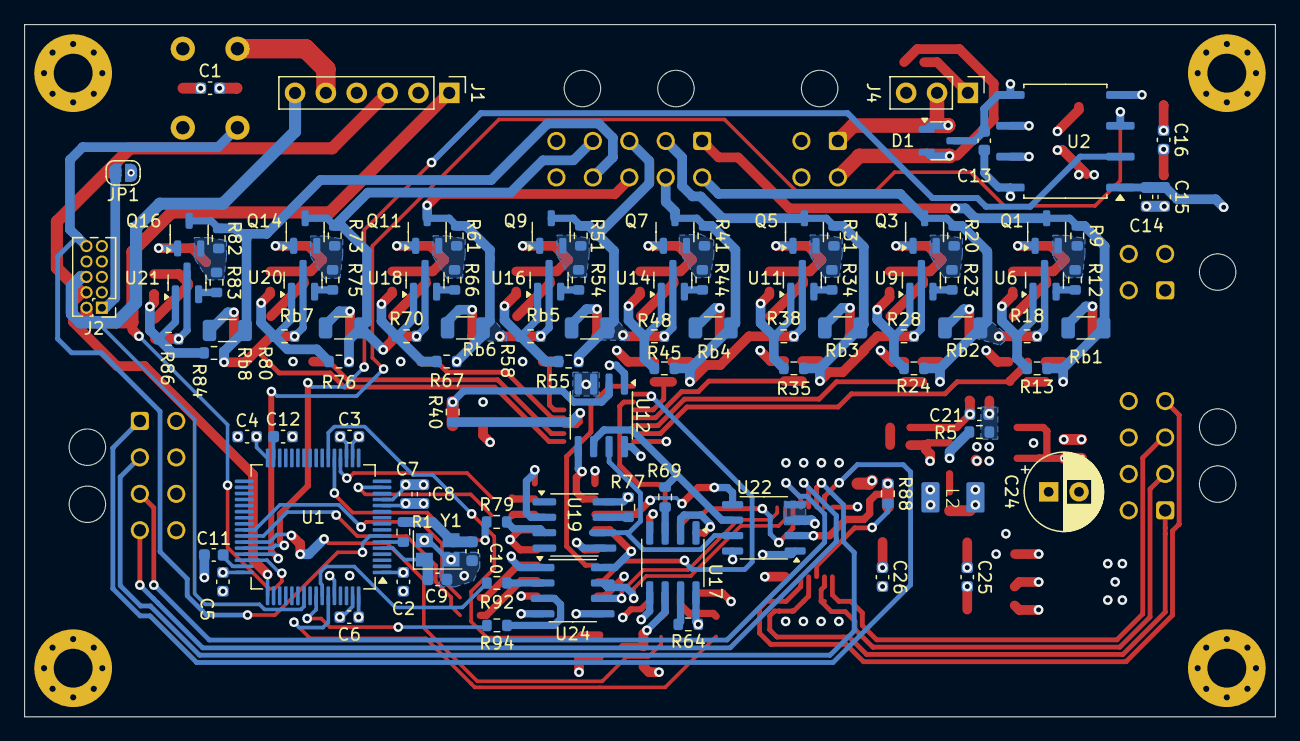
[picture p49: board BMS.kicad_pcb from below]

Board: 4 copper layers, 103.0 x 57.0 mm, 196 parts (100 on the bottom side), 136 nets.
