buglalis/degree/KiCad/Examples/impeller18/adc.kicad_sch

## KiCad design KiCad/Examples/impeller18/adc.kicad_sch (2025-03-23)

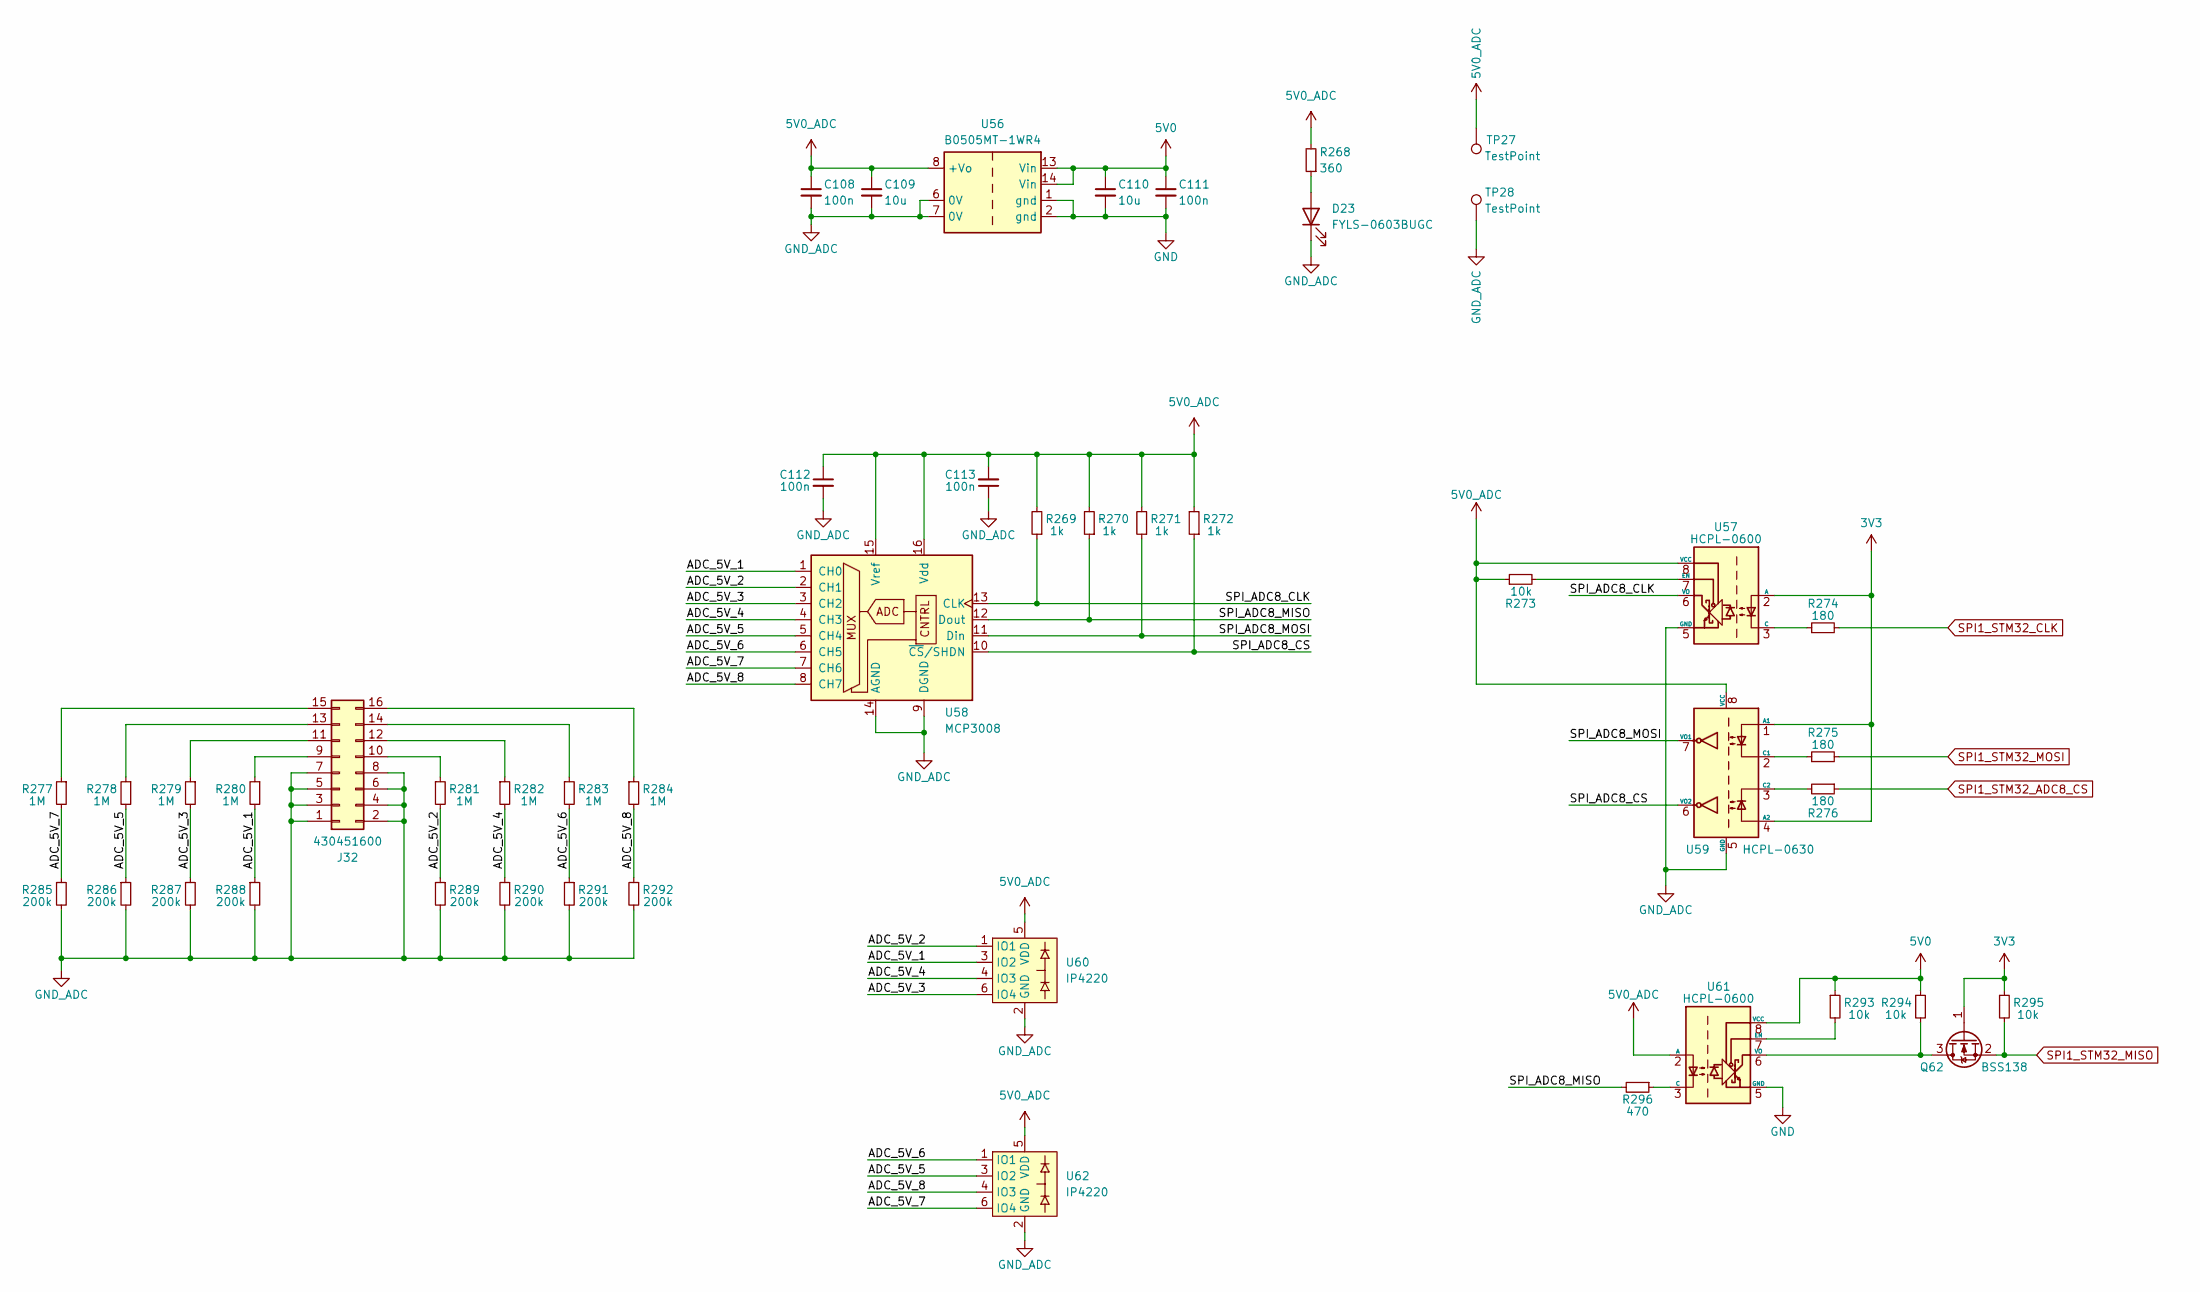
[picture p50: schematic adc.kicad_sch]

Parts:
C108, C111, C112, C113: 100n; C_0603_1608Metric
C109, C110: 10u; C_0603_1608Metric
D23: FYLS-0603BUGC; LED_0603_1608Metric
J32: 430451600
Q62: BSS138; SOT-23
R268: 360; R_0603_1608Metric
R269, R270, R271, R272: 1k; R_0603_1608Metric
R273, R293, R294, R295: 10k; R_0603_1608Metric
R274, R275, R276: 180; R_0603_1608Metric
R277, R278, R279, R280, R281, R282, R283, R284: 1M; R_0603_1608Metric
R285, R286, R287, R288, R289, R290, R291, R292: 200k; R_0603_1608Metric
R296: 470; R_0603_1608Metric
TP27, TP28: TestPoint; TestPoint_THTPad_D2.0mm_Drill1.0mm
U56: B0505MT-1WR4
U57, U61: HCPL-0600; SO-8_3.9x4.9mm_P1.27mm
U58: MCP3008; SOIC-16_3.9x9.9mm_P1.27mm
U59: HCPL-0630; SOIC-8_3.9x4.9mm_P1.27mm
U60, U62: IP4220; SOT-23-6

Connections:
3V3: Q62.1 (G), R295.1, U57.2 (A), U59.1 (A1), U59.4 (A2)
5V0: C110.1, C111.1, R293.1, R294.1, U56.13 (Vin), U56.14 (Vin), U61.8 (VCC)
5V0_ADC: C108.1, C109.1, C112.1, C113.2, R268.2, R269.2, R270.2, R271.2, R272.2, R273.1, TP27.1, U56.8 (+Vo), U57.8 (VCC), U58.15 (Vref), U58.16 (Vdd), U59.8 (VCC), U60.5 (VDD), U61.2 (A), U62.5 (VDD)
ADC_5V_1: R280.2, R288.1, U58.1 (CH0), U60.3 (IO2)
ADC_5V_2: R281.2, R289.1, U58.2 (CH1), U60.1 (IO1)
ADC_5V_3: R279.2, R287.1, U58.3 (CH2), U60.6 (IO4)
ADC_5V_4: R282.2, R290.1, U58.4 (CH3), U60.4 (IO3)
ADC_5V_5: R278.2, R286.1, U58.5 (CH4), U62.3 (IO2)
ADC_5V_6: R283.2, R291.1, U58.6 (CH5), U62.1 (IO1)
ADC_5V_7: R277.2, R285.1, U58.7 (CH6), U62.6 (IO4)
ADC_5V_8: R284.2, R292.1, U58.8 (CH7), U62.4 (IO3)
GND: C110.2, C111.2, U56.1 (gnd), U56.2 (gnd), U61.5 (GND)
GND_ADC: C108.2, C109.2, C112.2, C113.1, D23.1 (K), J32.1, J32.2, J32.3, J32.4, J32.5, J32.6, J32.7, J32.8, R285.2, R286.2, R287.2, R288.2, R289.2, R290.2, R291.2, R292.2, TP28.1, U56.6 (0V), U56.7 (0V), U57.5 (GND), U58.9 (DGND), U58.14 (AGND), U59.5 (GND), U60.2 (GND), U62.2 (GND)
unnamed: D23.2 (A), R268.1
unnamed: J32.9, R280.1
unnamed: J32.10, R281.1
unnamed: J32.11, R279.1
unnamed: J32.12, R282.1
unnamed: J32.13, R278.1
unnamed: J32.14, R283.1
unnamed: J32.15, R277.1
unnamed: J32.16, R284.1
unnamed: Q62.3 (D), R294.2, U61.6 (VO)
unnamed: R273.2, U57.7 (EN)
unnamed: R274.1, U57.3 (C)
unnamed: R275.1, U59.2 (C1)
unnamed: R276.2, U59.3 (C2)
unnamed: R293.2, U61.7 (EN)
unnamed: R296.1, U61.3 (C)
SPI1_STM32_ADC8_CS: R276.1
SPI1_STM32_CLK: R274.2
SPI1_STM32_MISO: Q62.2 (S), R295.2
SPI1_STM32_MOSI: R275.2
SPI_ADC8_CLK: R269.1, U57.6 (VO), U58.13 (CLK)
SPI_ADC8_CS: R272.1, U58.10 (~CS/SHDN), U59.6 (VO2)
SPI_ADC8_MISO: R270.1, R296.2, U58.12 (Dout)
SPI_ADC8_MOSI: R271.1, U58.11 (Din), U59.7 (VO1)
