buglalis/degree/KiCad/Examples/impeller18/adc_rud.kicad_sch

## KiCad design KiCad/Examples/impeller18/adc_rud.kicad_sch (2025-03-23)

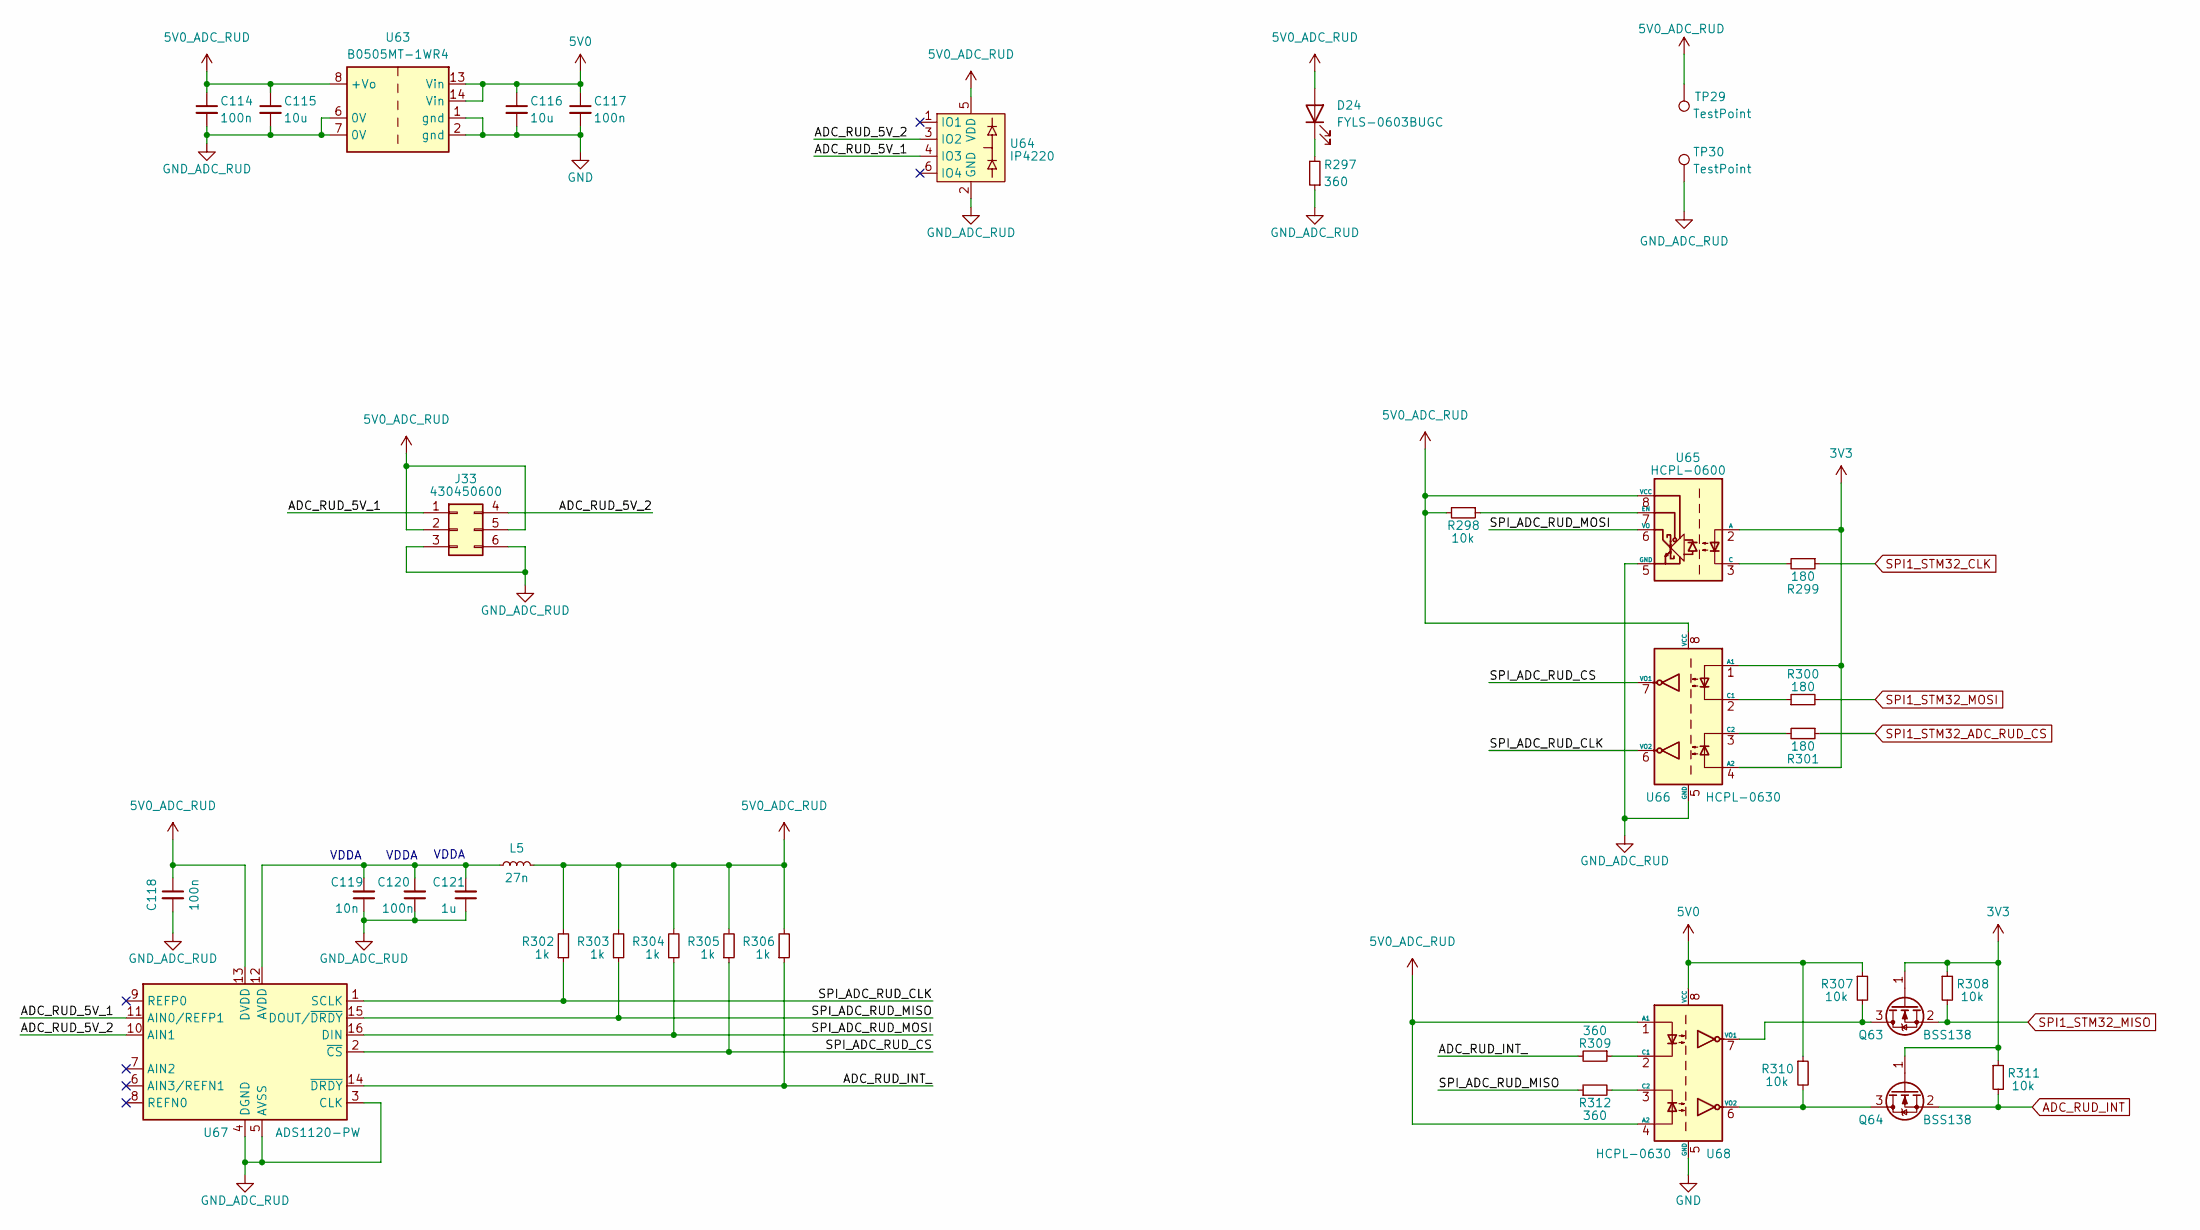
[picture p51: schematic adc_rud.kicad_sch]

Parts:
C114, C117, C118, C120: 100n; C_0603_1608Metric
C115, C116: 10u; C_0603_1608Metric
C119: 10n; C_0603_1608Metric
C121: 1u; C_0603_1608Metric
D24: FYLS-0603BUGC; LED_0603_1608Metric
J33: 430450600
L5: 27n; C_0603_1608Metric
Q63, Q64: BSS138; SOT-23
R297, R309, R312: 360; R_0603_1608Metric
R298, R307, R308, R310, R311: 10k; R_0603_1608Metric
R299, R300, R301: 180; R_0603_1608Metric
R302, R303, R304, R305, R306: 1k; R_0603_1608Metric
TP29, TP30: TestPoint; TestPoint_THTPad_D2.0mm_Drill1.0mm
U63: B0505MT-1WR4
U64: IP4220; SOT-23-6
U65: HCPL-0600; SO-8_3.9x4.9mm_P1.27mm
U66, U68: HCPL-0630; SOIC-8_3.9x4.9mm_P1.27mm
U67: ADS1120-PW; TSSOP-16_4.4x5mm_P0.65mm

Connections:
3V3: Q63.1 (G), Q64.1 (G), R308.1, R311.1, U65.2 (A), U66.1 (A1), U66.4 (A2)
5V0: C116.1, C117.1, R307.1, R310.1, U63.13 (Vin), U63.14 (Vin), U68.8 (VCC)
5V0_ADC_RUD: C114.1, C115.1, C118.1, D24.2 (A), J33.2, J33.5, L5.2, R298.2, R302.2, R303.2, R304.2, R305.2, R306.2, TP29.1, U63.8 (+Vo), U64.5 (VDD), U65.8 (VCC), U66.8 (VCC), U67.13 (DVDD), U68.1 (A1), U68.4 (A2)
ADC_RUD_5V_1: J33.1, U64.4 (IO3), U67.11 (AIN0/REFP1)
ADC_RUD_5V_2: J33.4, U64.3 (IO2), U67.10 (AIN1)
ADC_RUD_INT: Q64.2 (S), R311.2
ADC_RUD_INT_: R306.1, R309.2, U67.14 (~DRDY)
GND: C116.2, C117.2, U63.1 (gnd), U63.2 (gnd), U68.5 (GND)
GND_ADC_RUD: C114.2, C115.2, C118.2, C119.1, C120.1, C121.1, J33.3, J33.6, R297.1, TP30.1, U63.6 (0V), U63.7 (0V), U64.2 (GND), U65.5 (GND), U66.5 (GND), U67.3 (CLK), U67.4 (DGND), U67.5 (AVSS)
unnamed: C119.2, C120.2, C121.2, L5.1, U67.12 (AVDD)
unnamed: D24.1 (K), R297.2
unnamed: Q63.3 (D), R307.2, U68.7 (VO1)
unnamed: Q64.3 (D), R310.2, U68.6 (VO2)
unnamed: R298.1, U65.7 (EN)
unnamed: R299.2, U65.3 (C)
unnamed: R300.1, U66.2 (C1)
unnamed: R301.2, U66.3 (C2)
unnamed: R309.1, U68.2 (C1)
unnamed: R312.2, U68.3 (C2)
SPI1_STM32_ADC_RUD_CS: R301.1
SPI1_STM32_CLK: R299.1
SPI1_STM32_MISO: Q63.2 (S), R308.2
SPI1_STM32_MOSI: R300.2
SPI_ADC_RUD_CLK: R302.1, U66.6 (VO2), U67.1 (SCLK)
SPI_ADC_RUD_CS: R305.1, U66.7 (VO1), U67.2 (~CS)
SPI_ADC_RUD_MISO: R303.1, R312.1, U67.15 (DOUT/~DRDY)
SPI_ADC_RUD_MOSI: R304.1, U65.6 (VO), U67.16 (DIN)

Notes on the sheet:
VDDA
