buglalis/degree/KiCad/Examples/impeller18/can.kicad_sch

## KiCad design KiCad/Examples/impeller18/can.kicad_sch (2025-03-23)

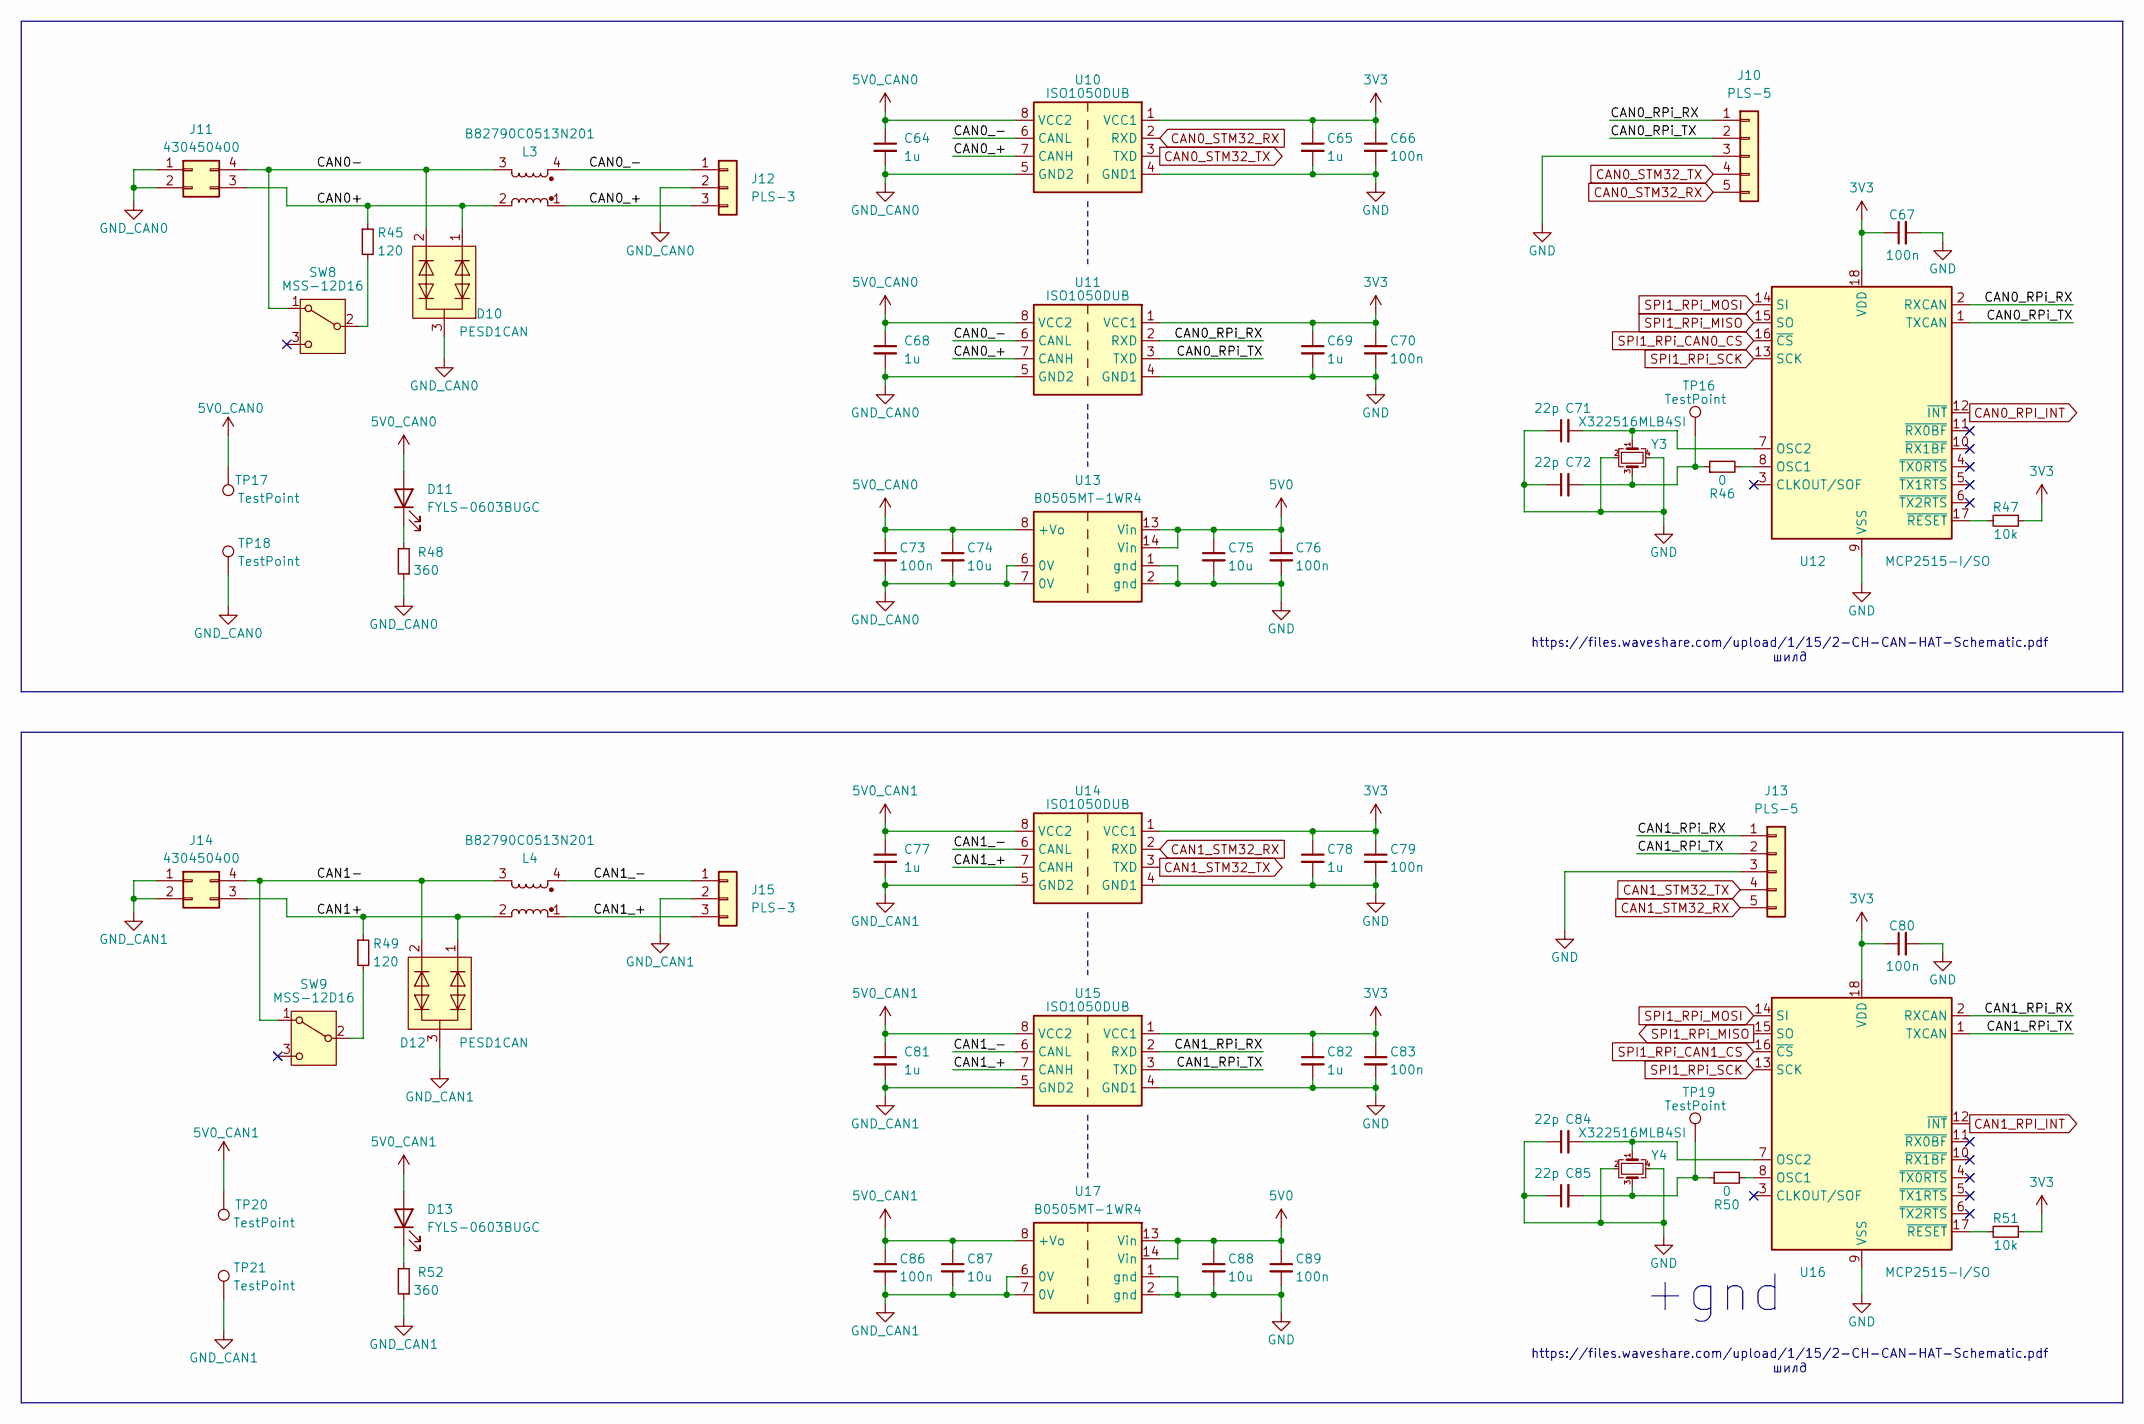
[picture p52: schematic can.kicad_sch]

Parts:
C64, C65, C68, C69, C77, C78, C81, C82: 1u; C_0603_1608Metric
C66, C67, C70, C73, C76, C79, C80, C83, C86, C89: 100n; C_0603_1608Metric
C71, C72, C84, C85: 22p; C_0603_1608Metric
C74, C75, C87, C88: 10u; C_0603_1608Metric
D10, D12: PESD1CAN; SOT-23
D11, D13: FYLS-0603BUGC; LED_0603_1608Metric
J10, J13: PLS-5; PinHeader_1x05_P2.54mm_Vertical
J11, J14: 430450400
J12, J15: PLS-3; PinHeader_1x03_P2.54mm_Vertical
L3, L4: B82790C0513N201
R45, R49: 120; R_0603_1608Metric
R46, R50: 0; R_0603_1608Metric
R47, R51: 10k; R_0603_1608Metric
R48, R52: 360; R_0603_1608Metric
SW8, SW9: MSS-12D16
TP16, TP17, TP18, TP19, TP20, TP21: TestPoint; TestPoint_THTPad_D2.0mm_Drill1.0mm
U10, U11, U14, U15: ISO1050DUB
U12, U16: MCP2515-I/SO; SOIC-18W_7.5x11.6mm_P1.27mm
U13, U17: B0505MT-1WR4
Y3, Y4: X322516MLB4SI; Crystal_SMD_3225-4Pin_3.2x2.5mm

Connections:
3V3: C65.1, C66.1, C67.1, C69.1, C70.1, C78.1, C79.1, C80.1, C82.1, C83.1, R47.1, R51.1, U10.1 (VCC1), U11.1 (VCC1), U12.18 (VDD), U14.1 (VCC1), U15.1 (VCC1), U16.18 (VDD)
5V0: C75.1, C76.1, C88.1, C89.1, U13.13 (Vin), U13.14 (Vin), U17.13 (Vin), U17.14 (Vin)
5V0_CAN0: C64.1, C68.1, C73.1, C74.1, D11.2 (A), TP17.1, U10.8 (VCC2), U11.8 (VCC2), U13.8 (+Vo)
5V0_CAN1: C77.1, C81.1, C86.1, C87.1, D13.2 (A), TP20.1, U14.8 (VCC2), U15.8 (VCC2), U17.8 (+Vo)
CAN0+: D10.1, J11.3, L3.2, R45.1
CAN0-: D10.2, J11.4, L3.3, SW8.1 (A)
CAN0_+: J12.3, L3.1, U10.7 (CANH), U11.7 (CANH)
CAN0_-: J12.1, L3.4, U10.6 (CANL), U11.6 (CANL)
CAN0_RPI_INT: U12.12 (~INT)
CAN0_RPi_RX: J10.1, U11.2 (RXD), U12.2 (RXCAN)
CAN0_RPi_TX: J10.2, U11.3 (TXD), U12.1 (TXCAN)
CAN0_STM32_RX: J10.5, U10.2 (RXD)
CAN0_STM32_TX: J10.4, U10.3 (TXD)
CAN1+: D12.1, J14.3 (Pin_4), L4.2, R49.1
CAN1-: D12.2, J14.4 (Pin_3), L4.3, SW9.1 (A)
CAN1_+: J15.3, L4.1, U14.7 (CANH), U15.7 (CANH)
CAN1_-: J15.1, L4.4, U14.6 (CANL), U15.6 (CANL)
CAN1_RPI_INT: U16.12 (~INT)
CAN1_RPi_RX: J13.1, U15.2 (RXD), U16.2 (RXCAN)
CAN1_RPi_TX: J13.2, U15.3 (TXD), U16.1 (TXCAN)
CAN1_STM32_RX: J13.5, U14.2 (RXD)
CAN1_STM32_TX: J13.4, U14.3 (TXD)
GND: C65.2, C66.2, C67.2, C69.2, C70.2, C71.1, C72.1, C75.2, C76.2, C78.2, C79.2, C80.2, C82.2, C83.2, C84.1, C85.1, C88.2, C89.2, J10.3, J13.3, U10.4 (GND1), U11.4 (GND1), U12.9 (VSS), U13.1 (gnd), U13.2 (gnd), U14.4 (GND1), U15.4 (GND1), U16.9 (VSS), U17.1 (gnd), U17.2 (gnd), Y3.2, Y3.4, Y4.2, Y4.4
GND_CAN0: C64.2, C68.2, C73.2, C74.2, D10.3, J11.1, J11.2, J12.2, R48.1, TP18.1, U10.5 (GND2), U11.5 (GND2), U13.6 (0V), U13.7 (0V)
GND_CAN1: C77.2, C81.2, C86.2, C87.2, D12.3, J14.1, J14.2, J15.2, R52.1, TP21.1, U14.5 (GND2), U15.5 (GND2), U17.6 (0V), U17.7 (0V)
unnamed: C71.2, U12.7 (OSC2), Y3.1
unnamed: C72.2, R46.1, TP16.1, Y3.3
unnamed: C84.2, U16.7 (OSC2), Y4.1
unnamed: C85.2, R50.1, TP19.1, Y4.3
unnamed: D11.1 (K), R48.2
unnamed: D13.1 (K), R52.2
unnamed: R45.2, SW8.2 (B)
unnamed: R46.2, U12.8 (OSC1)
unnamed: R47.2, U12.17 (~RESET)
unnamed: R49.2, SW9.2 (B)
unnamed: R50.2, U16.8 (OSC1)
unnamed: R51.2, U16.17 (~RESET)
SPI1_RPi_CAN0_CS: U12.16 (~CS)
SPI1_RPi_CAN1_CS: U16.16 (~CS)
SPI1_RPi_MISO: U12.15 (SO), U16.15 (SO)
SPI1_RPi_MOSI: U12.14 (SI), U16.14 (SI)
SPI1_RPi_SCK: U12.13 (SCK), U16.13 (SCK)

Notes on the sheet:
https://files.waveshare.com/upload/1/15/2-CH-CAN-HAT-Schematic.pdf шилд
+gnd
