buglalis/degree/KiCad/Examples/impeller18/digital_inputs.kicad_sch

## KiCad design KiCad/Examples/impeller18/digital_inputs.kicad_sch (2025-03-23)

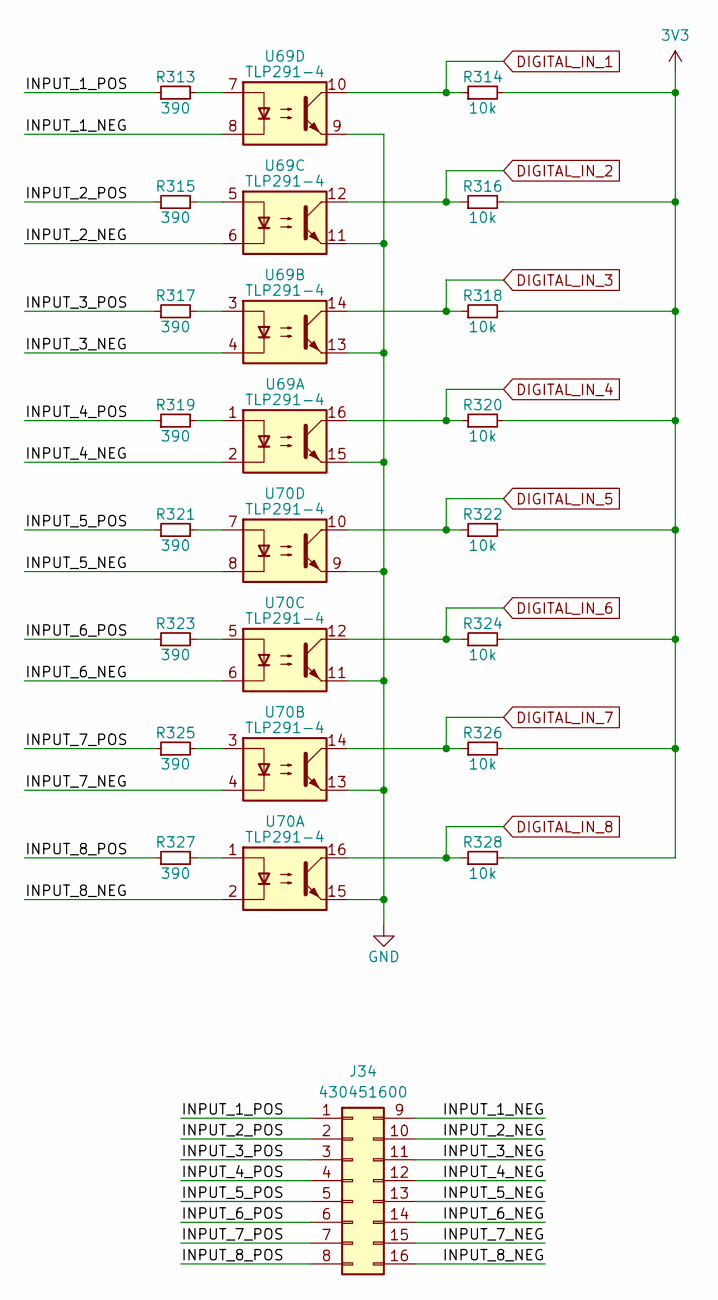
[picture p53: schematic digital_inputs.kicad_sch]

Parts:
J34: 430451600
R313, R315, R317, R319, R321, R323, R325, R327: 390; R_0603_1608Metric
R314, R316, R318, R320, R322, R324, R326, R328: 10k; R_0603_1608Metric
U69, U70: TLP291-4; SOIC-16_4.55x10.3mm_P1.27mm

Connections:
3V3: R314.2, R316.2, R318.2, R320.2, R322.2, R324.2, R326.2, R328.2
DIGITAL_IN_1: R314.1, U69.10
DIGITAL_IN_2: R316.1, U69.12
DIGITAL_IN_3: R318.1, U69.14
DIGITAL_IN_4: R320.1, U69.16
DIGITAL_IN_5: R322.1, U70.10
DIGITAL_IN_6: R324.1, U70.12
DIGITAL_IN_7: R326.1, U70.14
DIGITAL_IN_8: R328.1, U70.16
GND: U69.9, U69.11, U69.13, U69.15, U70.9, U70.11, U70.13, U70.15
INPUT_1_NEG: J34.9, U69.8
INPUT_1_POS: J34.1, R313.1
INPUT_2_NEG: J34.10, U69.6
INPUT_2_POS: J34.2, R315.1
INPUT_3_NEG: J34.11, U69.4
INPUT_3_POS: J34.3, R317.1
INPUT_4_NEG: J34.12, U69.2
INPUT_4_POS: J34.4, R319.1
INPUT_5_NEG: J34.13, U70.8
INPUT_5_POS: J34.5, R321.1
INPUT_6_NEG: J34.14, U70.6
INPUT_6_POS: J34.6, R323.1
INPUT_7_NEG: J34.15, U70.4
INPUT_7_POS: J34.7, R325.1
INPUT_8_NEG: J34.16, U70.2
INPUT_8_POS: J34.8, R327.1
unnamed: R313.2, U69.7
unnamed: R315.2, U69.5
unnamed: R317.2, U69.3
unnamed: R319.2, U69.1
unnamed: R321.2, U70.7
unnamed: R323.2, U70.5
unnamed: R325.2, U70.3
unnamed: R327.2, U70.1
