buglalis/degree/KiCad/Examples/impeller18/fan.kicad_sch

## KiCad design KiCad/Examples/impeller18/fan.kicad_sch (2025-03-23)

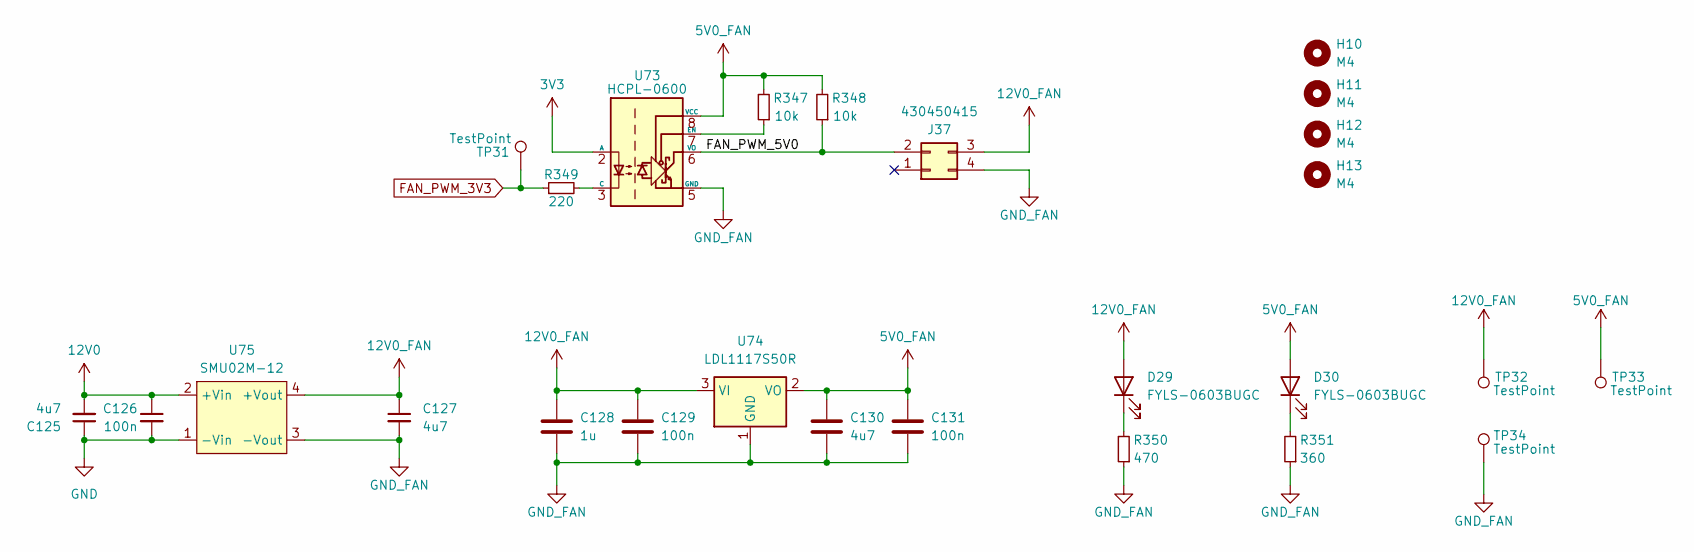
[picture p54: schematic fan.kicad_sch]

Parts:
C125, C127, C130: 4u7; C_0603_1608Metric
C126, C129, C131: 100n; C_0603_1608Metric
C128: 1u; C_0603_1608Metric
D29, D30: FYLS-0603BUGC; LED_0603_1608Metric
H10, H11, H12, H13: M4; MountingHole_M4_PCHSS4-22
J37: 430450415
R347, R348: 10k; R_0603_1608Metric
R349: 220; R_0603_1608Metric
R350: 470; R_0603_1608Metric
R351: 360; R_0603_1608Metric
TP31, TP32, TP33, TP34: TestPoint; TestPoint_THTPad_D2.0mm_Drill1.0mm
U73: HCPL-0600; SO-8_3.9x4.9mm_P1.27mm
U74: LDL1117S50R; SOT-223-3_TabPin2
U75: SMU02M-12

Connections:
3V3: U73.2 (A)
5V0_FAN: C130.1, C131.1, D30.2 (A), R347.2, R348.2, TP33.1, U73.8 (VCC), U74.2 (VO)
12V0: C125.2, C126.1, U75.2 (+Vin)
12V0_FAN: C127.1, C128.1, C129.1, D29.2 (A), J37.3, TP32.1, U74.3 (VI), U75.4 (+Vout)
FAN_PWM_3V3: R349.1, TP31.1
FAN_PWM_5V0: J37.2, R348.1, U73.6 (VO)
GND: C125.1, C126.2, U75.1 (-Vin)
GND_FAN: C127.2, C128.2, C129.2, C130.2, C131.2, J37.4, R350.1, R351.1, TP34.1, U73.5 (GND), U74.1 (GND), U75.3 (-Vout)
unnamed: D29.1 (K), R350.2
unnamed: D30.1 (K), R351.2
unnamed: R347.1, U73.7 (EN)
unnamed: R349.2, U73.3 (C)
