buglalis/degree/KiCad/Examples/impeller18/impeller18.kicad_sch

## KiCad design KiCad/Examples/impeller18/impeller18.kicad_sch (2025-03-23)

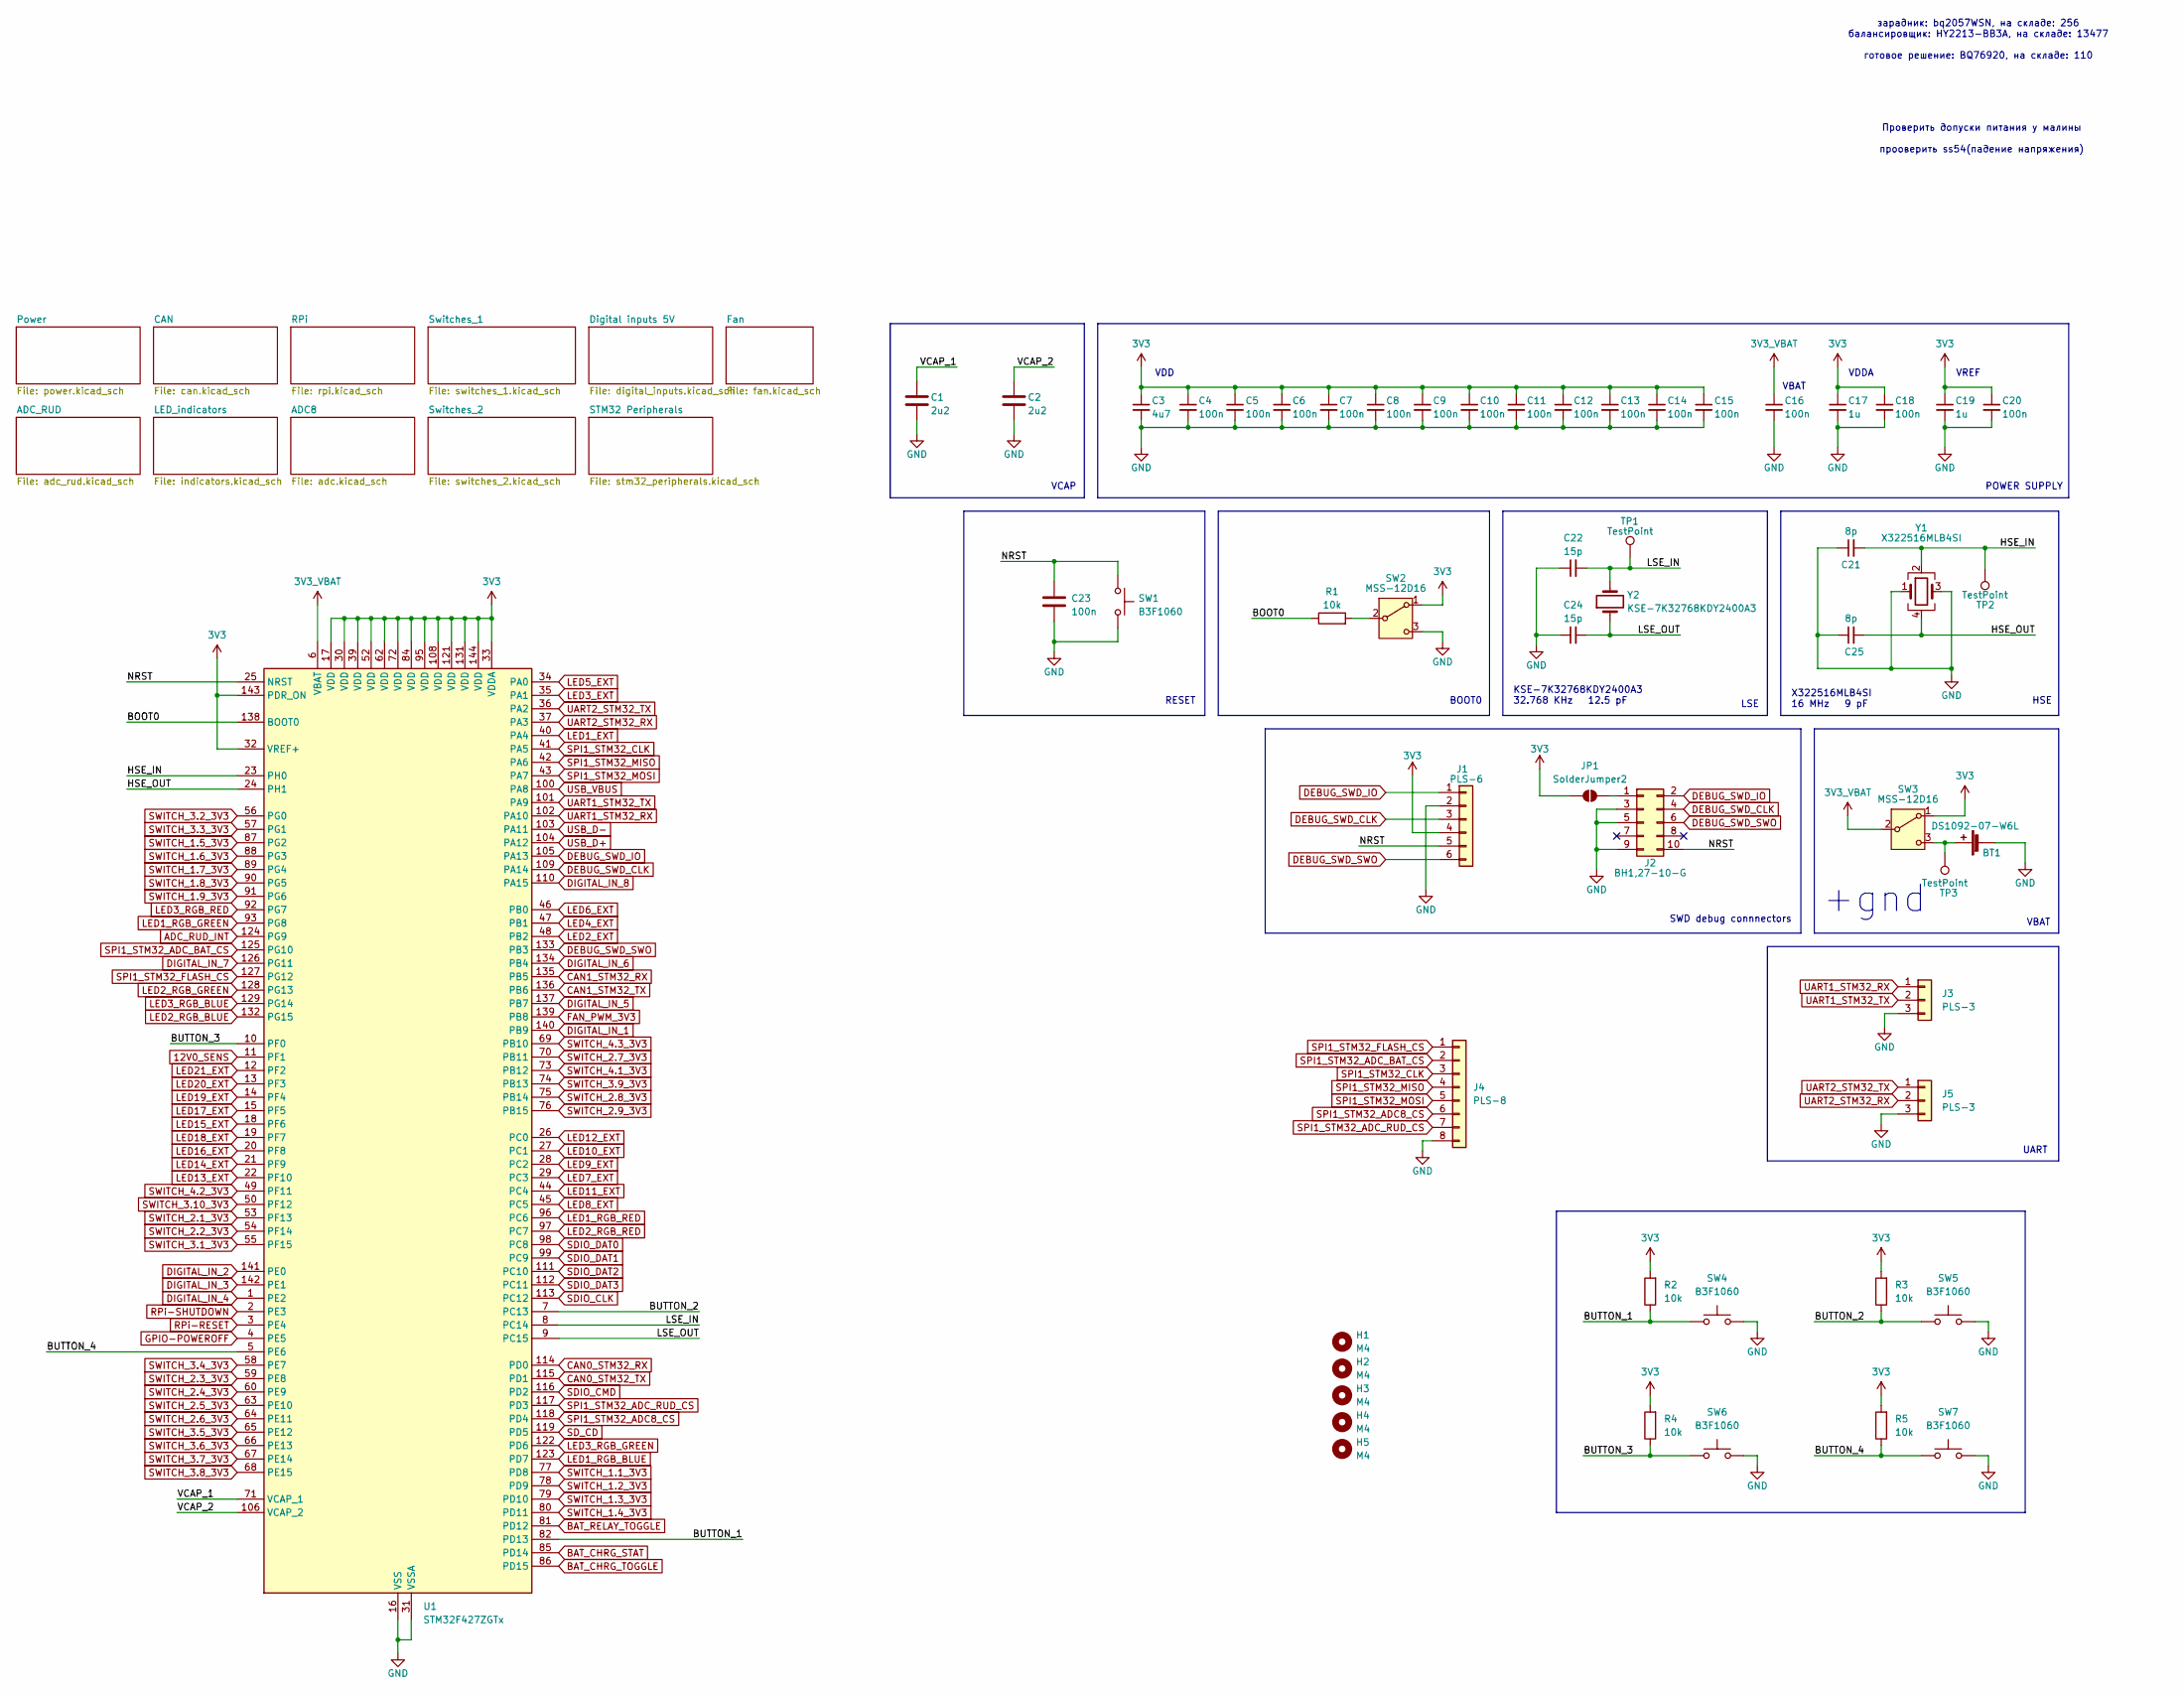
[picture p55: schematic impeller18.kicad_sch]

Parts:
BT1: DS1092-07-W6L
C1, C2: 2u2; C_0603_1608Metric
C3: 4u7; C_0603_1608Metric
C4, C5, C6, C7, C8, C9, C10, C11, C12, C13, C14, C15, C16, C18, C20, C23: 100n; C_0603_1608Metric
C17, C19: 1u; C_0603_1608Metric
C21, C25: 8p; C_0603_1608Metric
C22, C24: 15p; C_0603_1608Metric
H1, H2, H3, H4, H5: M4; MountingHole_M4_protected
J1: PLS-6; PinHeader_1x06_P2.54mm_Vertical
J2: BH1,27-10-G; PinHeader_2x05_P1.27mm_Vertical_mod
J3, J5: PLS-3; PinHeader_1x03_P2.54mm_Vertical
J4: PLS-8; PinHeader_1x08_P2.54mm_Vertical
JP1: SolderJumper2; SolderJumper-2_P1.3mm_Open_RoundedPad1.0x1.5mm
R1, R2, R3, R4, R5: 10k; R_0603_1608Metric
SW1, SW4, SW5, SW6, SW7: B3F1060; SW_PUSH_6mm_H5mm
SW2, SW3: MSS-12D16
TP1, TP2: TestPoint; TestPoint_THTPad_D1.5mm_Drill0.7mm
TP3: TestPoint; TestPoint_THTPad_D2.0mm_Drill1.0mm
U1: STM32F427ZGTx; LQFP-144_20x20mm_P0.5mm
Y1: X322516MLB4SI; Crystal_SMD_3225-4Pin_3.2x2.5mm
Y2: KSE-7K32768KDY2400A3

Connections:
3V3: C3.1, C4.1, C5.1, C6.1, C7.1, C8.1, C9.1, C10.1, C11.1, C12.1, C13.1, C14.1, C15.1, C17.1, C18.1, C19.1, C20.1, J1.4, JP1.1 (A), R2.2, R3.2, R4.2, R5.2, SW2.1 (A), SW3.1 (A), U1.17 (VDD), U1.30 (VDD), U1.32 (VREF+), U1.33 (VDDA), U1.39 (VDD), U1.52 (VDD), U1.62 (VDD), U1.72 (VDD), U1.84 (VDD), U1.95 (VDD), U1.108 (VDD), U1.121 (VDD), U1.131 (VDD), U1.143 (PDR_ON), U1.144 (VDD)
3V3_VBAT: C16.1, SW3.2 (B), U1.6 (VBAT)
12V0_SENS: U1.11 (PF1)
ADC_RUD_INT: U1.124 (PG9)
BAT_CHRG_STAT: U1.85 (PD14)
BAT_CHRG_TOGGLE: U1.86 (PD15)
BAT_RELAY_TOGGLE: U1.81 (PD12)
BOOT0: R1.1, U1.138 (BOOT0)
BUTTON_1: R2.1, SW4.1, U1.82 (PD13)
BUTTON_2: R3.1, SW5.1, U1.7 (PC13)
BUTTON_3: R4.1, SW6.1, U1.10 (PF0)
BUTTON_4: R5.1, SW7.1, U1.5 (PE6)
CAN0_STM32_RX: U1.114 (PD0)
CAN0_STM32_TX: U1.115 (PD1)
CAN1_STM32_RX: U1.135 (PB5)
CAN1_STM32_TX: U1.136 (PB6)
DEBUG_SWD_CLK: J1.3, J2.4, U1.109 (PA14)
DEBUG_SWD_IO: J1.1, J2.2, U1.105 (PA13)
DEBUG_SWD_SWO: J1.6, J2.6, U1.133 (PB3)
DIGITAL_IN_1: U1.140 (PB9)
DIGITAL_IN_2: U1.141 (PE0)
DIGITAL_IN_3: U1.142 (PE1)
DIGITAL_IN_4: U1.1 (PE2)
DIGITAL_IN_5: U1.137 (PB7)
DIGITAL_IN_6: U1.134 (PB4)
DIGITAL_IN_7: U1.126 (PG11)
DIGITAL_IN_8: U1.110 (PA15)
FAN_PWM_3V3: U1.139 (PB8)
GND: BT1.2 (-), C1.2, C2.2, C3.2, C4.2, C5.2, C6.2, C7.2, C8.2, C9.2, C10.2, C11.2, C12.2, C13.2, C14.2, C15.2, C16.2, C17.2, C18.2, C19.2, C20.2, C21.1, C22.1, C23.2, C24.1, C25.1, J1.2, J2.3, J2.5, J2.9, J3.3, J4.8, J5.3, SW1.2, SW2.3 (C), SW4.2, SW5.2, SW6.2, SW7.2, U1.16 (VSS), U1.31 (VSSA), U1.38 (VSS), U1.51 (VSS), U1.61 (VSS), U1.83 (VSS), U1.94 (VSS), U1.107 (VSS), U1.120 (VSS), U1.130 (VSS), Y1.1, Y1.3
GPIO-POWEROFF: U1.4 (PE5)
HSE_IN: C21.2, TP2.1, U1.23 (PH0), Y1.2
HSE_OUT: C25.2, U1.24 (PH1), Y1.4
LED1_EXT: U1.40 (PA4)
LED1_RGB_BLUE: U1.123 (PD7)
LED1_RGB_GREEN: U1.93 (PG8)
LED1_RGB_RED: U1.96 (PC6)
LED2_EXT: U1.48 (PB2)
LED2_RGB_BLUE: U1.132 (PG15)
LED2_RGB_GREEN: U1.128 (PG13)
LED2_RGB_RED: U1.97 (PC7)
LED3_EXT: U1.35 (PA1)
LED3_RGB_BLUE: U1.129 (PG14)
LED3_RGB_GREEN: U1.122 (PD6)
LED3_RGB_RED: U1.92 (PG7)
LED4_EXT: U1.47 (PB1)
LED5_EXT: U1.34 (PA0)
LED6_EXT: U1.46 (PB0)
LED7_EXT: U1.29 (PC3)
LED8_EXT: U1.45 (PC5)
LED9_EXT: U1.28 (PC2)
LED10_EXT: U1.27 (PC1)
LED11_EXT: U1.44 (PC4)
LED12_EXT: U1.26 (PC0)
LED13_EXT: U1.22 (PF10)
LED14_EXT: U1.21 (PF9)
LED15_EXT: U1.18 (PF6)
LED16_EXT: U1.20 (PF8)
LED17_EXT: U1.15 (PF5)
LED18_EXT: U1.19 (PF7)
LED19_EXT: U1.14 (PF4)
LED20_EXT: U1.13 (PF3)
LED21_EXT: U1.12 (PF2)
LSE_IN: C22.2, TP1.1, U1.8 (PC14), Y2.2
LSE_OUT: C24.2, U1.9 (PC15), Y2.1
NRST: C23.1, J1.5, J2.10, SW1.1, U1.25 (NRST)
unnamed: BT1.1 (+), SW3.3 (C), TP3.1
unnamed: J2.1, JP1.2 (B)
unnamed: R1.2, SW2.2 (B)
RPi-RESET: U1.3 (PE4)
RPi-SHUTDOWN: U1.2 (PE3)
SDIO_CLK: U1.113 (PC12)
SDIO_CMD: U1.116 (PD2)
SDIO_DAT0: U1.98 (PC8)
SDIO_DAT1: U1.99 (PC9)
SDIO_DAT2: U1.111 (PC10)
SDIO_DAT3: U1.112 (PC11)
SD_CD: U1.119 (PD5)
SPI1_STM32_ADC8_CS: J4.6, U1.118 (PD4)
SPI1_STM32_ADC_BAT_CS: J4.2, U1.125 (PG10)
SPI1_STM32_ADC_RUD_CS: J4.7, U1.117 (PD3)
SPI1_STM32_CLK: J4.3, U1.41 (PA5)
SPI1_STM32_FLASH_CS: J4.1, U1.127 (PG12)
SPI1_STM32_MISO: J4.4, U1.42 (PA6)
SPI1_STM32_MOSI: J4.5, U1.43 (PA7)
SWITCH_1.1_3V3: U1.77 (PD8)
SWITCH_1.2_3V3: U1.78 (PD9)
SWITCH_1.3_3V3: U1.79 (PD10)
SWITCH_1.4_3V3: U1.80 (PD11)
SWITCH_1.5_3V3: U1.87 (PG2)
SWITCH_1.6_3V3: U1.88 (PG3)
SWITCH_1.7_3V3: U1.89 (PG4)
SWITCH_1.8_3V3: U1.90 (PG5)
SWITCH_1.9_3V3: U1.91 (PG6)
SWITCH_2.1_3V3: U1.53 (PF13)
SWITCH_2.2_3V3: U1.54 (PF14)
SWITCH_2.3_3V3: U1.59 (PE8)
SWITCH_2.4_3V3: U1.60 (PE9)
SWITCH_2.5_3V3: U1.63 (PE10)
SWITCH_2.6_3V3: U1.64 (PE11)
SWITCH_2.7_3V3: U1.70 (PB11)
SWITCH_2.8_3V3: U1.75 (PB14)
SWITCH_2.9_3V3: U1.76 (PB15)
SWITCH_3.1_3V3: U1.55 (PF15)
SWITCH_3.2_3V3: U1.56 (PG0)
SWITCH_3.3_3V3: U1.57 (PG1)
SWITCH_3.4_3V3: U1.58 (PE7)
SWITCH_3.5_3V3: U1.65 (PE12)
SWITCH_3.6_3V3: U1.66 (PE13)
SWITCH_3.7_3V3: U1.67 (PE14)
SWITCH_3.8_3V3: U1.68 (PE15)
SWITCH_3.9_3V3: U1.74 (PB13)
SWITCH_3.10_3V3: U1.50 (PF12)
SWITCH_4.1_3V3: U1.73 (PB12)
SWITCH_4.2_3V3: U1.49 (PF11)
SWITCH_4.3_3V3: U1.69 (PB10)
UART1_STM32_RX: J3.1, U1.102 (PA10)
UART1_STM32_TX: J3.2, U1.101 (PA9)
UART2_STM32_RX: J5.2, U1.37 (PA3)
UART2_STM32_TX: J5.1, U1.36 (PA2)
USB_D+: U1.104 (PA12)
USB_D-: U1.103 (PA11)
USB_VBUS: U1.100 (PA8)
VCAP_1: C1.1, U1.71 (VCAP_1)
VCAP_2: C2.1, U1.106 (VCAP_2)

Notes on the sheet:
SWD debug connnectors
Проверить допуски питания у малины прооверить ss54(падение напряжения)
RESET
VDDA
UART
HSE
VBAT
KSE-7K32768KDY2400A3 32.768 KHz 12.5 pF
VREF
BOOT0
зарадник: bq2057WSN, на складе: 256 балансировщик: HY2213-BB3A, на складе: 13477 готовое решение: BQ76920, на складе: 110
POWER SUPPLY
VDD
X322516MLB4SI 16 MHz 9 pF
+gnd
LSE
VCAP
