buglalis/degree/KiCad/Examples/impeller18/indicators.kicad_sch

## KiCad design KiCad/Examples/impeller18/indicators.kicad_sch (2025-03-23)

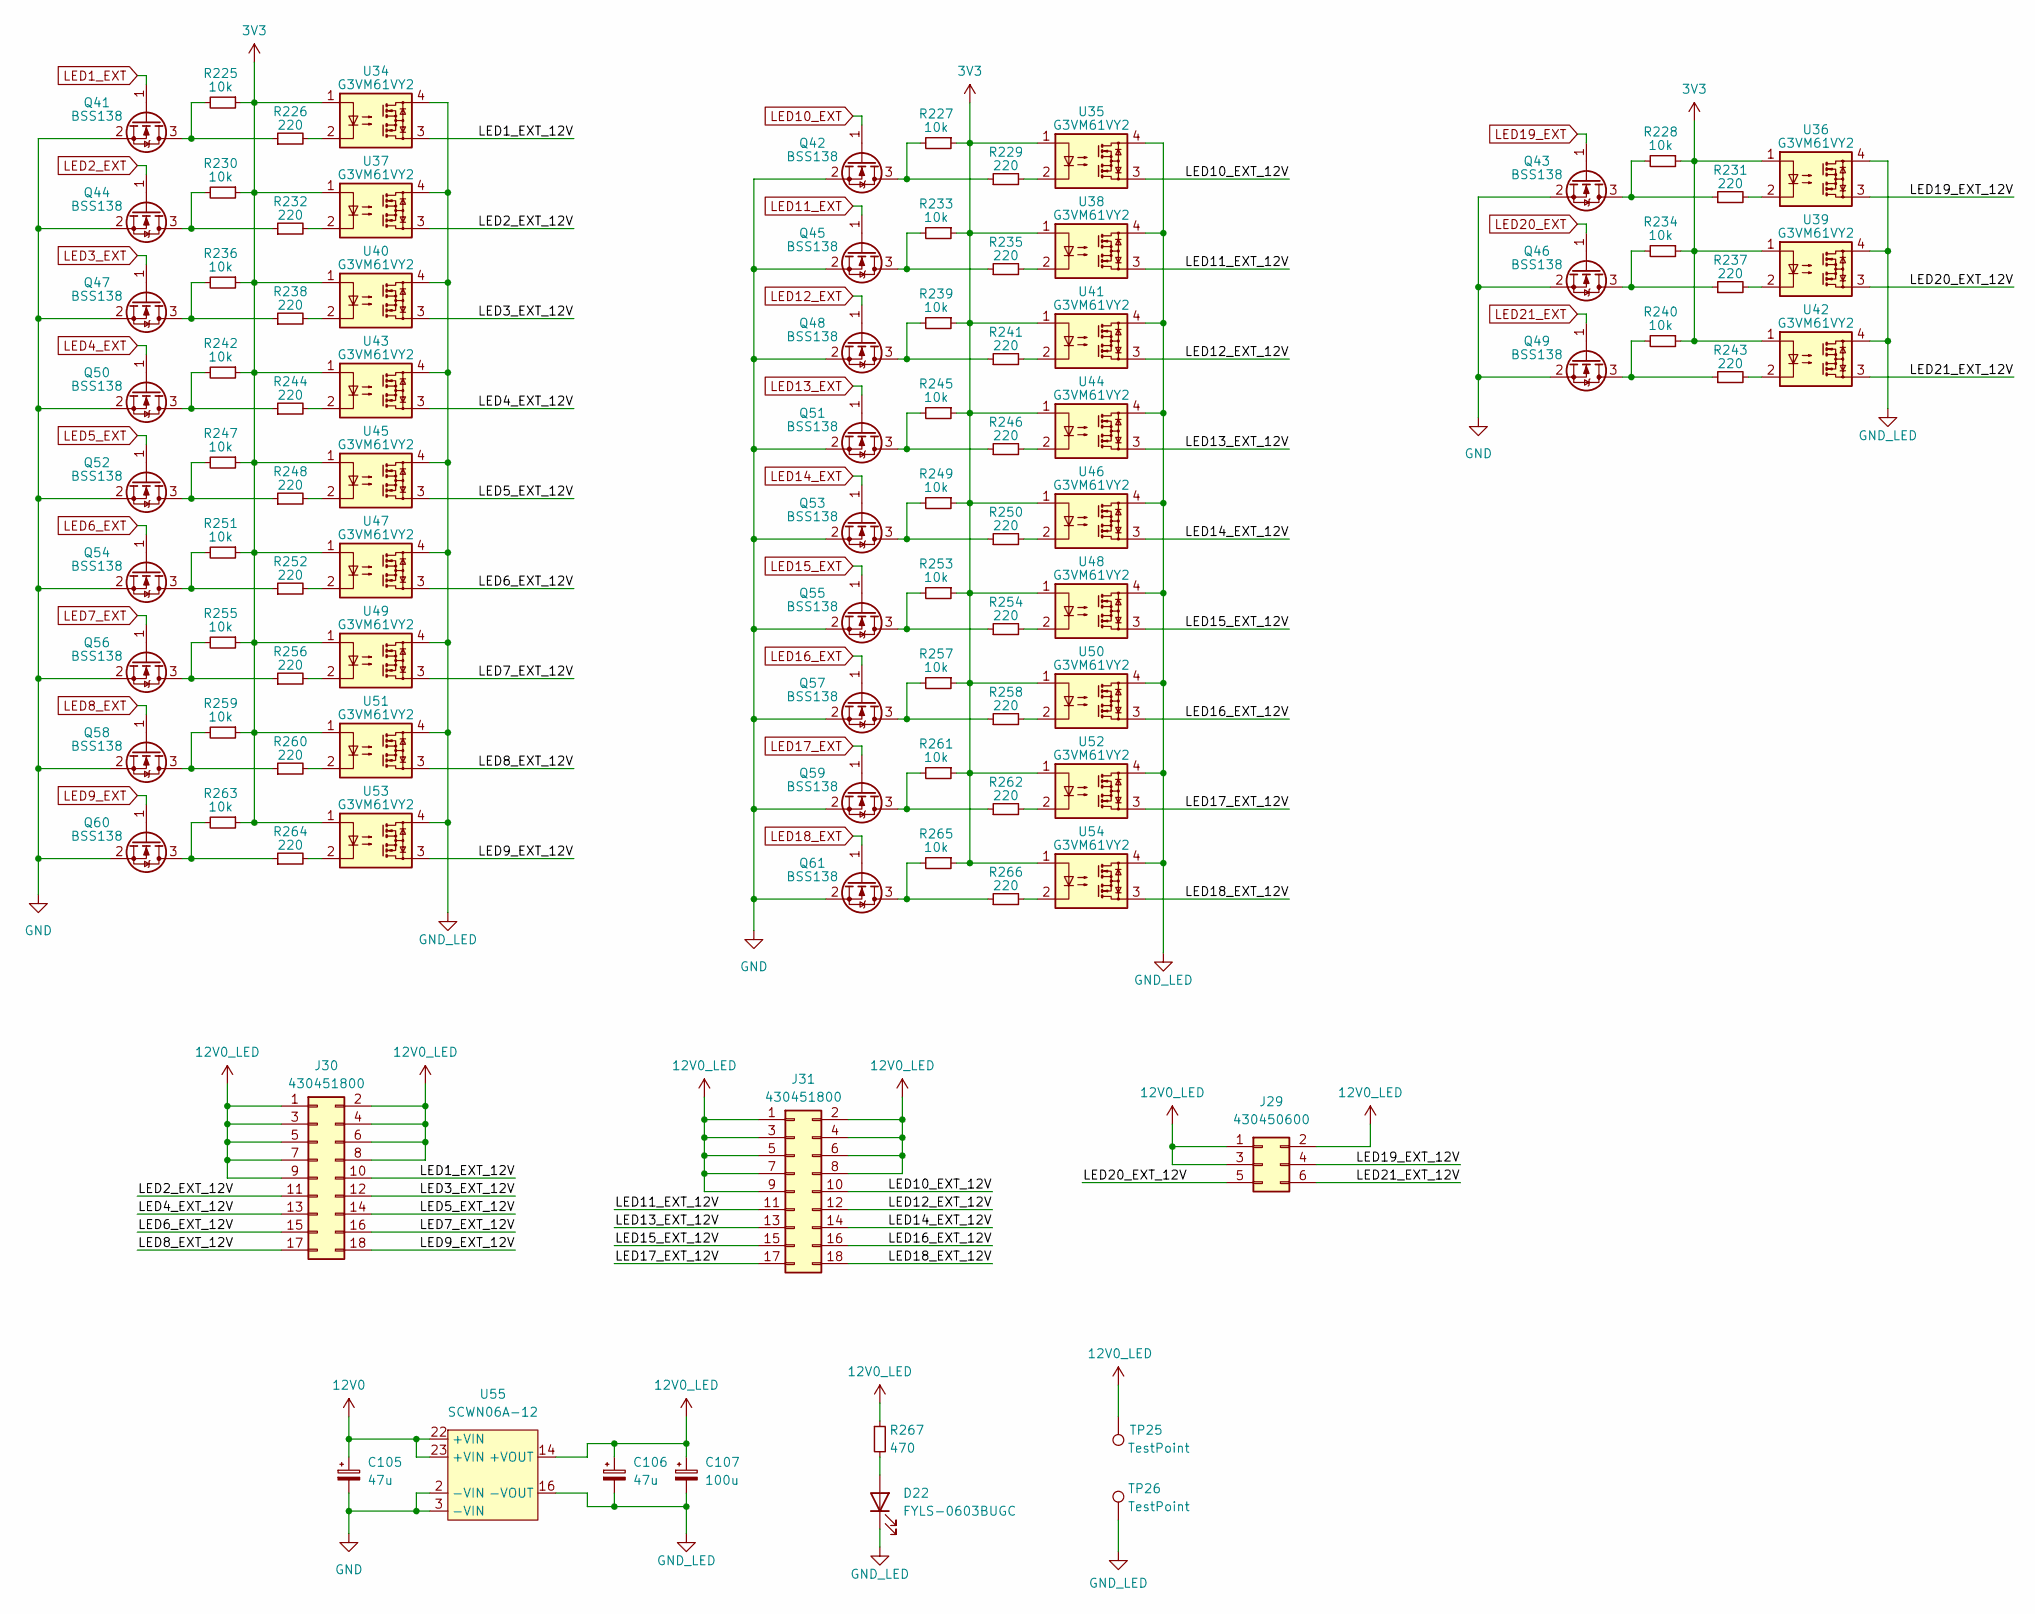
[picture p56: schematic indicators.kicad_sch]

Parts:
C105, C106: 47u; CP_Radial_D10.0mm_P5.00mm
C107: 100u; CP_Radial_D8.0mm_P3.50mm
D22: FYLS-0603BUGC; LED_0603_1608Metric
J29: 430450600
J30, J31: 430451800
Q41, Q42, Q43, Q44, Q45, Q46, Q47, Q48, Q49, Q50, Q51, Q52, Q53, Q54, Q55, Q56, Q57, Q58, Q59, Q60, Q61: BSS138; SOT-23
R225, R227, R228, R230, R233, R234, R236, R239, R240, R242, R245, R247, R249, R251, R253, R255, R257, R259, R261, R263, R265: 10k; R_0603_1608Metric
R226, R229, R231, R232, R235, R237, R238, R241, R243, R244, R246, R248, R250, R252, R254, R256, R258, R260, R262, R264, R266: 220; R_0603_1608Metric
R267: 470; R_0603_1608Metric
TP25, TP26: TestPoint; TestPoint_THTPad_D2.0mm_Drill1.0mm
U34, U35, U36, U37, U38, U39, U40, U41, U42, U43, U44, U45, U46, U47, U48, U49, U50, U51, U52, U53, U54: G3VM61VY2; G3VM-61VY2TR
U55: SCWN06A-12

Connections:
3V3: R225.1, R227.1, R228.1, R230.1, R233.1, R234.1, R236.1, R239.1, R240.1, R242.1, R245.1, R247.1, R249.1, R251.1, R253.1, R255.1, R257.1, R259.1, R261.1, R263.1, R265.1, U34.1, U35.1, U36.1, U37.1, U38.1, U39.1, U40.1, U41.1, U42.1, U43.1, U44.1, U45.1, U46.1, U47.1, U48.1, U49.1, U50.1, U51.1, U52.1, U53.1, U54.1
12V0: C105.1, U55.22 (+VIN), U55.23 (+VIN)
12V0_LED: C106.1, C107.1, J29.1, J29.2, J29.3, J30.1, J30.2, J30.3, J30.4, J30.5, J30.6, J30.7, J30.8, J30.9, J31.1, J31.2, J31.3, J31.4, J31.5, J31.6, J31.7, J31.8, J31.9, R267.1, TP25.1, U55.14 (+VOUT)
GND: C105.2, Q41.2 (S), Q42.2 (S), Q43.2 (S), Q44.2 (S), Q45.2 (S), Q46.2 (S), Q47.2 (S), Q48.2 (S), Q49.2 (S), Q50.2 (S), Q51.2 (S), Q52.2 (S), Q53.2 (S), Q54.2 (S), Q55.2 (S), Q56.2 (S), Q57.2 (S), Q58.2 (S), Q59.2 (S), Q60.2 (S), Q61.2 (S), U55.2 (-VIN), U55.3 (-VIN)
GND_LED: C106.2, C107.2, D22.1 (K), TP26.1, U34.4, U35.4, U36.4, U37.4, U38.4, U39.4, U40.4, U41.4, U42.4, U43.4, U44.4, U45.4, U46.4, U47.4, U48.4, U49.4, U50.4, U51.4, U52.4, U53.4, U54.4, U55.16 (-VOUT)
LED1_EXT: Q41.1 (G)
LED1_EXT_12V: J30.10, U34.3
LED2_EXT: Q44.1 (G)
LED2_EXT_12V: J30.11, U37.3
LED3_EXT: Q47.1 (G)
LED3_EXT_12V: J30.12, U40.3
LED4_EXT: Q50.1 (G)
LED4_EXT_12V: J30.13, U43.3
LED5_EXT: Q52.1 (G)
LED5_EXT_12V: J30.14, U45.3
LED6_EXT: Q54.1 (G)
LED6_EXT_12V: J30.15, U47.3
LED7_EXT: Q56.1 (G)
LED7_EXT_12V: J30.16, U49.3
LED8_EXT: Q58.1 (G)
LED8_EXT_12V: J30.17, U51.3
LED9_EXT: Q60.1 (G)
LED9_EXT_12V: J30.18, U53.3
LED10_EXT: Q42.1 (G)
LED10_EXT_12V: J31.10, U35.3
LED11_EXT: Q45.1 (G)
LED11_EXT_12V: J31.11, U38.3
LED12_EXT: Q48.1 (G)
LED12_EXT_12V: J31.12, U41.3
LED13_EXT: Q51.1 (G)
LED13_EXT_12V: J31.13, U44.3
LED14_EXT: Q53.1 (G)
LED14_EXT_12V: J31.14, U46.3
LED15_EXT: Q55.1 (G)
LED15_EXT_12V: J31.15, U48.3
LED16_EXT: Q57.1 (G)
LED16_EXT_12V: J31.16, U50.3
LED17_EXT: Q59.1 (G)
LED17_EXT_12V: J31.17, U52.3
LED18_EXT: Q61.1 (G)
LED18_EXT_12V: J31.18, U54.3
LED19_EXT: Q43.1 (G)
LED19_EXT_12V: J29.4, U36.3
LED20_EXT: Q46.1 (G)
LED20_EXT_12V: J29.5, U39.3
LED21_EXT: Q49.1 (G)
LED21_EXT_12V: J29.6, U42.3
unnamed: D22.2 (A), R267.2
unnamed: Q41.3 (D), R225.2, R226.1
unnamed: Q42.3 (D), R227.2, R229.1
unnamed: Q43.3 (D), R228.2, R231.1
unnamed: Q44.3 (D), R230.2, R232.1
unnamed: Q45.3 (D), R233.2, R235.1
unnamed: Q46.3 (D), R234.2, R237.1
unnamed: Q47.3 (D), R236.2, R238.1
unnamed: Q48.3 (D), R239.2, R241.1
unnamed: Q49.3 (D), R240.2, R243.1
unnamed: Q50.3 (D), R242.2, R244.1
unnamed: Q51.3 (D), R245.2, R246.1
unnamed: Q52.3 (D), R247.2, R248.1
unnamed: Q53.3 (D), R249.2, R250.1
unnamed: Q54.3 (D), R251.2, R252.1
unnamed: Q55.3 (D), R253.2, R254.1
unnamed: Q56.3 (D), R255.2, R256.1
unnamed: Q57.3 (D), R257.2, R258.1
unnamed: Q58.3 (D), R259.2, R260.1
unnamed: Q59.3 (D), R261.2, R262.1
unnamed: Q60.3 (D), R263.2, R264.1
unnamed: Q61.3 (D), R265.2, R266.1
unnamed: R226.2, U34.2
unnamed: R229.2, U35.2
unnamed: R231.2, U36.2
unnamed: R232.2, U37.2
unnamed: R235.2, U38.2
unnamed: R237.2, U39.2
unnamed: R238.2, U40.2
unnamed: R241.2, U41.2
unnamed: R243.2, U42.2
unnamed: R244.2, U43.2
unnamed: R246.2, U44.2
unnamed: R248.2, U45.2
unnamed: R250.2, U46.2
unnamed: R252.2, U47.2
unnamed: R254.2, U48.2
unnamed: R256.2, U49.2
unnamed: R258.2, U50.2
unnamed: R260.2, U51.2
unnamed: R262.2, U52.2
unnamed: R264.2, U53.2
unnamed: R266.2, U54.2
