buglalis/degree/KiCad/Examples/impeller18/power.kicad_sch

## KiCad design KiCad/Examples/impeller18/power.kicad_sch (2025-03-23)

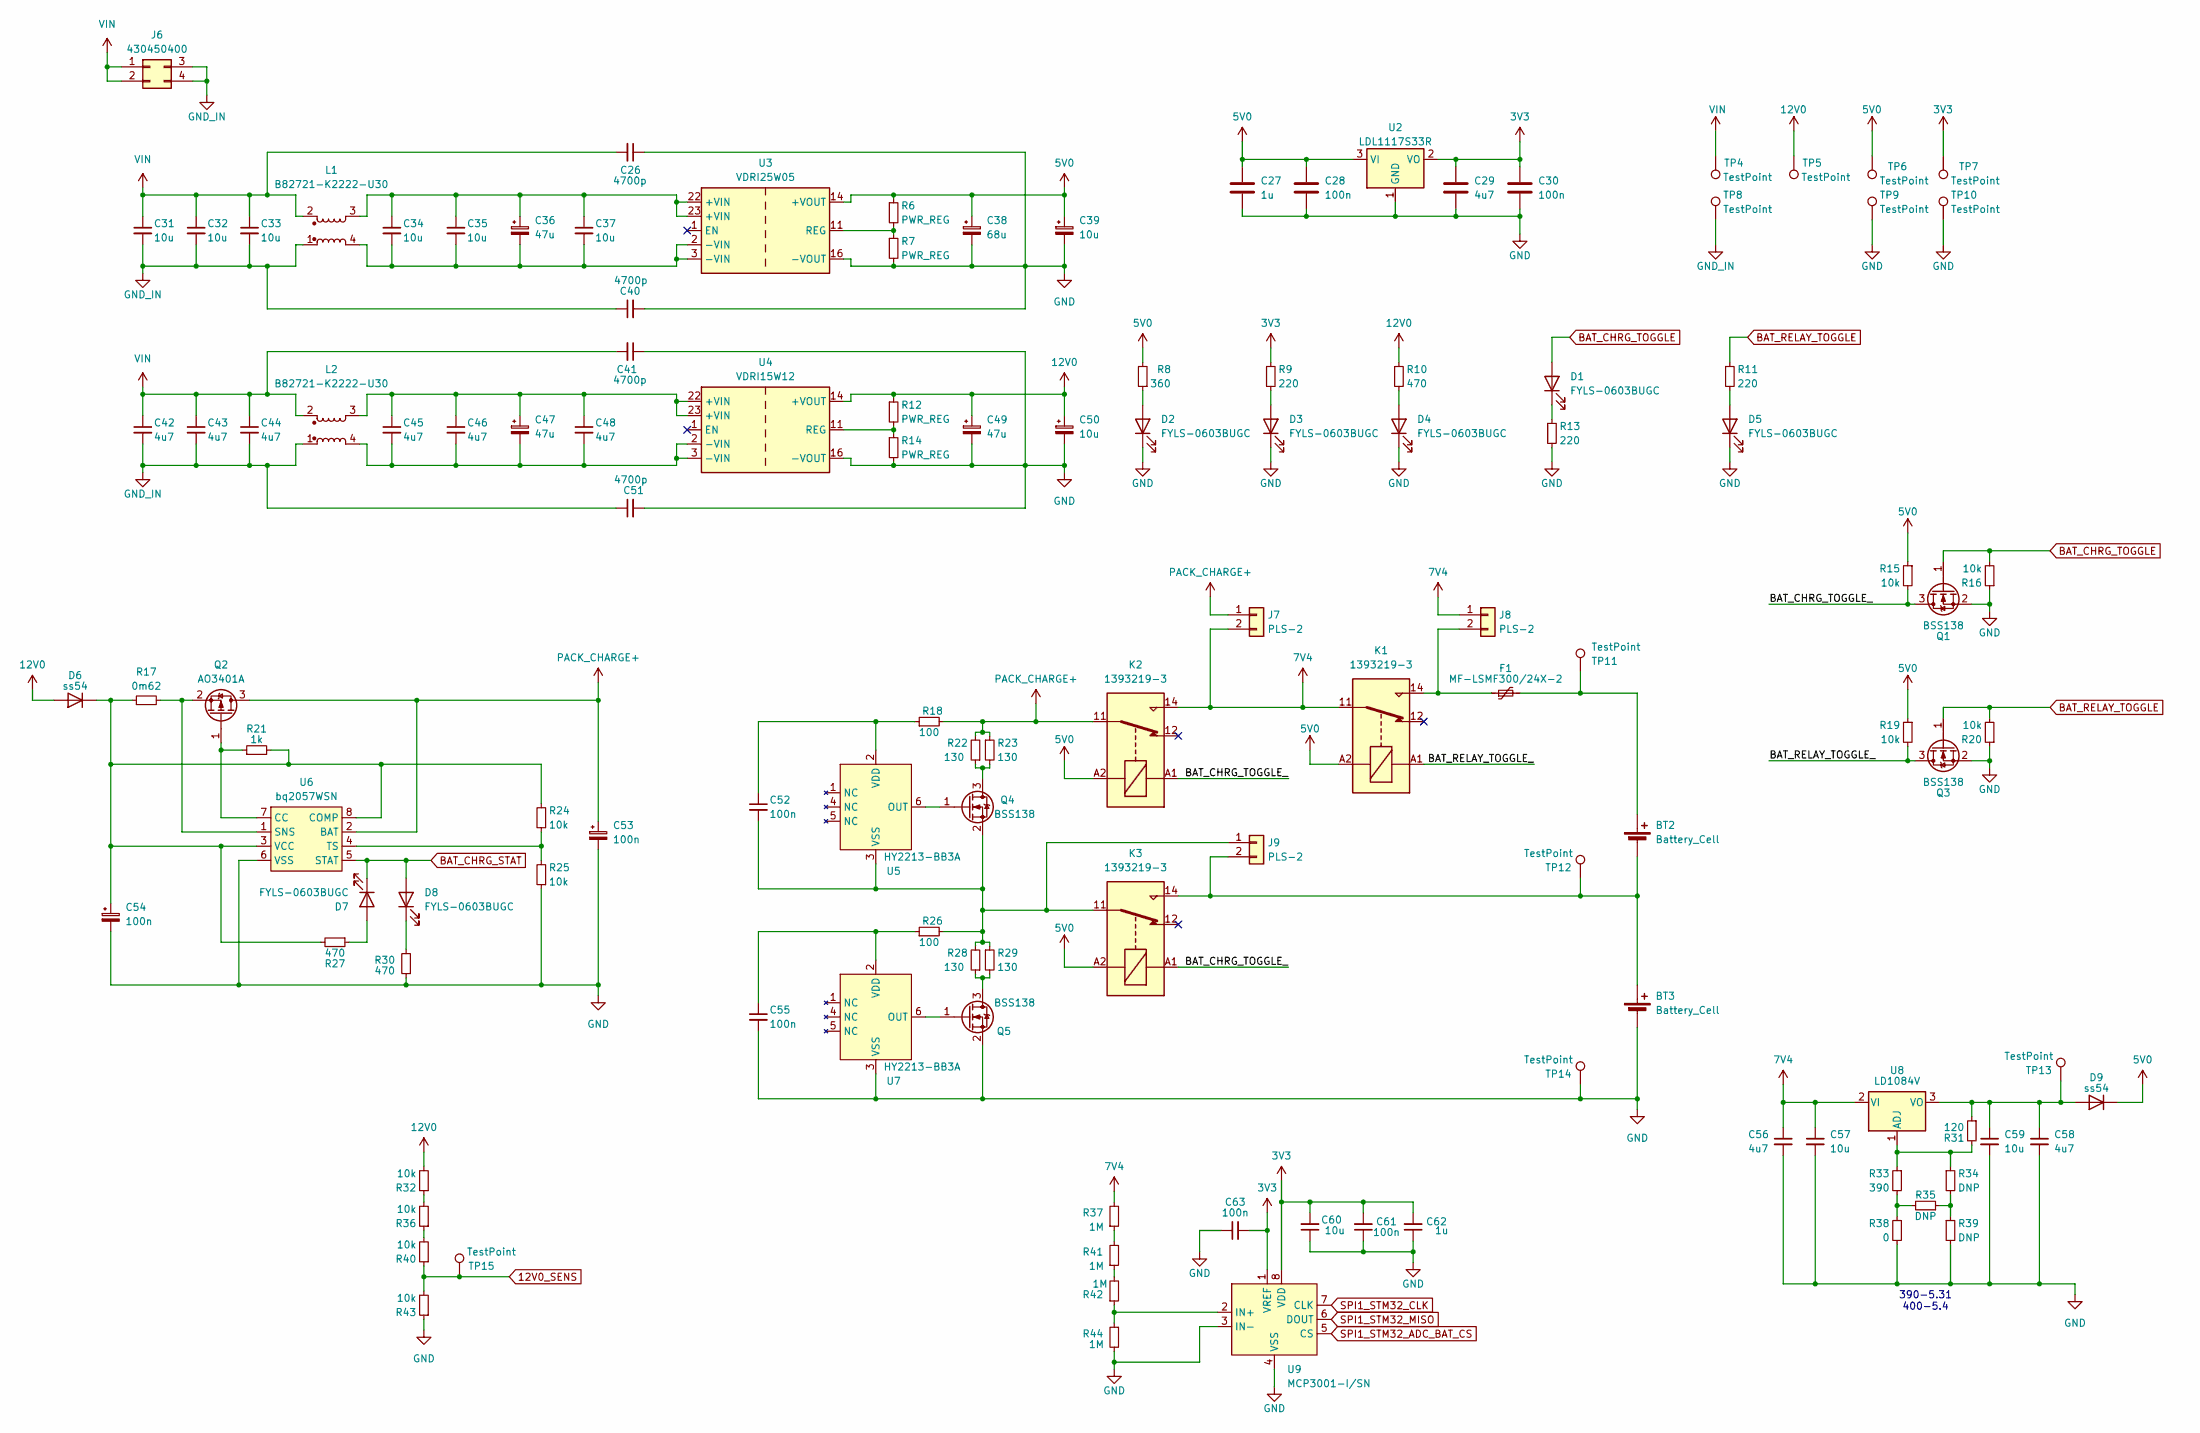
[picture p57: schematic power.kicad_sch]

Parts:
BT2, BT3: Battery_Cell; bat_18350
C26, C40, C41, C51: 4700p; C_1206_3216Metric
C27, C62: 1u; C_0603_1608Metric
C28, C30, C52, C53, C54, C55, C61, C63: 100n; C_0603_1608Metric
C29, C56, C59: 4u7; C_0603_1608Metric
C31, C32, C33, C34, C35, C37: 10u; C_1210_3225Metric
C36, C47, C49: 47u; CP_Radial_D10.0mm_P5.00mm
C38: 68u; CP_Radial_D10.0mm_P5.00mm
C39, C50: 10u; CP_Radial_D10.0mm_P5.00mm
C42, C43, C44, C45, C46, C48: 4u7; C_1210_3225Metric
C57, C58, C60: 10u; C_0603_1608Metric
D1, D2, D3, D4, D5, D7, D8: FYLS-0603BUGC; LED_0603_1608Metric
D6, D9: ss54; D_SMC
F1: MF-LSMF300/24X-2; Fuse_2920_7451Metric
J6: 430450400
J7, J8, J9: PLS-2; PinHeader_1x02_P2.54mm_Vertical
K1, K2, K3: 1393219-3
L1, L2: B82721-K2222-U30
Q1, Q3, Q4, Q5: BSS138; SOT-23
Q2: AO3401A; SOT-23
R6, R7, R12, R14: PWR_REG; R_0603_1608Metric
R8: 360; R_0603_1608Metric
R9, R11, R13: 220; R_0603_1608Metric
R10, R27, R30: 470; R_0603_1608Metric
R15, R16, R19, R20, R24, R25, R32, R36, R40, R43: 10k; R_0603_1608Metric
R17: 0m62; R_2512_6332Metric
R18, R26: 100; R_0603_1608Metric
R21: 1k; R_0603_1608Metric
R22, R23, R28, R29: 130; R_2512_6332Metric
R31: 120; R_0603_1608Metric
R33: 390; R_0603_1608Metric
R34, R35, R39: DNP; R_0603_1608Metric
R37, R41, R42, R44: 1M; R_0603_1608Metric
R38: 0; R_0603_1608Metric
TP4, TP5, TP6, TP7, TP8, TP9, TP11, TP12, TP13, TP14, TP15: TestPoint; TestPoint_THTPad_D2.0mm_Drill1.0mm
TP10: TestPoint; TestPoint_Bridge_Pitch7.62mm_Drill1.3mm
U2: LDL1117S33R; SOT-223-3_TabPin2
U3: VDRI25W05; VDRI25
U4: VDRI15W12; VDRI25
U5, U7: HY2213-BB3A; SOT-23-6
U6: bq2057WSN; SOIC-8_3.9x4.9mm_P1.27mm
U8: LD1084V; TO-220-3_Vertical_radiator
U9: MCP3001-I/SN; SOIC-8_3.9x4.9mm_P1.27mm

Connections:
3V3: C29.1, C30.1, C60.2, C61.2, C62.2, C63.2, R9.1, TP7.1, U2.2 (VO), U9.1 (VREF), U9.8 (VDD)
5V0: C27.1, C28.1, C38.1, C39.1, D9.1 (K), K1.A2, K2.A2, K3.A2, R6.1, R8.2, R15.1, R19.1, TP6.1, U2.3 (VI), U3.14 (+VOUT)
7V4: C56.1, C57.1, J7.2, J8.1, K1.11, K2.14, R37.2, U8.2 (VI)
12V0: C49.1, C50.1, D6.2 (A), R10.1, R12.1, R32.2, TP5.1, U4.14 (+VOUT)
12V0_SENS: R40.1, R43.2, TP15.1
BAT_CHRG_STAT: D7.1 (K), D8.2 (A), U6.5 (STAT)
BAT_CHRG_TOGGLE: D1.2 (A), Q1.1 (G), R16.2
BAT_CHRG_TOGGLE_: K2.A1, K3.A1, Q1.3 (D), R15.2
BAT_RELAY_TOGGLE: Q3.1 (G), R11.1, R20.2
BAT_RELAY_TOGGLE_: K1.A1, Q3.3 (D), R19.2
GND: BT3.2 (-), C26.1, C27.2, C28.2, C29.2, C30.2, C38.2, C39.2, C40.2, C41.1, C49.2, C50.2, C51.2, C53.2, C54.2, C55.2, C56.2, C57.2, C58.2, C59.2, C60.1, C61.1, C62.1, C63.1, D2.1 (K), D3.1 (K), D4.1 (K), D5.1 (K), Q1.2 (S), Q3.2 (S), Q5.2 (S), R7.2, R13.2, R14.2, R16.1, R20.1, R25.1, R30.1, R38.2, R39.2, R43.1, R44.2, TP9.1, TP10.1, TP14.1, U2.1 (GND), U3.16 (-VOUT), U4.16 (-VOUT), U6.6 (VSS), U7.3 (VSS), U9.3 (IN-), U9.4 (VSS)
GND_IN: C31.2, C32.2, C33.2, C40.1, C42.2, C43.2, C44.2, C51.1, J6.3, J6.4, L1.1, L2.1, TP8.1
unnamed: BT2.1 (+), F1.2, TP11.1
unnamed: BT2.2 (-), BT3.1 (+), J9.2, K3.14, TP12.1
unnamed: C34.1, C35.1, C36.1, C37.1, L1.3, U3.22 (+VIN), U3.23 (+VIN)
unnamed: C34.2, C35.2, C36.2, C37.2, L1.4, U3.2 (-VIN), U3.3 (-VIN)
unnamed: C45.1, C46.1, C47.1, C48.1, L2.3, U4.22 (+VIN), U4.23 (+VIN)
unnamed: C45.2, C46.2, C47.2, C48.2, L2.4, U4.2 (-VIN), U4.3 (-VIN)
unnamed: C52.1, R18.1, U5.2 (VDD)
unnamed: C52.2, J9.1, K3.11, Q4.2 (S), R26.2, R28.2, R29.1, U5.3 (VSS)
unnamed: C54.1, D6.1 (K), R17.1, R21.2, R24.2, R27.2, U6.3 (VCC), U6.8 (COMP)
unnamed: C55.1, R26.1, U7.2 (VDD)
unnamed: C58.1, C59.1, D9.2 (A), R31.1, TP13.1, U8.3 (VO)
unnamed: D1.1 (K), R13.1
unnamed: D2.2 (A), R8.1
unnamed: D3.2 (A), R9.2
unnamed: D4.2 (A), R10.2
unnamed: D5.2 (A), R11.2
unnamed: D7.2 (A), R27.1
unnamed: D8.1 (K), R30.2
unnamed: F1.1, J8.2, K1.14
unnamed: Q2.1 (G), R21.1, U6.7 (CC)
unnamed: Q2.2 (S), R17.2, U6.1 (SNS)
unnamed: Q4.1 (G), U5.6 (OUT)
unnamed: Q4.3 (D), R22.1, R23.2
unnamed: Q5.1 (G), U7.6 (OUT)
unnamed: Q5.3 (D), R28.1, R29.2
unnamed: R6.2, R7.1, U3.11 (REG)
unnamed: R12.2, R14.1, U4.11 (REG)
unnamed: R24.1, R25.2, U6.4 (TS)
unnamed: R31.2, R33.1, R34.1, U8.1 (ADJ)
unnamed: R32.1, R36.2
unnamed: R33.2, R35.2, R38.1
unnamed: R34.2, R35.1, R39.1
unnamed: R36.1, R40.2
unnamed: R37.1, R41.2
unnamed: R41.1, R42.2
unnamed: R42.1, R44.1, U9.2 (IN+)
PACK_CHARGE+: C53.1, J7.1, K2.11, Q2.3 (D), R18.2, R22.2, R23.1, U6.2 (BAT)
SPI1_STM32_ADC_BAT_CS: U9.5 (CS)
SPI1_STM32_CLK: U9.7 (CLK)
SPI1_STM32_MISO: U9.6 (DOUT)
VIN: C26.2, C31.1, C32.1, C33.1, C41.2, C42.1, C43.1, C44.1, J6.1, J6.2, L1.2, L2.2, TP4.1

Notes on the sheet:
390-5.31 400-5.4
