buglalis/degree/KiCad/Examples/impeller18/rpi.kicad_sch

## KiCad design KiCad/Examples/impeller18/rpi.kicad_sch (2025-03-23)

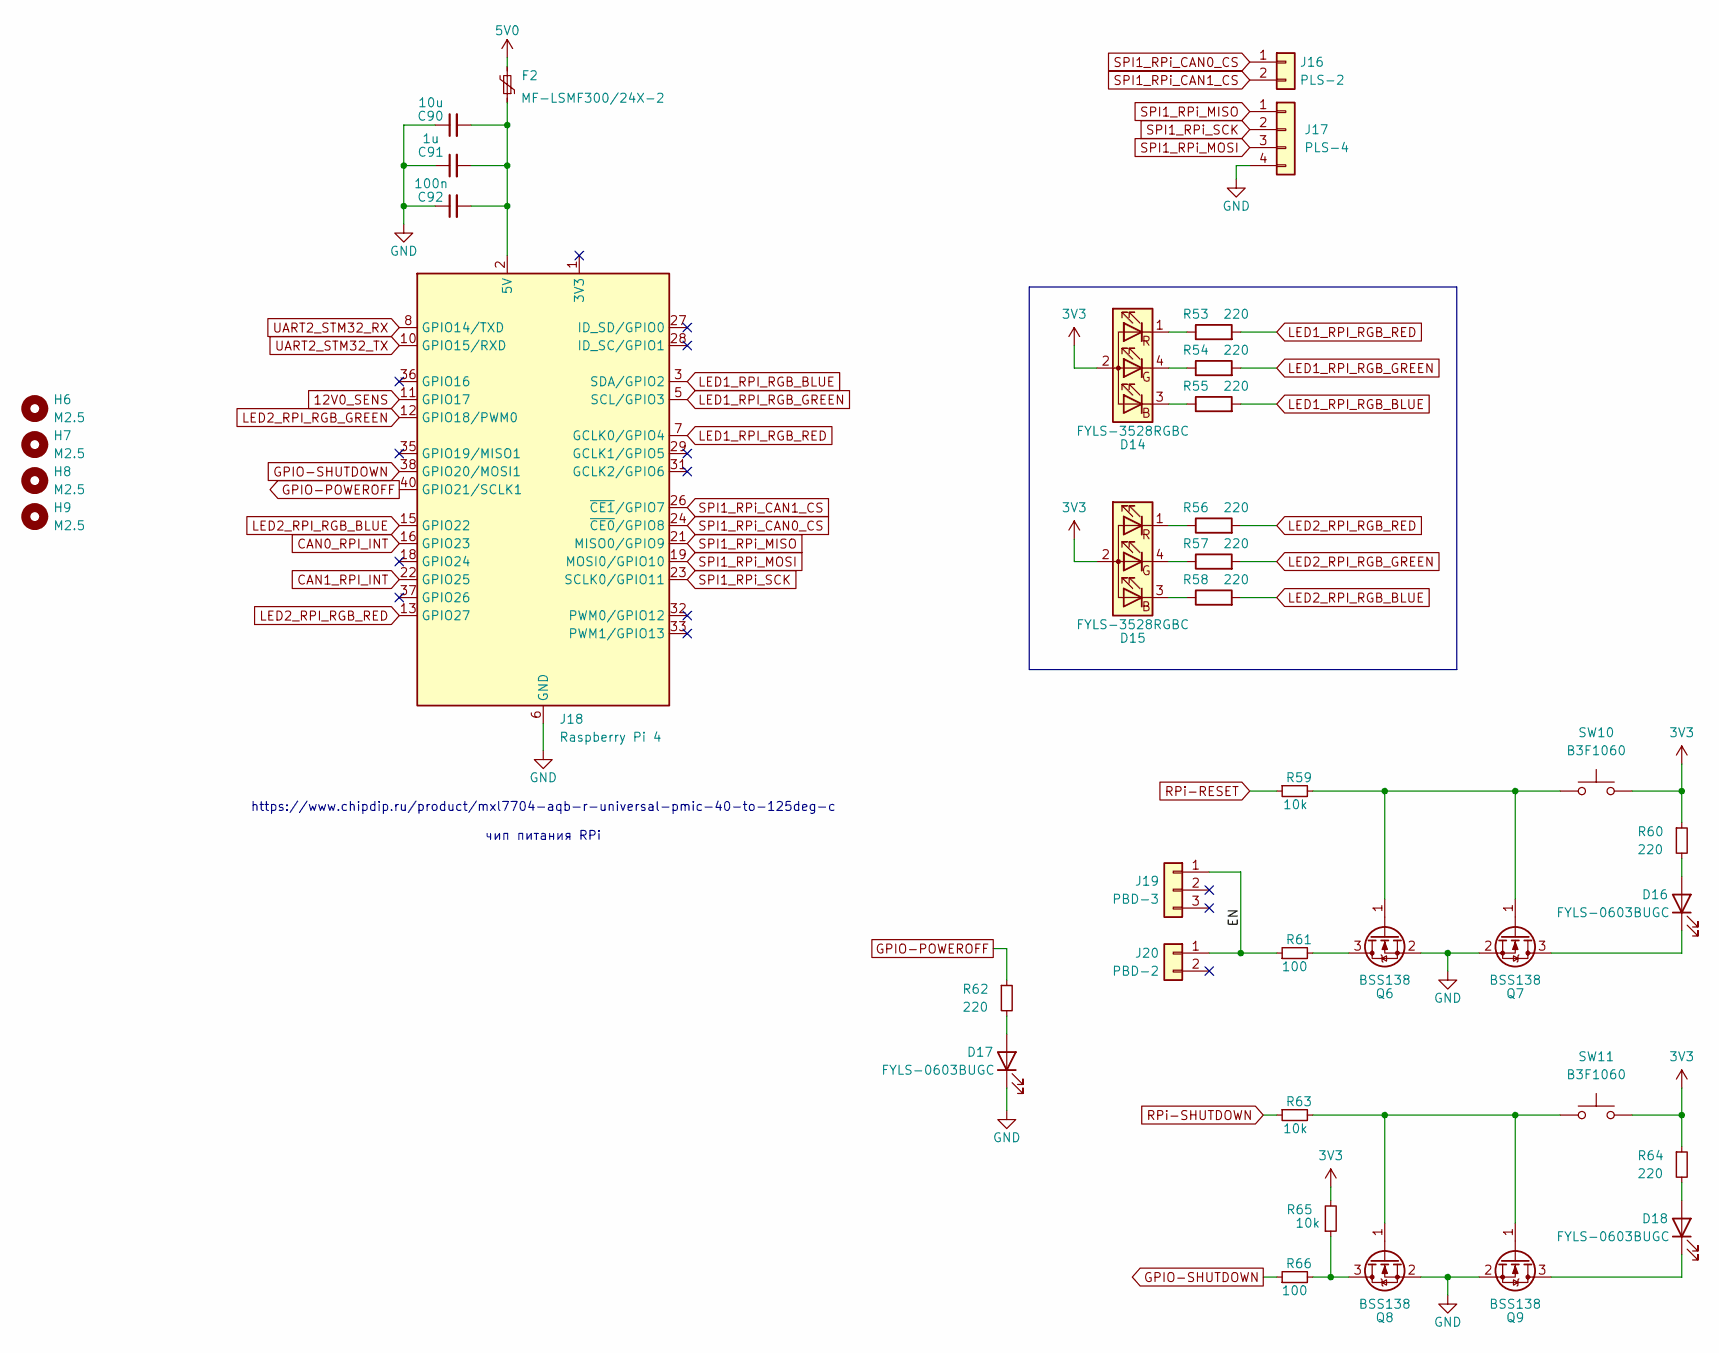
[picture p58: schematic rpi.kicad_sch]

Parts:
C90: 10u; C_0603_1608Metric
C91: 1u; C_0603_1608Metric
C92: 100n; C_0603_1608Metric
D14, D15: FYLS-3528RGBC; LED_RGB_promelec
D16, D17, D18: FYLS-0603BUGC; LED_0603_1608Metric
F2: MF-LSMF300/24X-2; Fuse_2920_7451Metric
H6, H7, H8, H9: M2.5; MountingHole_2.7mm_M2.5_Pad_Via
J16: PLS-2; PinHeader_1x02_P2.54mm_Vertical
J17: PLS-4; PinHeader_2x02_P2.54mm_Vertical
J18: Raspberry Pi 4; RPi
J19: PBD-3; PinSocket_1x03_P2.54mm_Vertical
J20: PBD-2; PinSocket_1x02_P2.54mm_Vertical
Q6, Q7, Q8, Q9: BSS138; SOT-23
R53, R54, R55, R56, R57, R58, R60, R62, R64: 220; R_0603_1608Metric
R59, R63, R65: 10k; R_0603_1608Metric
R61, R66: 100; R_0603_1608Metric
SW10, SW11: B3F1060; SW_PUSH_6mm_H5mm

Connections:
3V3: D14.2 (A), D15.2 (A), R60.1, R64.1, R65.2, SW10.2, SW11.2
5V0: F2.2
12V0_SENS: J18.11 (GPIO17)
CAN0_RPI_INT: J18.16 (GPIO23)
CAN1_RPI_INT: J18.22 (GPIO25)
EN: J19.1, J20.1, R61.1
GND: C90.1, C91.1, C92.1, D17.1 (K), J17.4, J18.6 (GND), J18.9 (GND), J18.14 (GND), J18.20 (GND), J18.25 (GND), J18.30 (GND), J18.34 (GND), J18.39 (GND), Q6.2 (S), Q7.2 (S), Q8.2 (S), Q9.2 (S)
GPIO-POWEROFF: J18.40 (GPIO21/SCLK1), R62.1
GPIO-SHUTDOWN: J18.38 (GPIO20/MOSI1), R66.1
LED1_RPI_RGB_BLUE: J18.3 (SDA/GPIO2), R55.2
LED1_RPI_RGB_GREEN: J18.5 (SCL/GPIO3), R54.2
LED1_RPI_RGB_RED: J18.7 (GCLK0/GPIO4), R53.2
LED2_RPI_RGB_BLUE: J18.15 (GPIO22), R58.2
LED2_RPI_RGB_GREEN: J18.12 (GPIO18/PWM0), R57.2
LED2_RPI_RGB_RED: J18.13 (GPIO27), R56.2
unnamed: C90.2, C91.2, C92.2, F2.1, J18.2 (5V), J18.4 (5V)
unnamed: D14.1 (RK), R53.1
unnamed: D14.3 (BK), R55.1
unnamed: D14.4 (GK), R54.1
unnamed: D15.1 (RK), R56.1
unnamed: D15.3 (BK), R58.1
unnamed: D15.4 (GK), R57.1
unnamed: D16.1 (K), Q7.3 (D)
unnamed: D16.2 (A), R60.2
unnamed: D17.2 (A), R62.2
unnamed: D18.1 (K), Q9.3 (D)
unnamed: D18.2 (A), R64.2
unnamed: J18.1 (3V3), J18.17 (3V3)
unnamed: Q6.1 (G), Q7.1 (G), R59.2, SW10.1
unnamed: Q6.3 (D), R61.2
unnamed: Q8.1 (G), Q9.1 (G), R63.2, SW11.1
unnamed: Q8.3 (D), R65.1, R66.2
RPi-RESET: R59.1
RPi-SHUTDOWN: R63.1
SPI1_RPi_CAN0_CS: J16.1, J18.24 (~CE0/GPIO8)
SPI1_RPi_CAN1_CS: J16.2, J18.26 (~CE1/GPIO7)
SPI1_RPi_MISO: J17.1, J18.21 (MISO0/GPIO9)
SPI1_RPi_MOSI: J17.3, J18.19 (MOSI0/GPIO10)
SPI1_RPi_SCK: J17.2, J18.23 (SCLK0/GPIO11)
UART2_STM32_RX: J18.8 (GPIO14/TXD)
UART2_STM32_TX: J18.10 (GPIO15/RXD)

Notes on the sheet:
https://www.chipdip.ru/product/mxl7704-aqb-r-universal-pmic-40-to-125deg-c чип питания RPi
