buglalis/degree/KiCad/Examples/impeller18/stm32_peripherals.kicad_sch

## KiCad design KiCad/Examples/impeller18/stm32_peripherals.kicad_sch (2025-03-23)

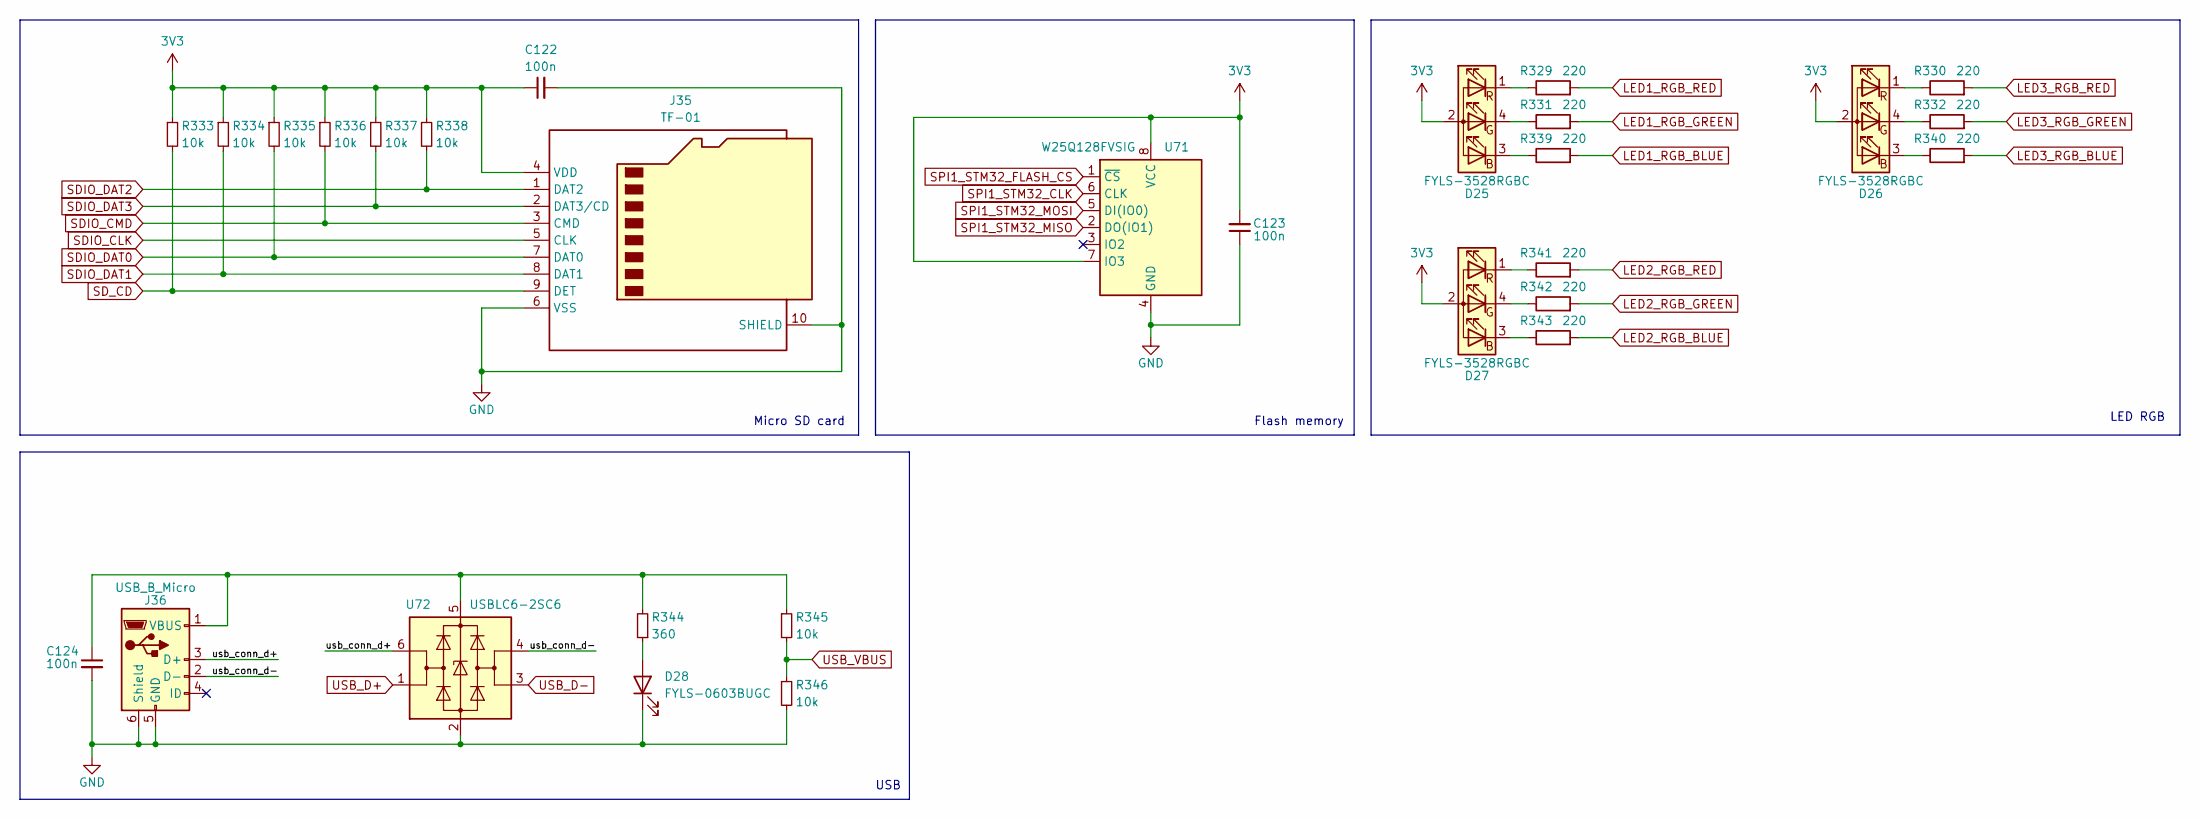
[picture p59: schematic stm32_peripherals.kicad_sch]

Parts:
C122, C123, C124: 100n; C_0603_1608Metric
D25, D26, D27: FYLS-3528RGBC; LED_RGB_promelec
D28: FYLS-0603BUGC; LED_0603_1608Metric
J35: TF-01; TF01A-NEW
J36: USB_B_Micro; U-F-M5DD-W-2-SUS
R329, R330, R331, R332, R339, R340, R341, R342, R343: 220; R_0603_1608Metric
R333, R334, R335, R336, R337, R338, R345, R346: 10k; R_0603_1608Metric
R344: 360; R_0603_1608Metric
U71: W25Q128FVSIG; SOIC-8_5.23x5.23mm_P1.27mm
U72: USBLC6-2SC6; SOT-23-6

Connections:
3V3: C122.1, C123.2, D25.2 (A), D26.2 (A), D27.2 (A), J35.4 (VDD), R333.1, R334.1, R335.1, R336.1, R337.1, R338.1, U71.7 (IO3), U71.8 (VCC)
GND: C122.2, C123.1, C124.2, D28.1 (K), J35.6 (VSS), J35.10 (SHIELD), J36.5 (GND), J36.6 (Shield), R346.2, U71.4 (GND), U72.2 (GND)
LED1_RGB_BLUE: R339.2
LED1_RGB_GREEN: R331.2
LED1_RGB_RED: R329.2
LED2_RGB_BLUE: R343.2
LED2_RGB_GREEN: R342.2
LED2_RGB_RED: R341.2
LED3_RGB_BLUE: R340.2
LED3_RGB_GREEN: R332.2
LED3_RGB_RED: R330.2
unnamed: C124.1, J36.1 (VBUS), R344.2, R345.1, U72.5 (VBUS)
unnamed: D25.1 (RK), R329.1
unnamed: D25.3 (BK), R339.1
unnamed: D25.4 (GK), R331.1
unnamed: D26.1 (RK), R330.1
unnamed: D26.3 (BK), R340.1
unnamed: D26.4 (GK), R332.1
unnamed: D27.1 (RK), R341.1
unnamed: D27.3 (BK), R343.1
unnamed: D27.4 (GK), R342.1
unnamed: D28.2 (A), R344.1
SDIO_CLK: J35.5 (CLK)
SDIO_CMD: J35.3 (CMD), R336.2
SDIO_DAT0: J35.7 (DAT0), R335.2
SDIO_DAT1: J35.8 (DAT1), R334.2
SDIO_DAT2: J35.1 (DAT2), R338.2
SDIO_DAT3: J35.2 (DAT3/CD), R337.2
SD_CD: J35.9 (DET), R333.2
SPI1_STM32_CLK: U71.6 (CLK)
SPI1_STM32_FLASH_CS: U71.1 (~CS)
SPI1_STM32_MISO: U71.2 (DO(IO1))
SPI1_STM32_MOSI: U71.5 (DI(IO0))
USB_D+: U72.1 (I/O1)
USB_D-: U72.3 (I/O2)
USB_VBUS: R345.2, R346.1
usb_conn_d+: J36.3 (D+), U72.6 (I/O1)
usb_conn_d-: J36.2 (D-), U72.4 (I/O2)

Notes on the sheet:
Micro SD card
LED RGB
USB
Flash memory
