buglalis/degree/KiCad/Examples/impeller18/switches_1.kicad_sch

## KiCad design KiCad/Examples/impeller18/switches_1.kicad_sch (2025-03-23)

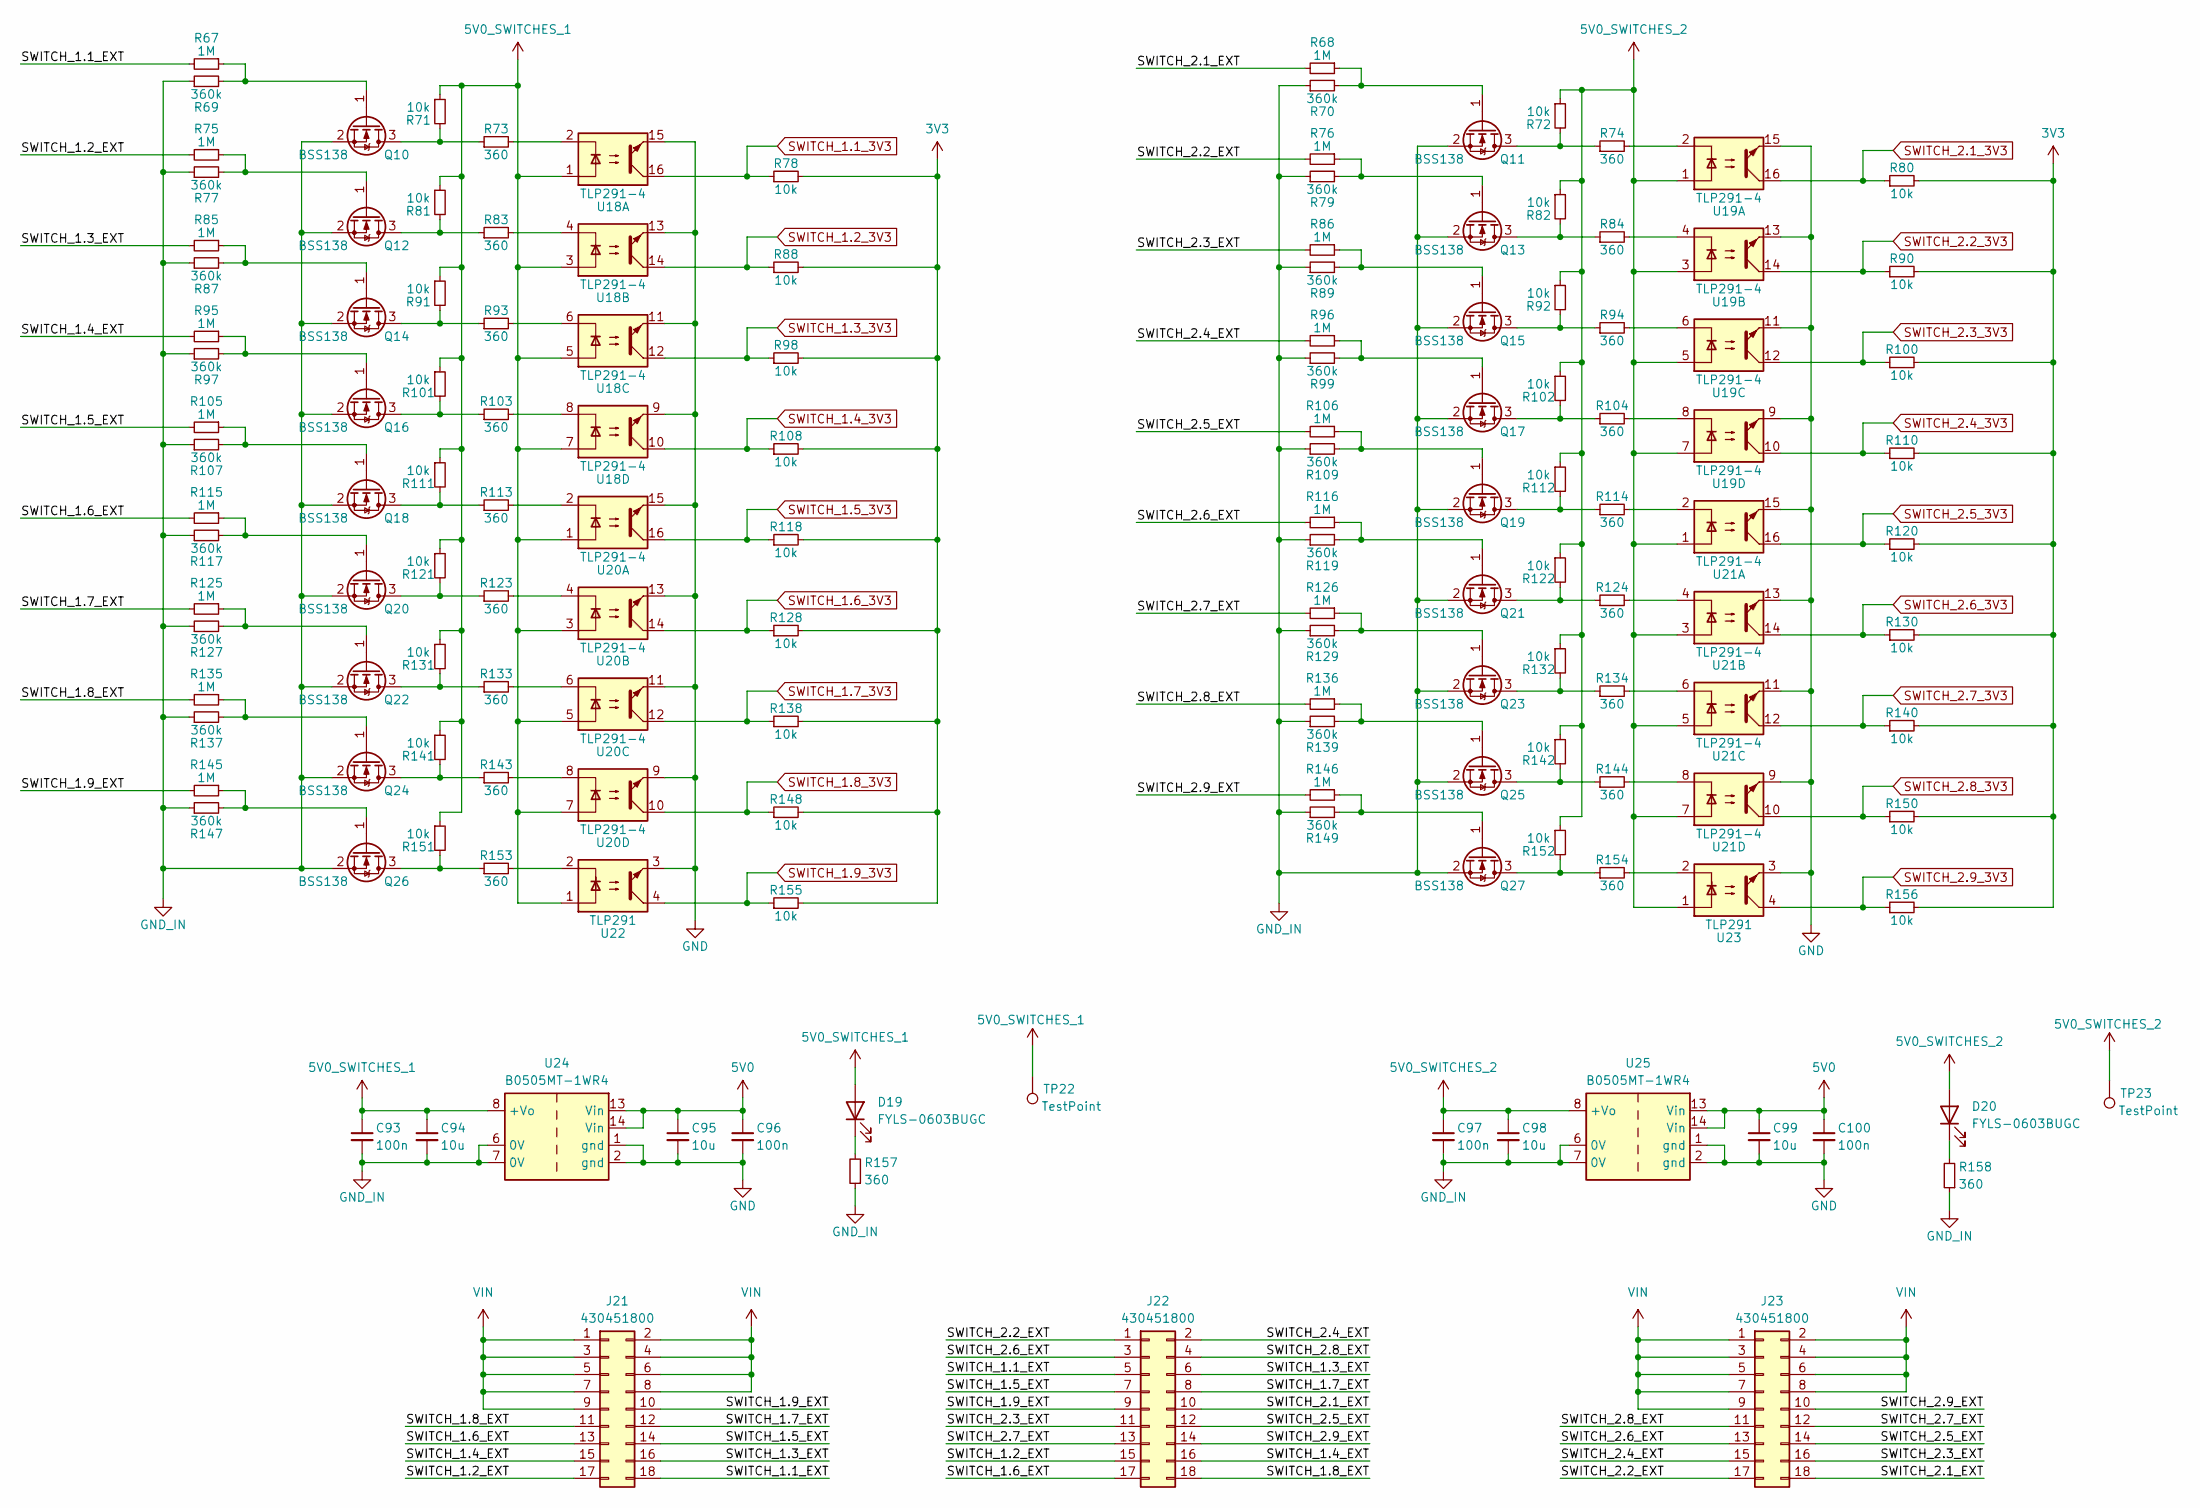
[picture p60: schematic switches_1.kicad_sch]

Parts:
C93, C96, C97, C100: 100n; C_0603_1608Metric
C94, C95, C98, C99: 10u; C_0603_1608Metric
D19, D20: FYLS-0603BUGC; LED_0603_1608Metric
J21, J22, J23: 430451800
Q10, Q11, Q12, Q13, Q14, Q15, Q16, Q17, Q18, Q19, Q20, Q21, Q22, Q23, Q24, Q25, Q26, Q27: BSS138; SOT-23
R67, R68, R75, R76, R85, R86, R95, R96, R105, R106, R115, R116, R125, R126, R135, R136, R145, R146: 1M; R_0603_1608Metric
R69, R70, R77, R79, R87, R89, R97, R99, R107, R109, R117, R119, R127, R129, R137, R139, R147, R149: 360k; R_0603_1608Metric
R71, R72, R78, R80, R81, R82, R88, R90, R91, R92, R98, R100, R101, R102, R108, R110, R111, R112, R118, R120, R121, R122, R128, R130, R131, R132, R138, R140, R141, R142, R148, R150, R151, R152, R155, R156: 10k; R_0603_1608Metric
R73, R74, R83, R84, R93, R94, R103, R104, R113, R114, R123, R124, R133, R134, R143, R144, R153, R154, R157, R158: 360; R_0603_1608Metric
TP22: TestPoint; TestPoint_THTPad_D1.5mm_Drill0.7mm
TP23: TestPoint; TestPoint_THTPad_D2.0mm_Drill1.0mm
U18, U19, U20, U21: TLP291-4; SOIC-16_4.55x10.3mm_P1.27mm
U22, U23: TLP291
U24, U25: B0505MT-1WR4

Connections:
3V3: R78.2, R80.2, R88.2, R90.2, R98.2, R100.2, R108.2, R110.2, R118.2, R120.2, R128.2, R130.2, R138.2, R140.2, R148.2, R150.2, R155.2, R156.2
5V0: C95.1, C96.1, C99.1, C100.1, U24.13 (Vin), U24.14 (Vin), U25.13 (Vin), U25.14 (Vin)
5V0_SWITCHES_1: C93.1, C94.1, D19.2 (A), R71.1, R81.1, R91.1, R101.1, R111.1, R121.1, R131.1, R141.1, R151.1, TP22.1, U18.1, U18.3, U18.5, U18.7, U20.1, U20.3, U20.5, U20.7, U22.1, U24.8 (+Vo)
5V0_SWITCHES_2: C97.1, C98.1, D20.2 (A), R72.1, R82.1, R92.1, R102.1, R112.1, R122.1, R132.1, R142.1, R152.1, TP23.1, U19.1, U19.3, U19.5, U19.7, U21.1, U21.3, U21.5, U21.7, U23.1, U25.8 (+Vo)
GND: C95.2, C96.2, C99.2, C100.2, U18.9, U18.11, U18.13, U18.15, U19.9, U19.11, U19.13, U19.15, U20.9, U20.11, U20.13, U20.15, U21.9, U21.11, U21.13, U21.15, U22.3, U23.3, U24.1 (gnd), U24.2 (gnd), U25.1 (gnd), U25.2 (gnd)
GND_IN: C93.2, C94.2, C97.2, C98.2, Q10.2 (S), Q11.2 (S), Q12.2 (S), Q13.2 (S), Q14.2 (S), Q15.2 (S), Q16.2 (S), Q17.2 (S), Q18.2 (S), Q19.2 (S), Q20.2 (S), Q21.2 (S), Q22.2 (S), Q23.2 (S), Q24.2 (S), Q25.2 (S), Q26.2 (S), Q27.2 (S), R69.1, R70.1, R77.1, R79.1, R87.1, R89.1, R97.1, R99.1, R107.1, R109.1, R117.1, R119.1, R127.1, R129.1, R137.1, R139.1, R147.1, R149.1, R157.1, R158.1, U24.6 (0V), U24.7 (0V), U25.6 (0V), U25.7 (0V)
unnamed: D19.1 (K), R157.2
unnamed: D20.1 (K), R158.2
unnamed: Q10.1 (G), R67.1, R69.2
unnamed: Q10.3 (D), R71.2, R73.1
unnamed: Q11.1 (G), R68.1, R70.2
unnamed: Q11.3 (D), R72.2, R74.1
unnamed: Q12.1 (G), R75.1, R77.2
unnamed: Q12.3 (D), R81.2, R83.1
unnamed: Q13.1 (G), R76.1, R79.2
unnamed: Q13.3 (D), R82.2, R84.1
unnamed: Q14.1 (G), R85.1, R87.2
unnamed: Q14.3 (D), R91.2, R93.1
unnamed: Q15.1 (G), R86.1, R89.2
unnamed: Q15.3 (D), R92.2, R94.1
unnamed: Q16.1 (G), R95.1, R97.2
unnamed: Q16.3 (D), R101.2, R103.1
unnamed: Q17.1 (G), R96.1, R99.2
unnamed: Q17.3 (D), R102.2, R104.1
unnamed: Q18.1 (G), R105.1, R107.2
unnamed: Q18.3 (D), R111.2, R113.1
unnamed: Q19.1 (G), R106.1, R109.2
unnamed: Q19.3 (D), R112.2, R114.1
unnamed: Q20.1 (G), R115.1, R117.2
unnamed: Q20.3 (D), R121.2, R123.1
unnamed: Q21.1 (G), R116.1, R119.2
unnamed: Q21.3 (D), R122.2, R124.1
unnamed: Q22.1 (G), R125.1, R127.2
unnamed: Q22.3 (D), R131.2, R133.1
unnamed: Q23.1 (G), R126.1, R129.2
unnamed: Q23.3 (D), R132.2, R134.1
unnamed: Q24.1 (G), R135.1, R137.2
unnamed: Q24.3 (D), R141.2, R143.1
unnamed: Q25.1 (G), R136.1, R139.2
unnamed: Q25.3 (D), R142.2, R144.1
unnamed: Q26.1 (G), R145.1, R147.2
unnamed: Q26.3 (D), R151.2, R153.1
unnamed: Q27.1 (G), R146.1, R149.2
unnamed: Q27.3 (D), R152.2, R154.1
unnamed: R73.2, U18.2
unnamed: R74.2, U19.2
unnamed: R83.2, U18.4
unnamed: R84.2, U19.4
unnamed: R93.2, U18.6
unnamed: R94.2, U19.6
unnamed: R103.2, U18.8
unnamed: R104.2, U19.8
unnamed: R113.2, U20.2
unnamed: R114.2, U21.2
unnamed: R123.2, U20.4
unnamed: R124.2, U21.4
unnamed: R133.2, U20.6
unnamed: R134.2, U21.6
unnamed: R143.2, U20.8
unnamed: R144.2, U21.8
unnamed: R153.2, U22.2
unnamed: R154.2, U23.2
SWITCH_1.1_3V3: R78.1, U18.16
SWITCH_1.1_EXT: J21.18, J22.5, R67.2
SWITCH_1.2_3V3: R88.1, U18.14
SWITCH_1.2_EXT: J21.17, J22.15, R75.2
SWITCH_1.3_3V3: R98.1, U18.12
SWITCH_1.3_EXT: J21.16, J22.6, R85.2
SWITCH_1.4_3V3: R108.1, U18.10
SWITCH_1.4_EXT: J21.15, J22.16, R95.2
SWITCH_1.5_3V3: R118.1, U20.16
SWITCH_1.5_EXT: J21.14, J22.7, R105.2
SWITCH_1.6_3V3: R128.1, U20.14
SWITCH_1.6_EXT: J21.13, J22.17, R115.2
SWITCH_1.7_3V3: R138.1, U20.12
SWITCH_1.7_EXT: J21.12, J22.8, R125.2
SWITCH_1.8_3V3: R148.1, U20.10
SWITCH_1.8_EXT: J21.11, J22.18, R135.2
SWITCH_1.9_3V3: R155.1, U22.4
SWITCH_1.9_EXT: J21.10, J22.9, R145.2
SWITCH_2.1_3V3: R80.1, U19.16
SWITCH_2.1_EXT: J22.10, J23.18, R68.2
SWITCH_2.2_3V3: R90.1, U19.14
SWITCH_2.2_EXT: J22.1, J23.17, R76.2
SWITCH_2.3_3V3: R100.1, U19.12
SWITCH_2.3_EXT: J22.11, J23.16, R86.2
SWITCH_2.4_3V3: R110.1, U19.10
SWITCH_2.4_EXT: J22.2, J23.15, R96.2
SWITCH_2.5_3V3: R120.1, U21.16
SWITCH_2.5_EXT: J22.12, J23.14, R106.2
SWITCH_2.6_3V3: R130.1, U21.14
SWITCH_2.6_EXT: J22.3, J23.13, R116.2
SWITCH_2.7_3V3: R140.1, U21.12
SWITCH_2.7_EXT: J22.13, J23.12, R126.2
SWITCH_2.8_3V3: R150.1, U21.10
SWITCH_2.8_EXT: J22.4, J23.11, R136.2
SWITCH_2.9_3V3: R156.1, U23.4
SWITCH_2.9_EXT: J22.14, J23.10, R146.2
VIN: J21.1, J21.2, J21.3, J21.4, J21.5, J21.6, J21.7, J21.8, J21.9, J23.1, J23.2, J23.3, J23.4, J23.5, J23.6, J23.7, J23.8, J23.9
