buglalis/degree/KiCad/Examples/impeller18/switches_2.kicad_sch

## KiCad design KiCad/Examples/impeller18/switches_2.kicad_sch (2025-03-23)

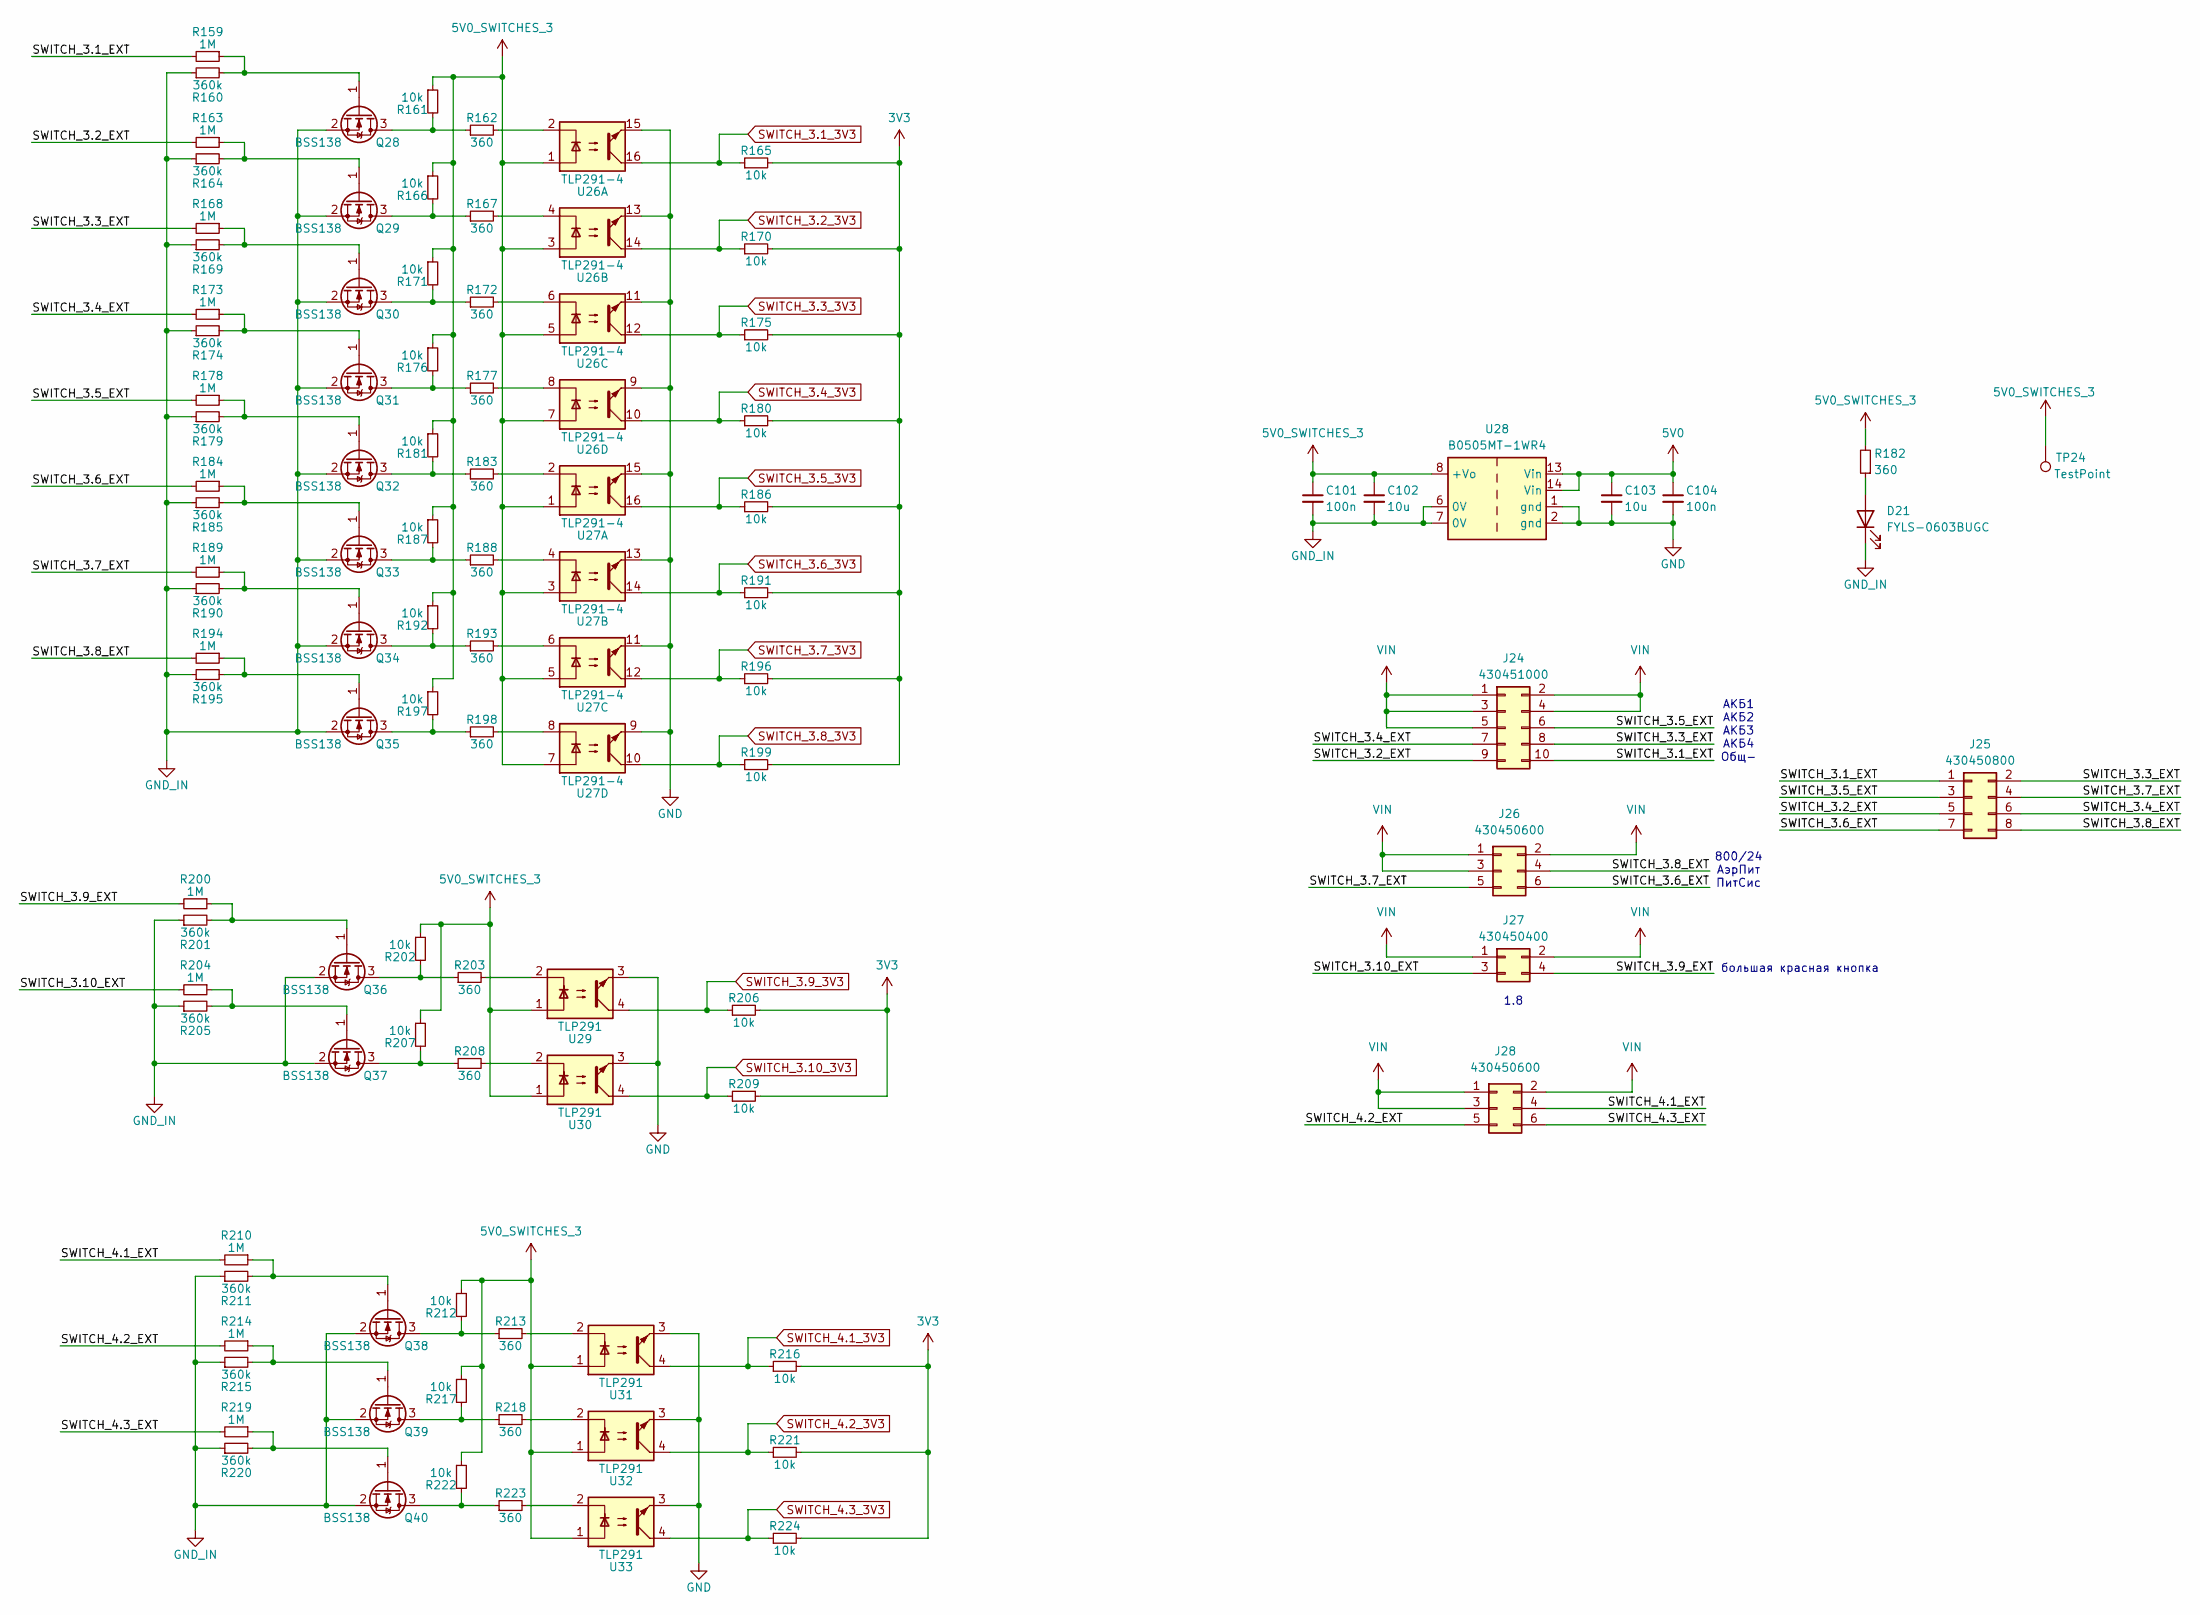
[picture p61: schematic switches_2.kicad_sch]

Parts:
C101, C104: 100n; C_0603_1608Metric
C102, C103: 10u; C_0603_1608Metric
D21: FYLS-0603BUGC; LED_0603_1608Metric
J24: 430451000
J25: 430450800
J26, J28: 430450600
J27: 430450400
Q28, Q29, Q30, Q31, Q32, Q33, Q34, Q35, Q36, Q37, Q38, Q39, Q40: BSS138; SOT-23
R159, R163, R168, R173, R178, R184, R189, R194, R200, R204, R210, R214, R219: 1M; R_0603_1608Metric
R160, R164, R169, R174, R179, R185, R190, R195, R201, R205, R211, R215, R220: 360k; R_0603_1608Metric
R161, R165, R166, R170, R171, R175, R176, R180, R181, R186, R187, R191, R192, R196, R197, R199, R202, R206, R207, R209, R212, R216, R217, R221, R222, R224: 10k; R_0603_1608Metric
R162, R167, R172, R177, R182, R183, R188, R193, R198, R203, R208, R213, R218, R223: 360; R_0603_1608Metric
TP24: TestPoint; TestPoint_THTPad_D2.0mm_Drill1.0mm
U26, U27: TLP291-4; SOIC-16_4.55x10.3mm_P1.27mm
U28: B0505MT-1WR4
U29, U30, U31, U32, U33: TLP291

Connections:
3V3: R165.2, R170.2, R175.2, R180.2, R186.2, R191.2, R196.2, R199.2, R206.2, R209.2, R216.2, R221.2, R224.2
5V0: C103.1, C104.1, U28.13 (Vin), U28.14 (Vin)
5V0_SWITCHES_3: C101.1, C102.1, R161.1, R166.1, R171.1, R176.1, R181.1, R182.2, R187.1, R192.1, R197.1, R202.1, R207.1, R212.1, R217.1, R222.1, TP24.1, U26.1, U26.3, U26.5, U26.7, U27.1, U27.3, U27.5, U27.7, U28.8 (+Vo), U29.1, U30.1, U31.1, U32.1, U33.1
GND: C103.2, C104.2, U26.9, U26.11, U26.13, U26.15, U27.9, U27.11, U27.13, U27.15, U28.1 (gnd), U28.2 (gnd), U29.3, U30.3, U31.3, U32.3, U33.3
GND_IN: C101.2, C102.2, D21.1 (K), Q28.2 (S), Q29.2 (S), Q30.2 (S), Q31.2 (S), Q32.2 (S), Q33.2 (S), Q34.2 (S), Q35.2 (S), Q36.2 (S), Q37.2 (S), Q38.2 (S), Q39.2 (S), Q40.2 (S), R160.1, R164.1, R169.1, R174.1, R179.1, R185.1, R190.1, R195.1, R201.1, R205.1, R211.1, R215.1, R220.1, U28.6 (0V), U28.7 (0V)
unnamed: D21.2 (A), R182.1
unnamed: Q28.1 (G), R159.1, R160.2
unnamed: Q28.3 (D), R161.2, R162.1
unnamed: Q29.1 (G), R163.1, R164.2
unnamed: Q29.3 (D), R166.2, R167.1
unnamed: Q30.1 (G), R168.1, R169.2
unnamed: Q30.3 (D), R171.2, R172.1
unnamed: Q31.1 (G), R173.1, R174.2
unnamed: Q31.3 (D), R176.2, R177.1
unnamed: Q32.1 (G), R178.1, R179.2
unnamed: Q32.3 (D), R181.2, R183.1
unnamed: Q33.1 (G), R184.1, R185.2
unnamed: Q33.3 (D), R187.2, R188.1
unnamed: Q34.1 (G), R189.1, R190.2
unnamed: Q34.3 (D), R192.2, R193.1
unnamed: Q35.1 (G), R194.1, R195.2
unnamed: Q35.3 (D), R197.2, R198.1
unnamed: Q36.1 (G), R200.1, R201.2
unnamed: Q36.3 (D), R202.2, R203.1
unnamed: Q37.1 (G), R204.1, R205.2
unnamed: Q37.3 (D), R207.2, R208.1
unnamed: Q38.1 (G), R210.1, R211.2
unnamed: Q38.3 (D), R212.2, R213.1
unnamed: Q39.1 (G), R214.1, R215.2
unnamed: Q39.3 (D), R217.2, R218.1
unnamed: Q40.1 (G), R219.1, R220.2
unnamed: Q40.3 (D), R222.2, R223.1
unnamed: R162.2, U26.2
unnamed: R167.2, U26.4
unnamed: R172.2, U26.6
unnamed: R177.2, U26.8
unnamed: R183.2, U27.2
unnamed: R188.2, U27.4
unnamed: R193.2, U27.6
unnamed: R198.2, U27.8
unnamed: R203.2, U29.2
unnamed: R208.2, U30.2
unnamed: R213.2, U31.2
unnamed: R218.2, U32.2
unnamed: R223.2, U33.2
SWITCH_3.1_3V3: R165.1, U26.16
SWITCH_3.1_EXT: J24.10, J25.1, R159.2
SWITCH_3.2_3V3: R170.1, U26.14
SWITCH_3.2_EXT: J24.9, J25.5, R163.2
SWITCH_3.3_3V3: R175.1, U26.12
SWITCH_3.3_EXT: J24.8, J25.2, R168.2
SWITCH_3.4_3V3: R180.1, U26.10
SWITCH_3.4_EXT: J24.7, J25.6, R173.2
SWITCH_3.5_3V3: R186.1, U27.16
SWITCH_3.5_EXT: J24.6, J25.3, R178.2
SWITCH_3.6_3V3: R191.1, U27.14
SWITCH_3.6_EXT: J25.7, J26.6, R184.2
SWITCH_3.7_3V3: R196.1, U27.12
SWITCH_3.7_EXT: J25.4, J26.5, R189.2
SWITCH_3.8_3V3: R199.1, U27.10
SWITCH_3.8_EXT: J25.8, J26.4, R194.2
SWITCH_3.9_3V3: R206.1, U29.4
SWITCH_3.9_EXT: J27.4, R200.2
SWITCH_3.10_3V3: R209.1, U30.4
SWITCH_3.10_EXT: J27.3, R204.2
SWITCH_4.1_3V3: R216.1, U31.4
SWITCH_4.1_EXT: J28.4, R210.2
SWITCH_4.2_3V3: R221.1, U32.4
SWITCH_4.2_EXT: J28.5, R214.2
SWITCH_4.3_3V3: R224.1, U33.4
SWITCH_4.3_EXT: J28.6, R219.2
VIN: J24.1, J24.2, J24.3, J24.4, J24.5, J26.1, J26.2, J26.3, J27.1, J27.2, J28.1, J28.2, J28.3

Notes on the sheet:
большая красная кнопка
1.8
800/24 АэрПит ПитСис
АКБ1 АКБ2 АКБ3 АКБ4 Общ-
