buglalis/degree/source code/Core/Inc/main.h

#define SPI1_CS_2_Pin GPIO_PIN_1
#define SPI1_CS_2_GPIO_Port GPIOA
#define SPI1_CS1_Pin GPIO_PIN_4
#define SPI1_CS1_GPIO_Port GPIOA
#define OUT_M12_Pin GPIO_PIN_7
#define OUT_M12_GPIO_Port GPIOC
#define OUT_M11_Pin GPIO_PIN_8
#define OUT_M11_GPIO_Port GPIOC
#define OUT_M10_Pin GPIO_PIN_9
#define OUT_M10_GPIO_Port GPIOC
#define OUT_M02_Pin GPIO_PIN_8
#define OUT_M02_GPIO_Port GPIOA
#define OUT_M01_Pin GPIO_PIN_9
#define OUT_M01_GPIO_Port GPIOA
#define OUT_M00_Pin GPIO_PIN_10
#define OUT_M00_GPIO_Port GPIOA
#define MPL_TEMP_2_3V3_Pin GPIO_PIN_5
#define MPL_TEMP_2_3V3_GPIO_Port GPIOB
#define MPL_TEMP_1_3V3_Pin GPIO_PIN_6
#define MPL_TEMP_1_3V3_GPIO_Port GPIOB
#define MPL_TEMP_0_3V3_Pin GPIO_PIN_7
#define MPL_TEMP_0_3V3_GPIO_Port GPIOB
