buglalis/degree/(commit log)

2025-03-13 12_03_2025 update
    [BMS.kicad_pcb]
2025-04-04 rough routing is complete (04.04.2025)
    [BMS.kicad_pcb, BMS.kicad_sch, balance.kicad_sch, power.kicad_sch, termistors.kicad_sch]
2025-05-21 fix hcpl 21.05.2025
    [BMS.kicad_pcb, balance.kicad_sch]
